elvisdt/PCB_INCLI_VA/docs/reference/ug230_superior.png

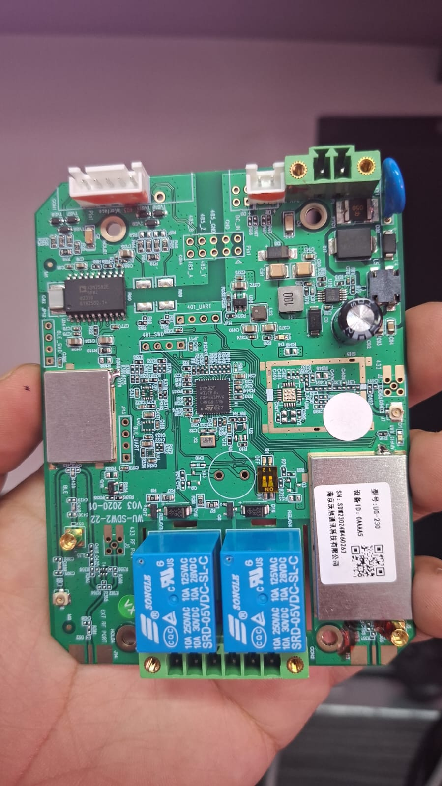
docs/reference/ug230_superior.png
