elvisdt/PCB_INCLI_VA/docs/reference/ug230_inferior.png

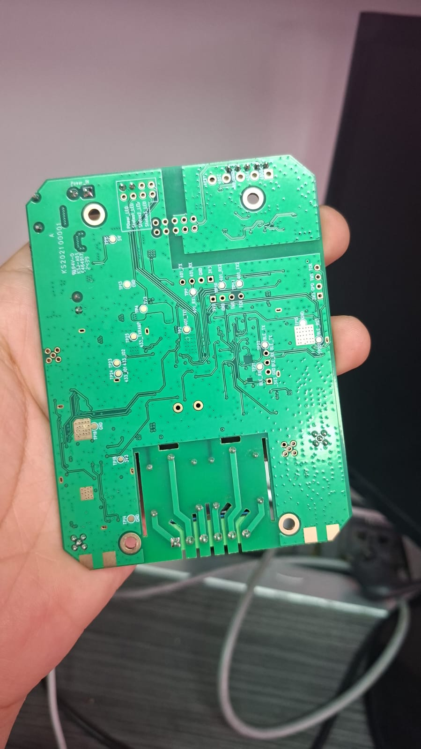
docs/reference/ug230_inferior.png
