elvisdt/PCB_INCLI_VA/docs/reference/logos/README.md

# Logos para serigrafía (B.Silkscreen)

| Archivo | Contenido | Estado |
|---|---|---|
| `volnyx_wordmark.png` | Wordmark "volnyx" en minúsculas con punto cuadrado, monocromo | Recreación para serigrafía según el logo elegido (oct 2026). Si existe el archivo original, reemplazarlo con el mismo nombre. |
| `volnyx_icon.png` | Ícono "vx" en recuadro redondeado, monocromo | Igual que arriba. Usar uno de los dos, no ambos, para no saturar. |
| `hunter.svg` / `hunter.png` | Logo de Hunter | **Pendiente:** el usuario debe dejar el archivo oficial (idealmente vectorial, pedido a marketing). |

Uso en KiCad: Image Converter (bitmap2component) → capa B.Silkscreen, 15–20 mm de ancho, trazo mínimo 0.15 mm, sin pisar TP, pads ni vías. Negro = serigrafía.
