elvisdt/PCB_INCLI_VA/docs/layout/correcciones-1ff3419-bottom.png

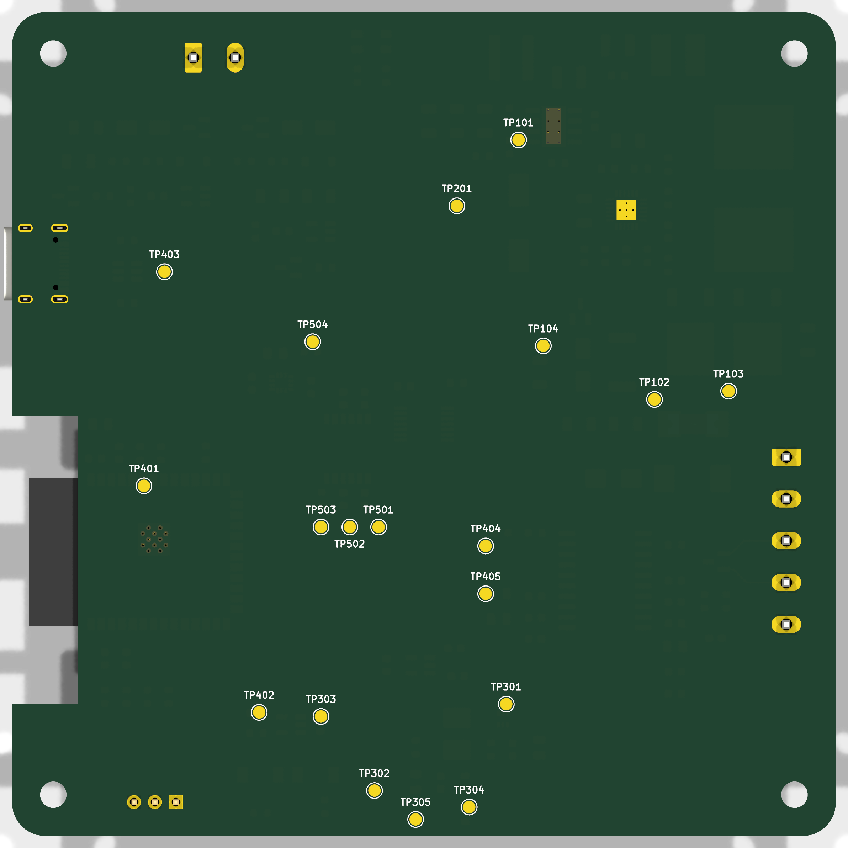
docs/layout/correcciones-1ff3419-bottom.png
