elvisdt/PCB_INCLI_VA/docs/layout/correcciones-1ff3419-top.png

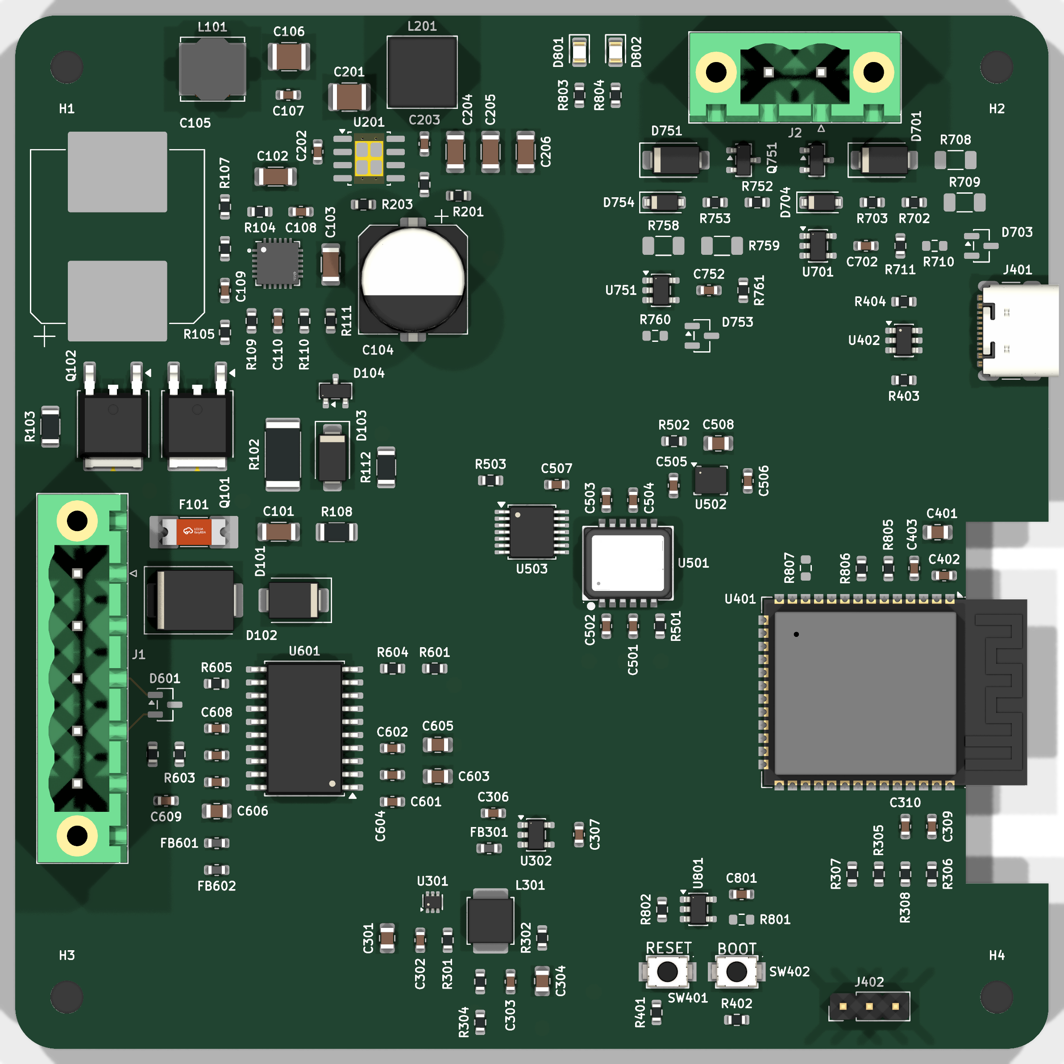
docs/layout/correcciones-1ff3419-top.png
