elvisdt/PCB_INCLI_VA/docs/layout/h5-serigrafia-bottom.png

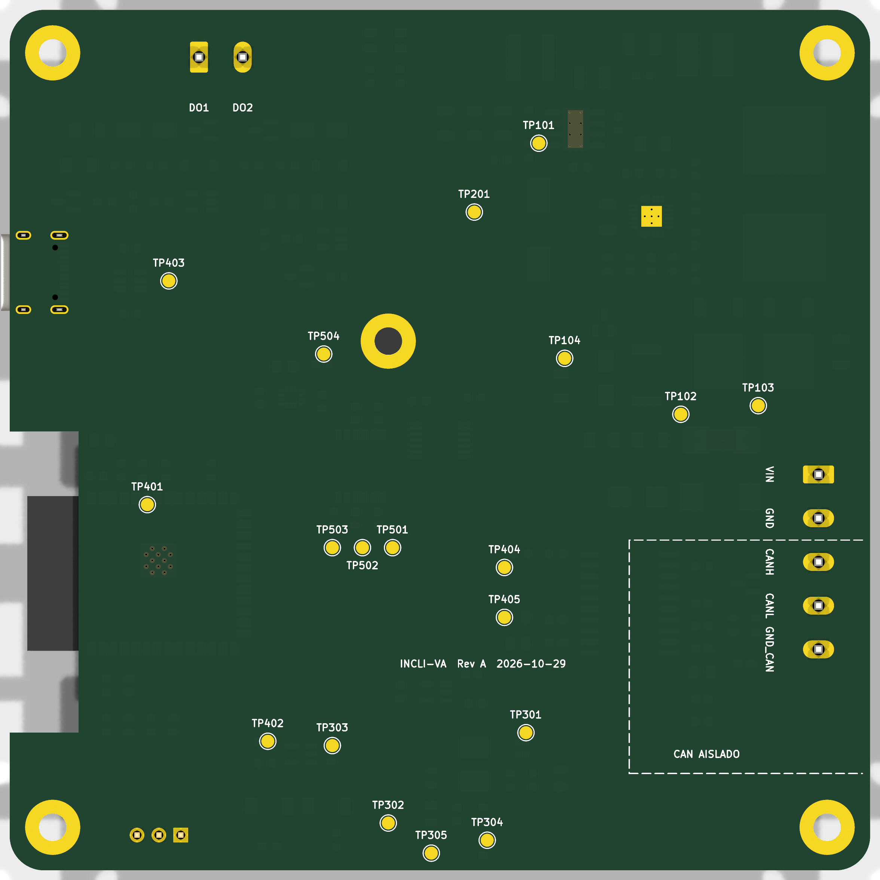
docs/layout/h5-serigrafia-bottom.png
