elvisdt/PCB_INCLI_VA/docs/layout/placement-v1-bottom.png

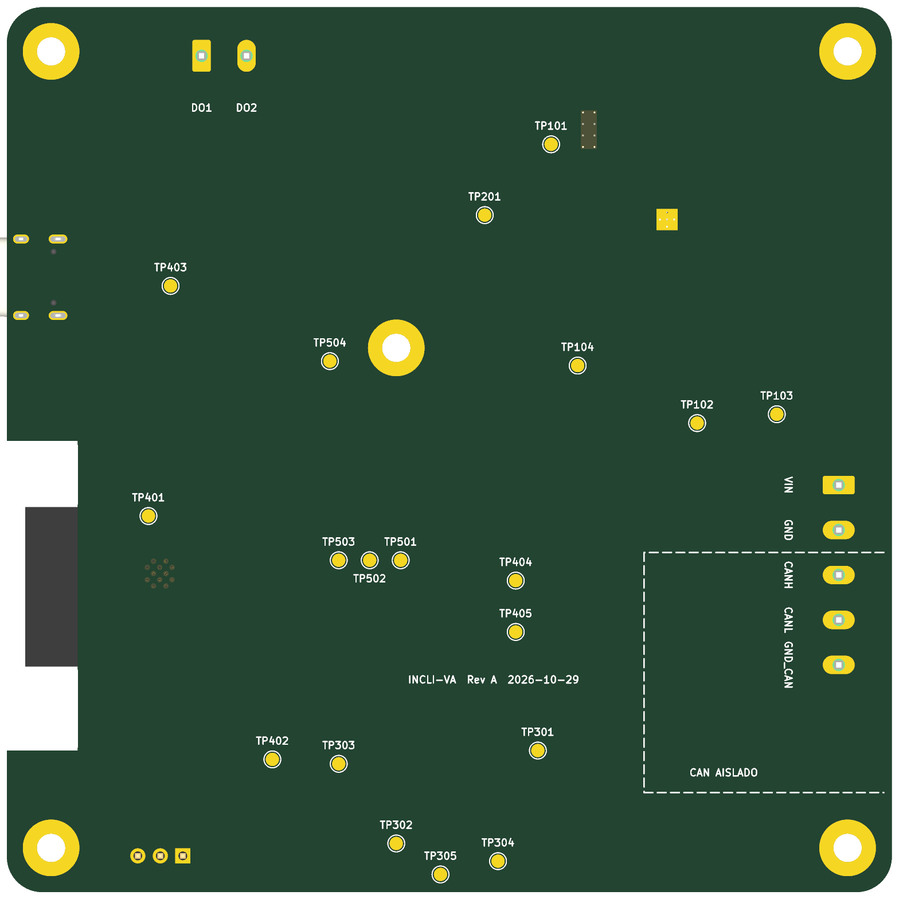
docs/layout/placement-v1-bottom.png
