elvisdt/PCB_INCLI_VA/docs/layout/placement-v1-top.png

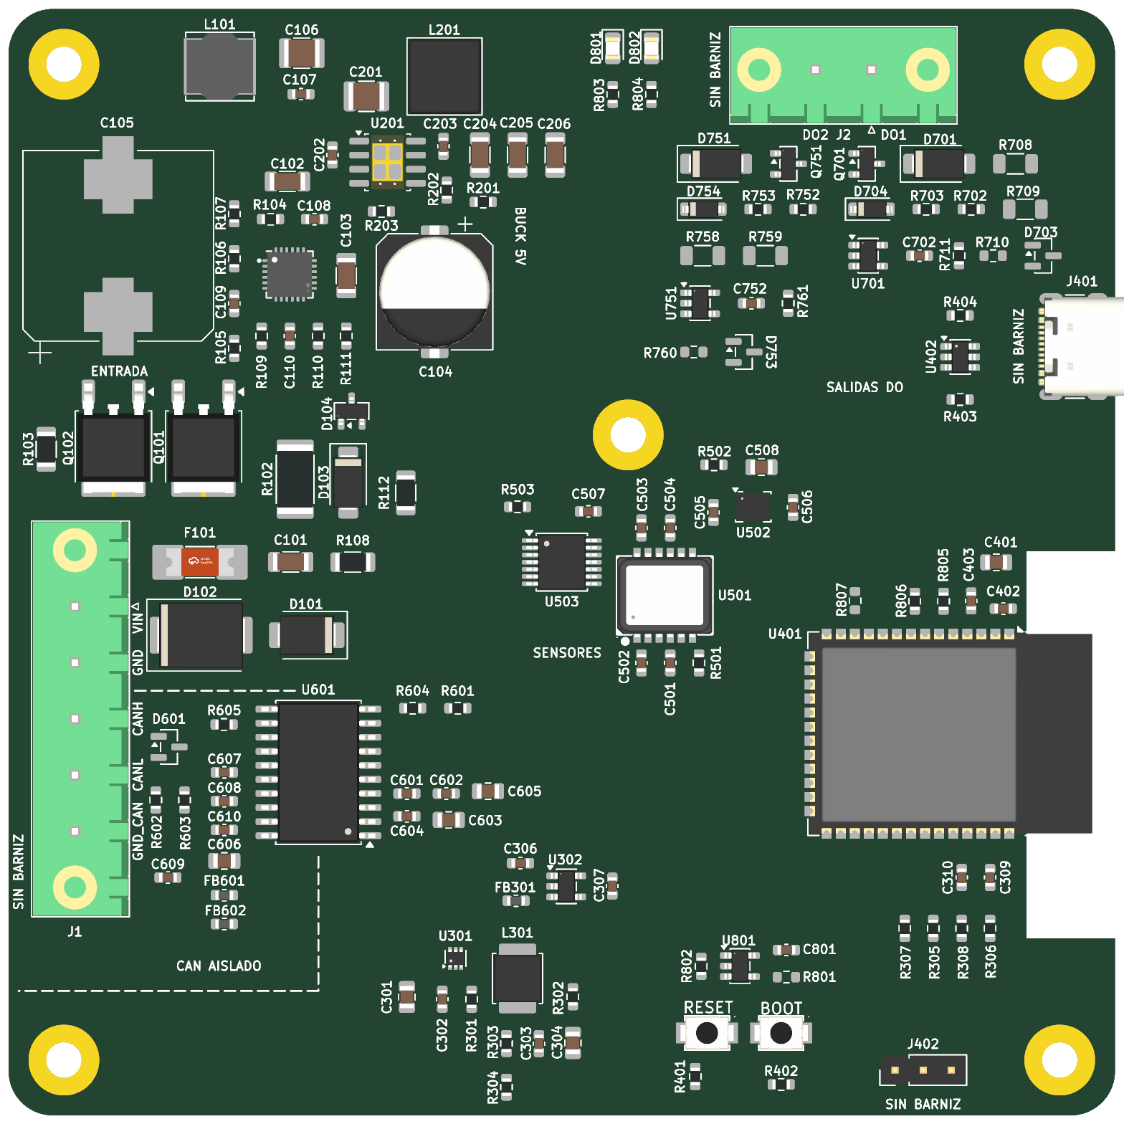
docs/layout/placement-v1-top.png
