elvisdt/PCB_INCLI_VA/docs/layout/rc6/bcu_entrada_rc5_rc6.png

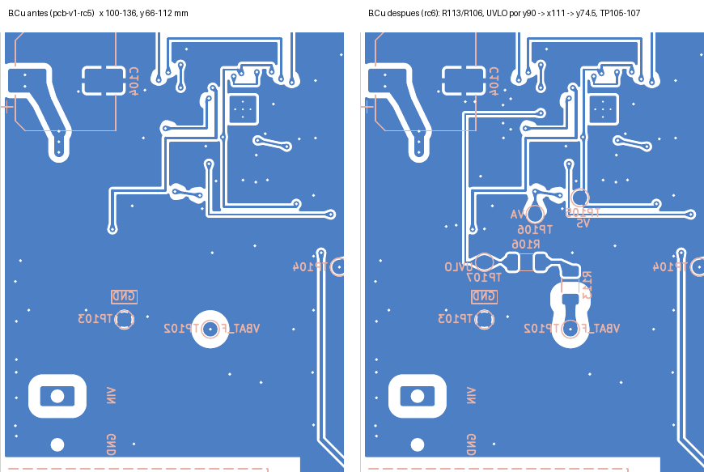
docs/layout/rc6/bcu_entrada_rc5_rc6.png
