elvisdt/PCB_INCLI_VA/docs/layout/rc7/jp601_cara_inferior.png

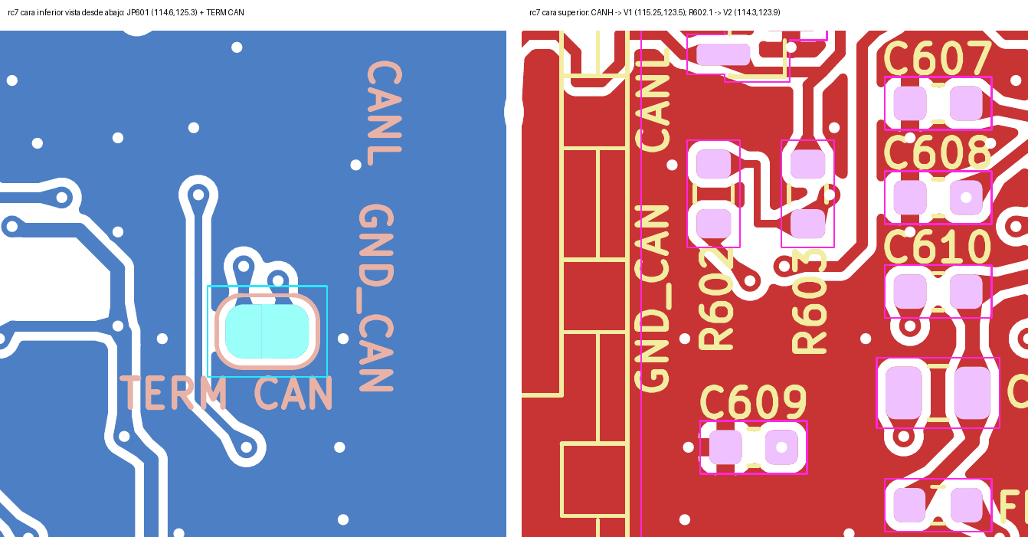
docs/layout/rc7/jp601_cara_inferior.png
