elvisdt/PCB_INCLI_VA/docs/layout/reacomodo-antes-despues.png

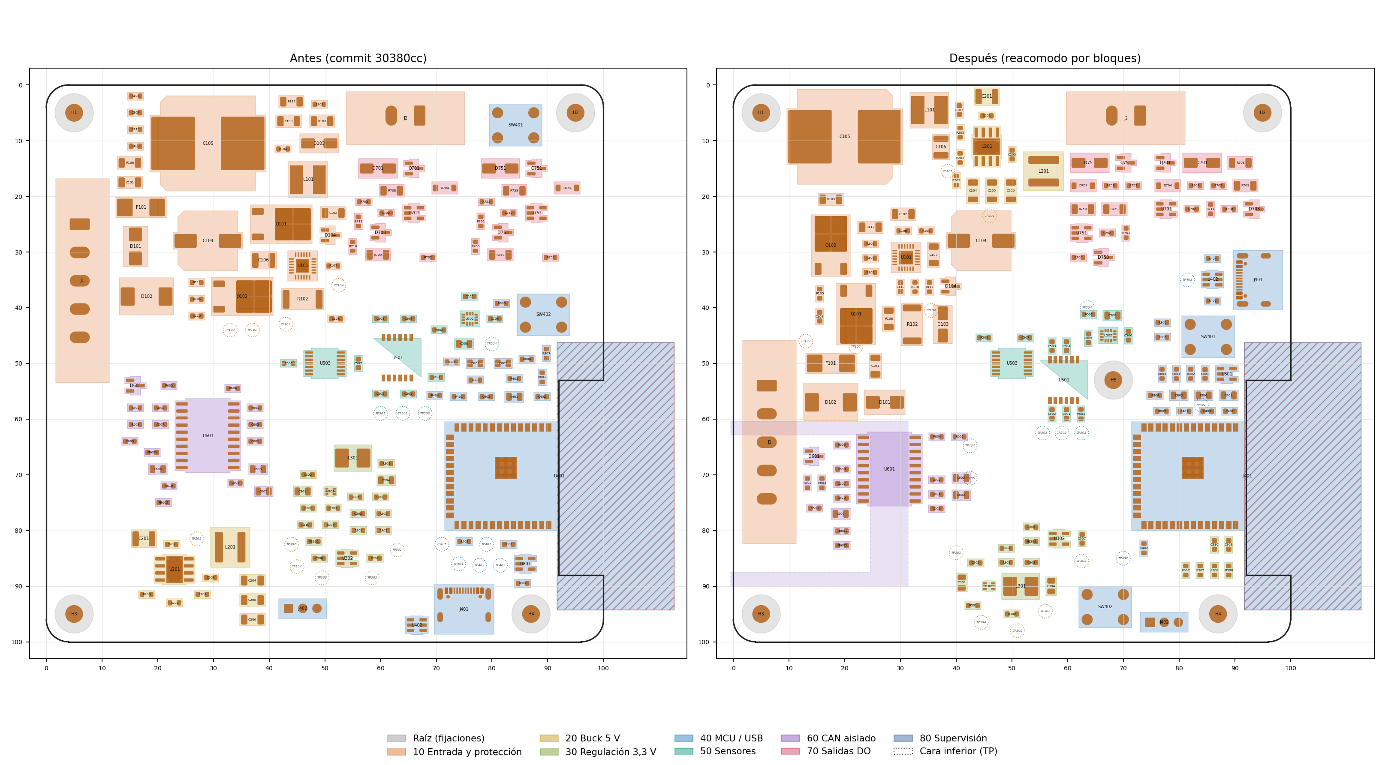
docs/layout/reacomodo-antes-despues.png
