elvisdt/PCB_INCLI_VA/docs/layout/ruteo/can-bcu-auditoria.png

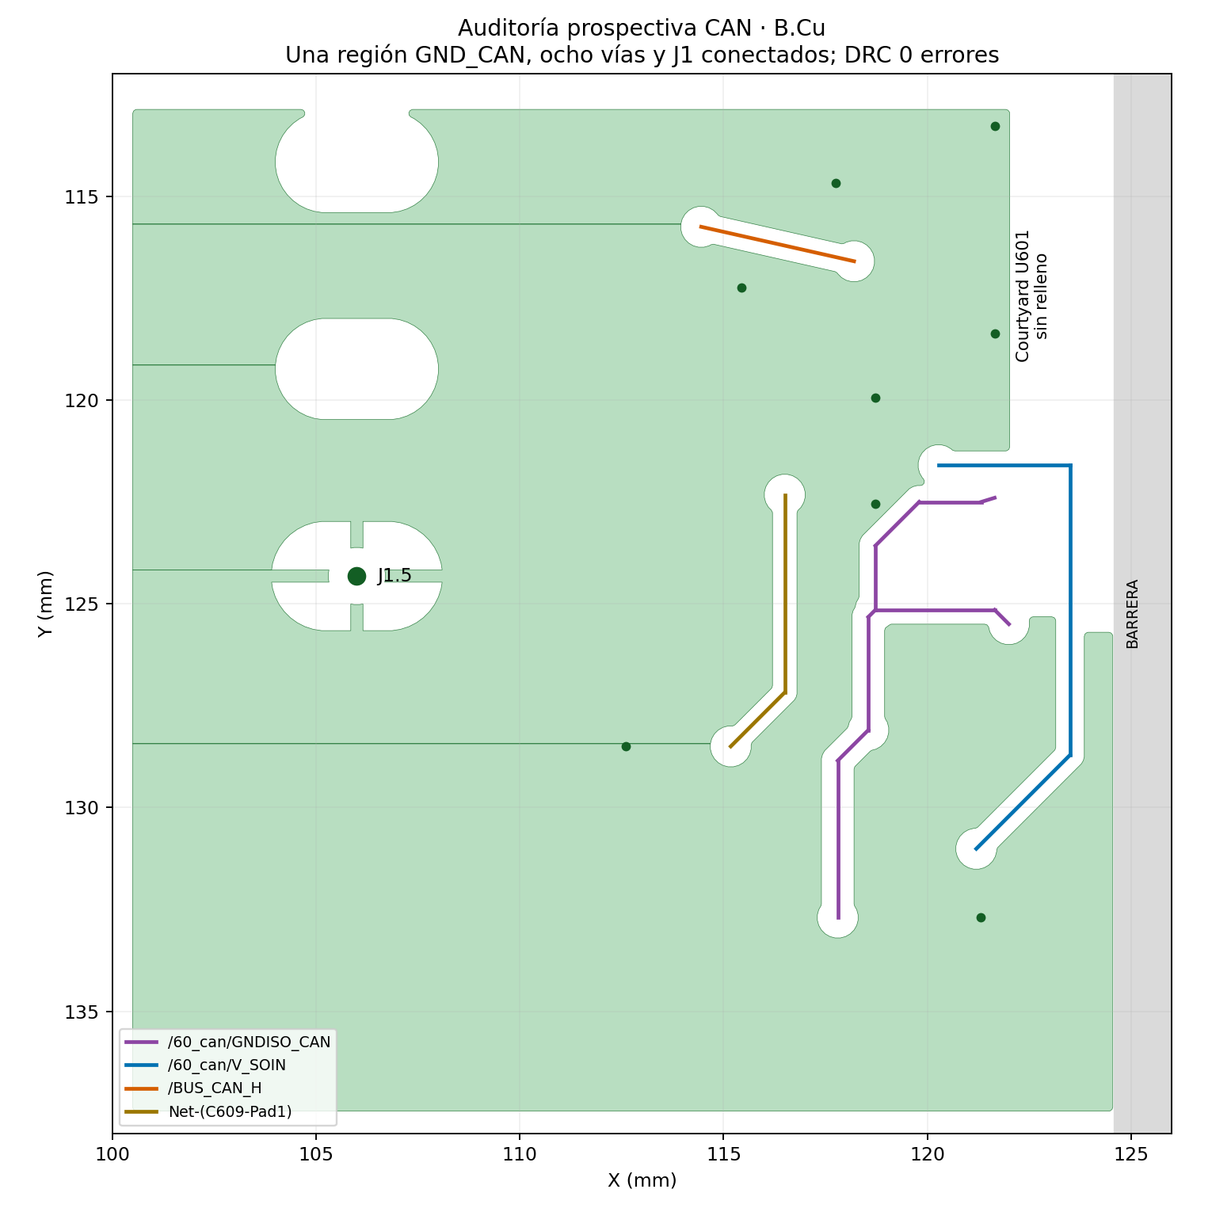
docs/layout/ruteo/can-bcu-auditoria.png
