elvisdt/PCB_INCLI_VA/docs/layout/ruteo/etapa3-hoja40.png

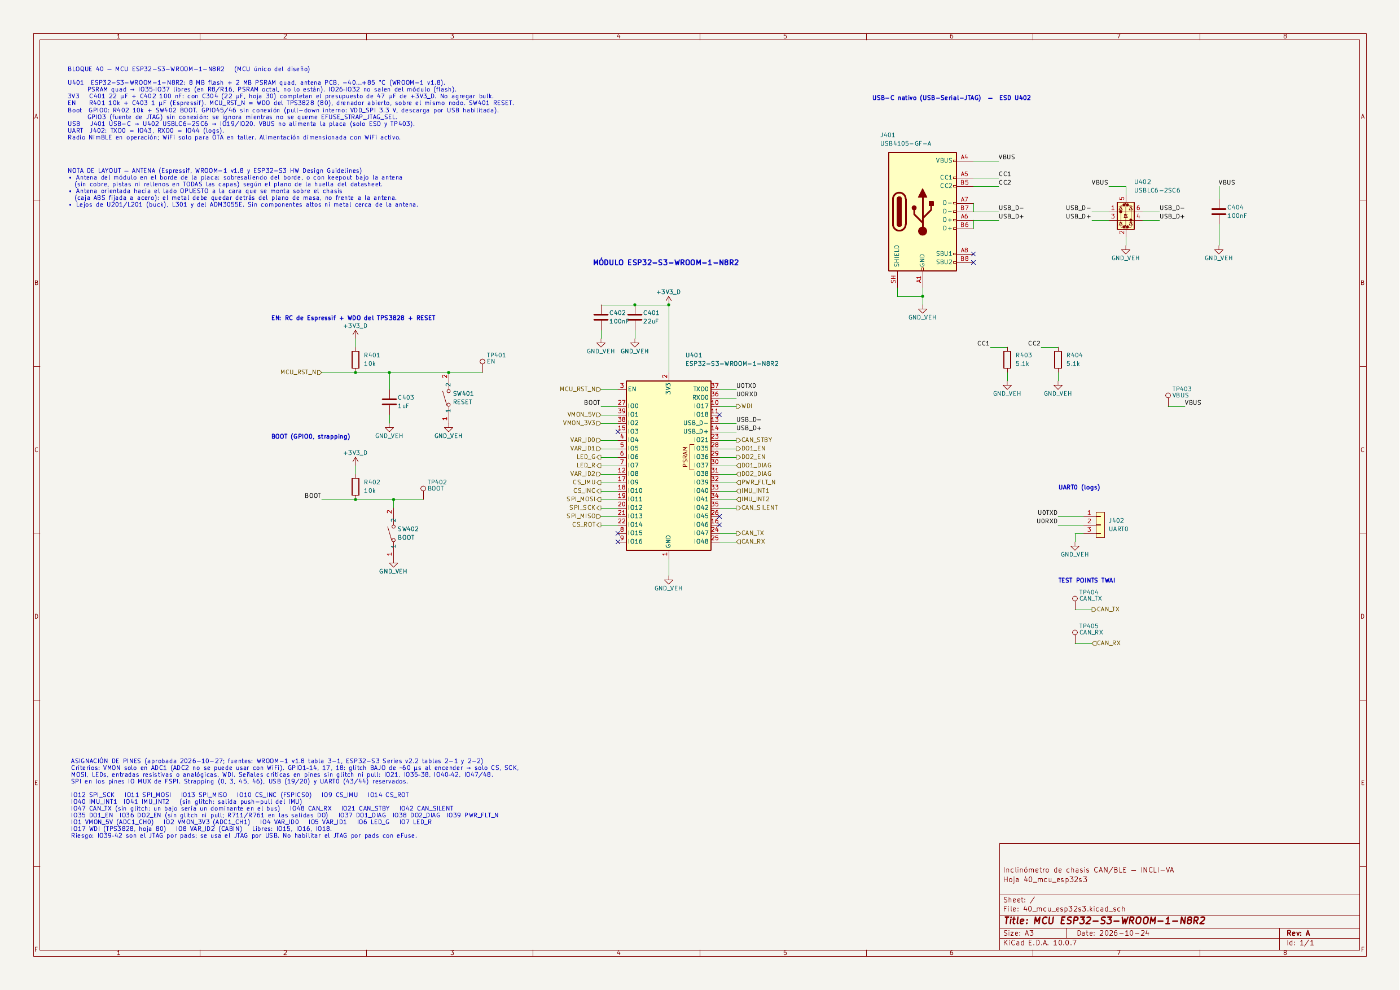
docs/layout/ruteo/etapa3-hoja40.png
