elvisdt/PCB_INCLI_VA/docs/layout/ruteo/etapa3-parcial-bottom.png

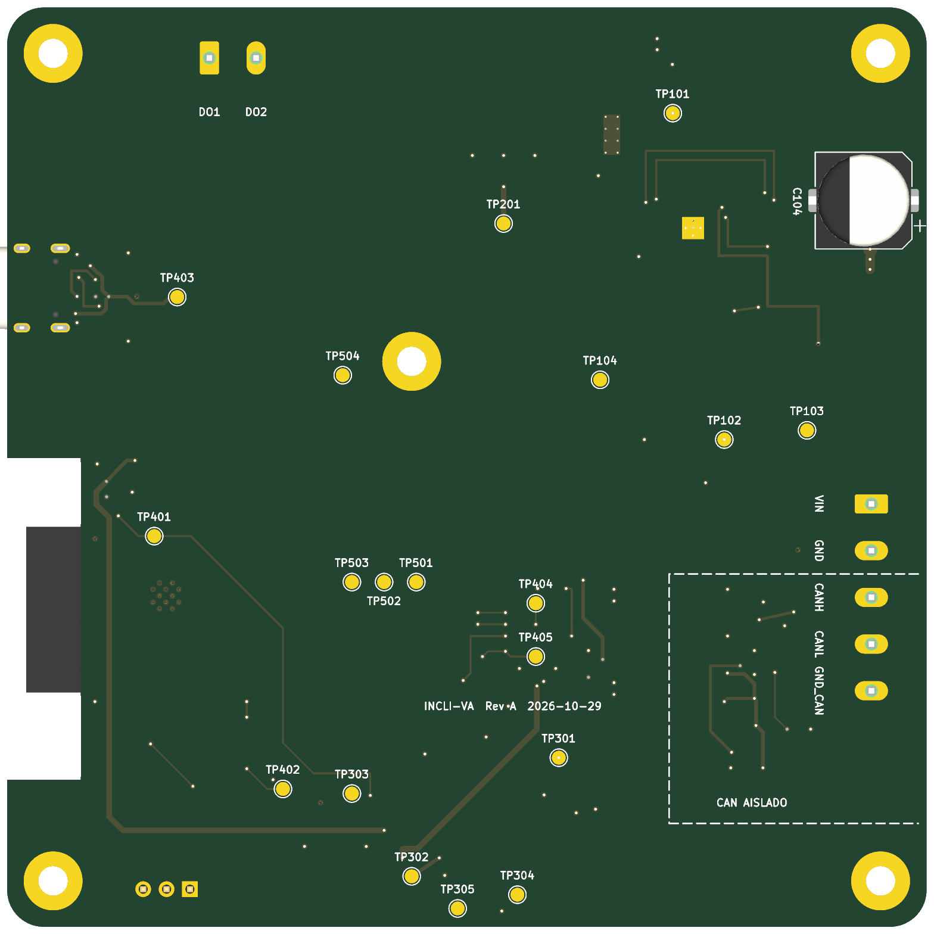
docs/layout/ruteo/etapa3-parcial-bottom.png
