elvisdt/PCB_INCLI_VA/docs/layout/ruteo/etapa3-propuesta-usb-escape.png

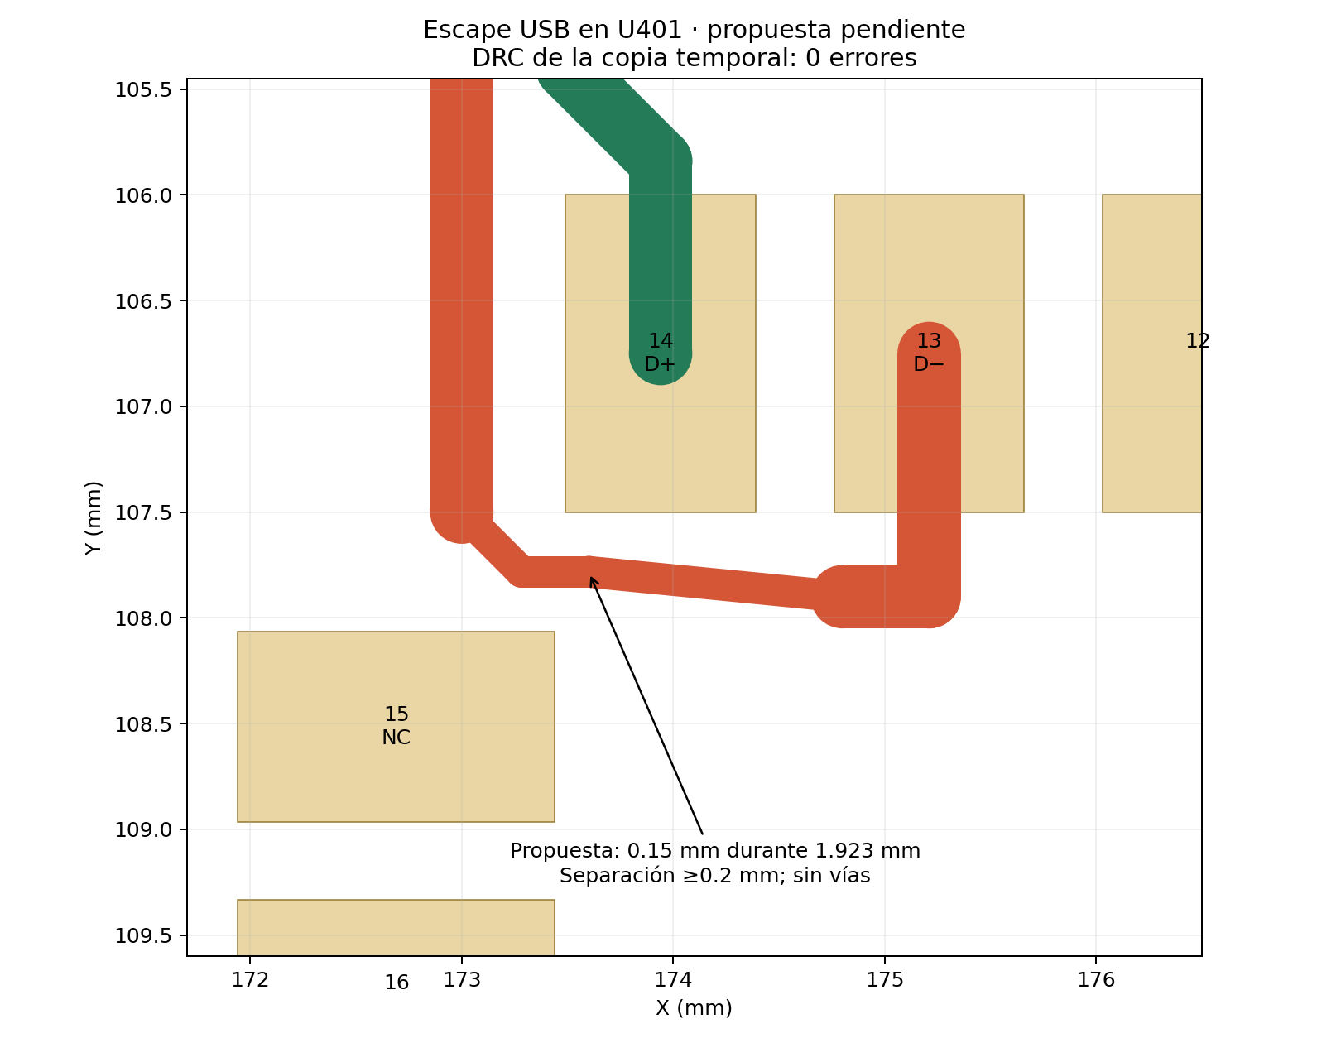
docs/layout/ruteo/etapa3-propuesta-usb-escape.png
