elvisdt/PCB_INCLI_VA/docs/layout/ruteo/etapa4-parcial-top.png

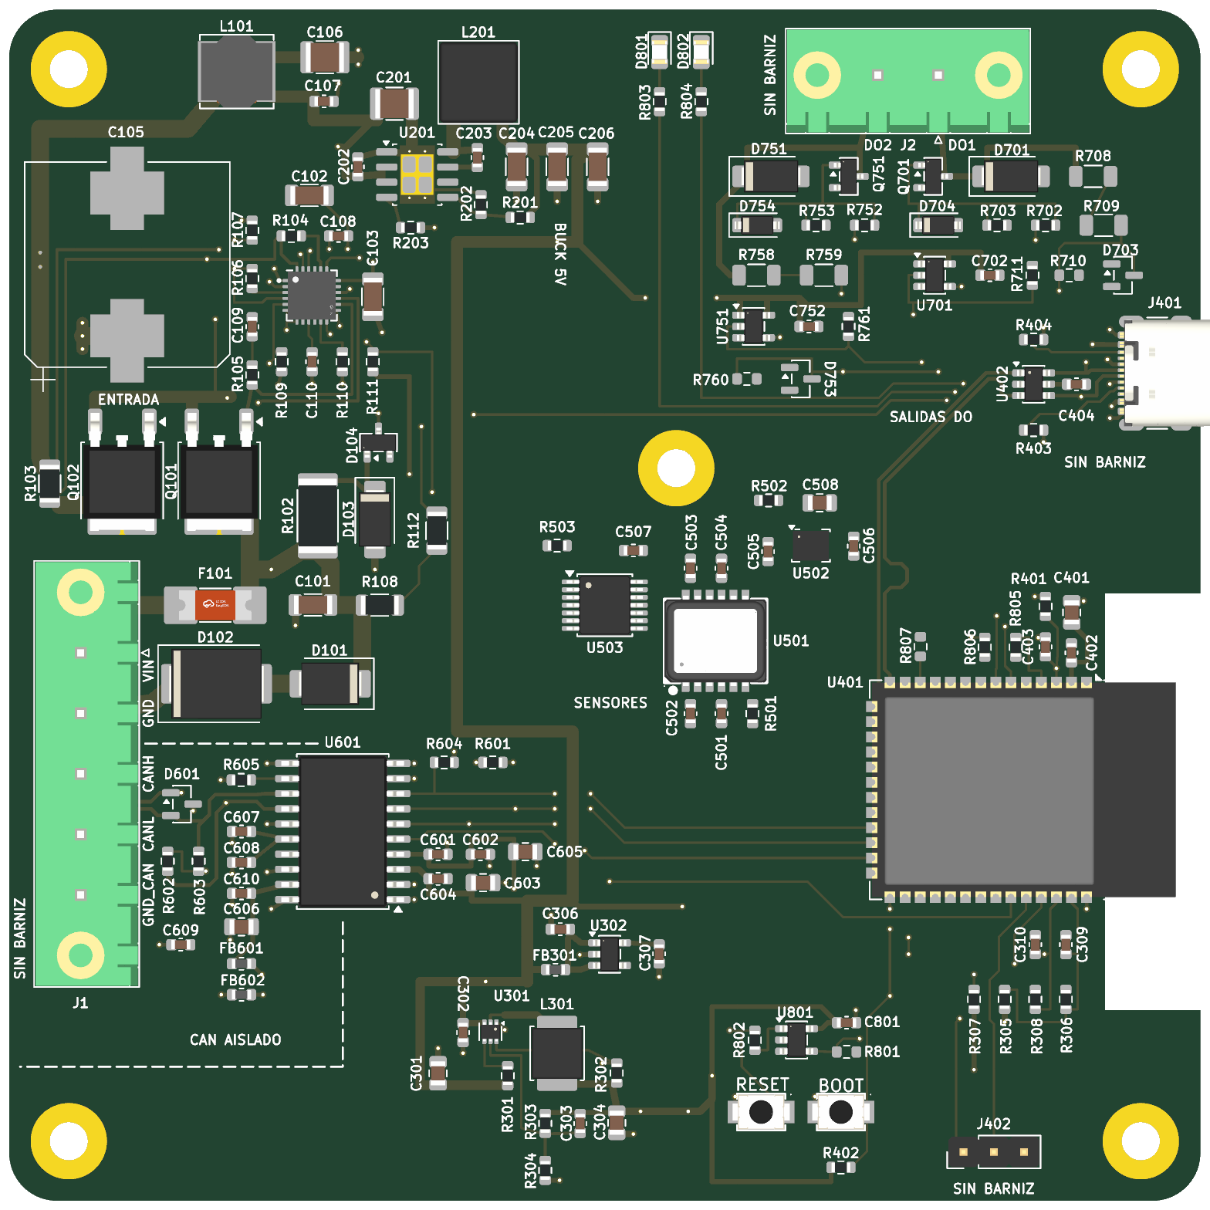
docs/layout/ruteo/etapa4-parcial-top.png
