elvisdt/PCB_INCLI_VA/docs/layout/ruteo/etapa4-sensores-cruces.png

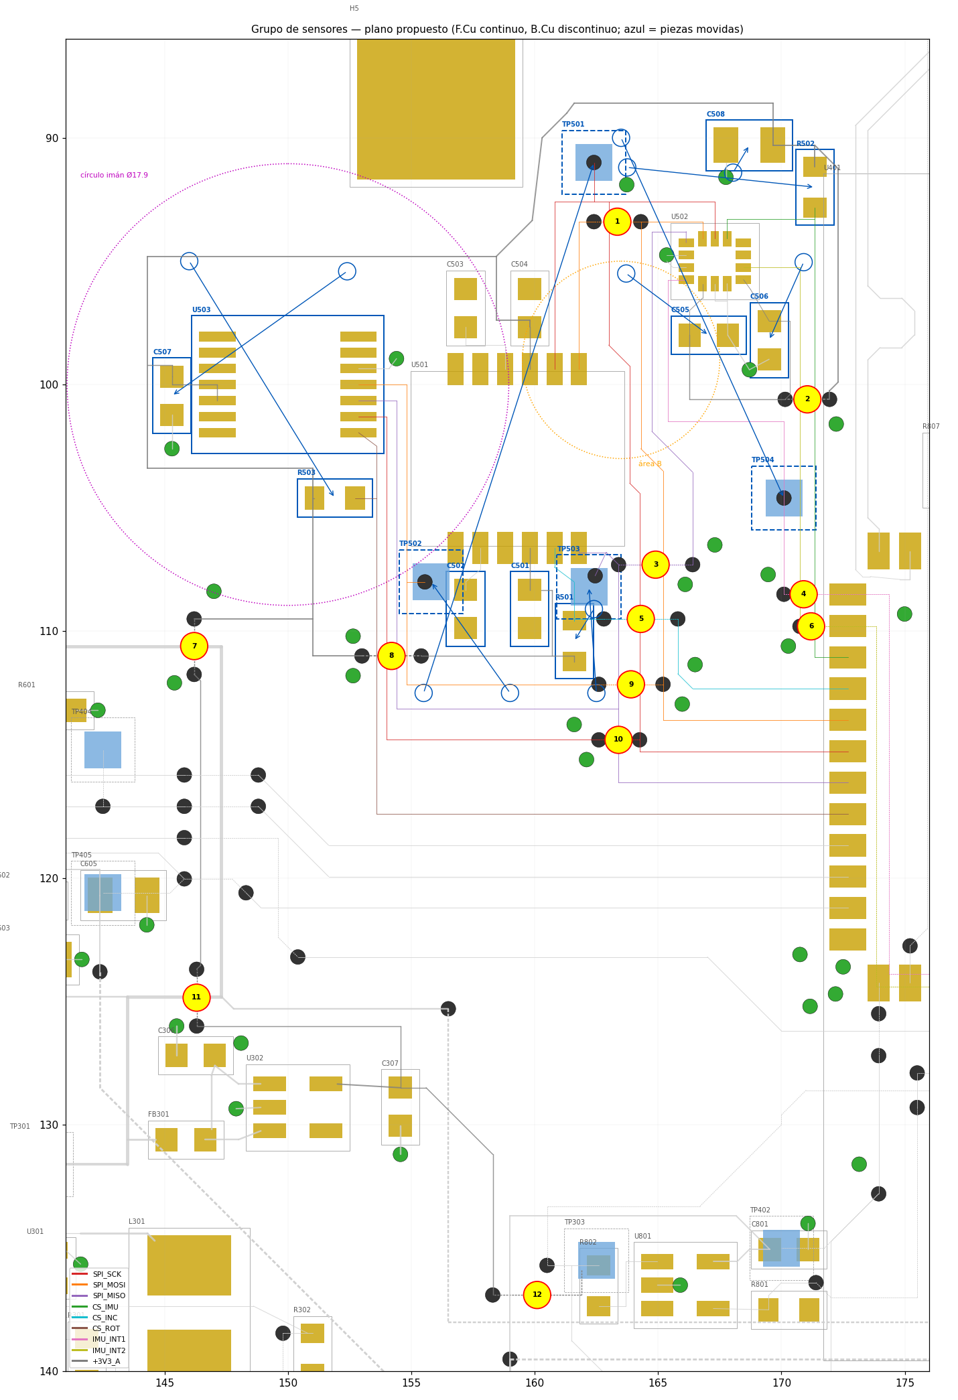
docs/layout/ruteo/etapa4-sensores-cruces.png
