elvisdt/PCB_INCLI_VA/docs/layout/ruteo/etapa5-bottom.png

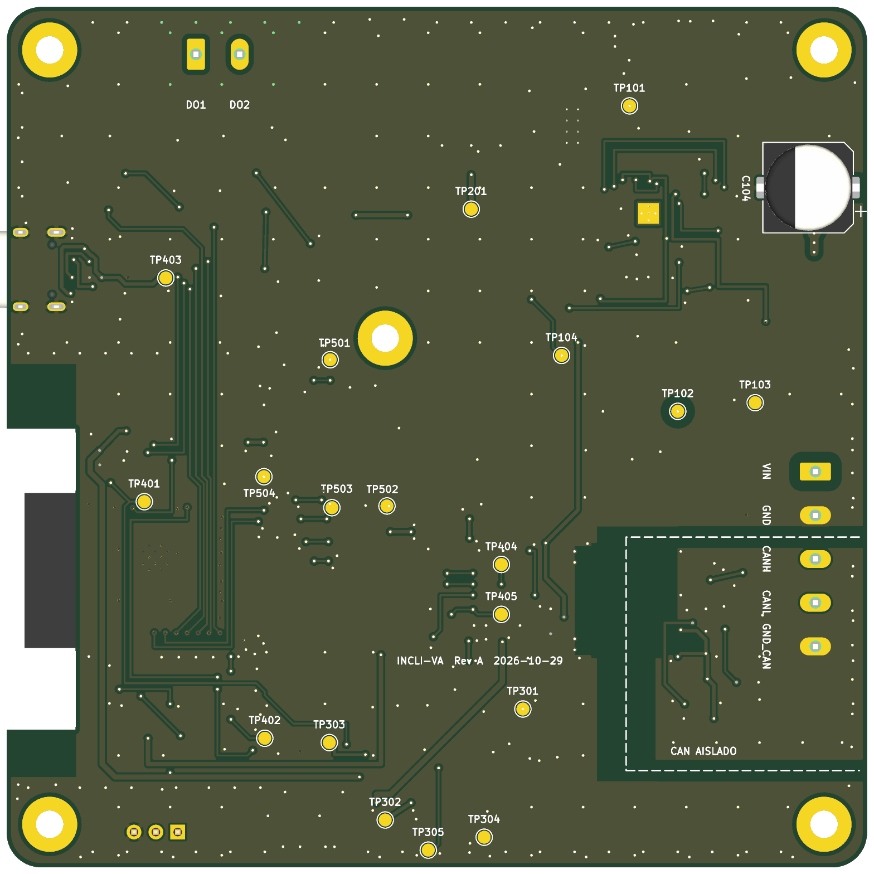
docs/layout/ruteo/etapa5-bottom.png
