elvisdt/PCB_INCLI_VA/docs/layout/ruteo/etapa5-capa-b_cu.png

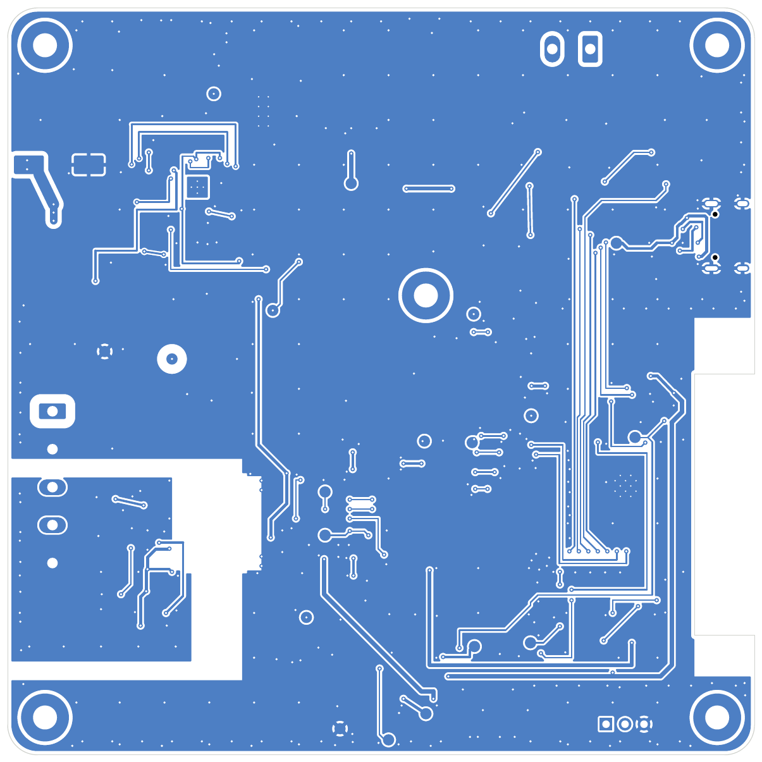
docs/layout/ruteo/etapa5-capa-b_cu.png
