elvisdt/PCB_INCLI_VA/docs/layout/ubicacion-100x100-bottom.png

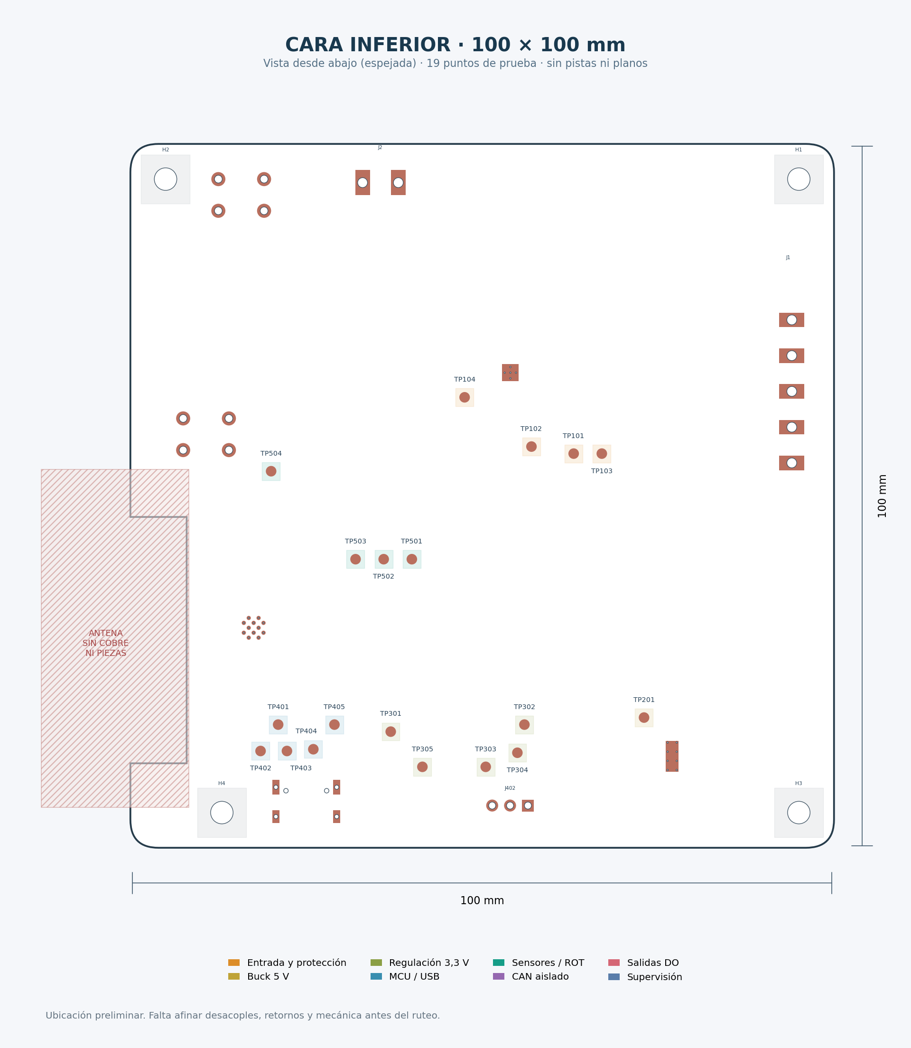
docs/layout/ubicacion-100x100-bottom.png
