elvisdt/PCB_INCLI_VA/docs/layout/ubicacion-120x80.png

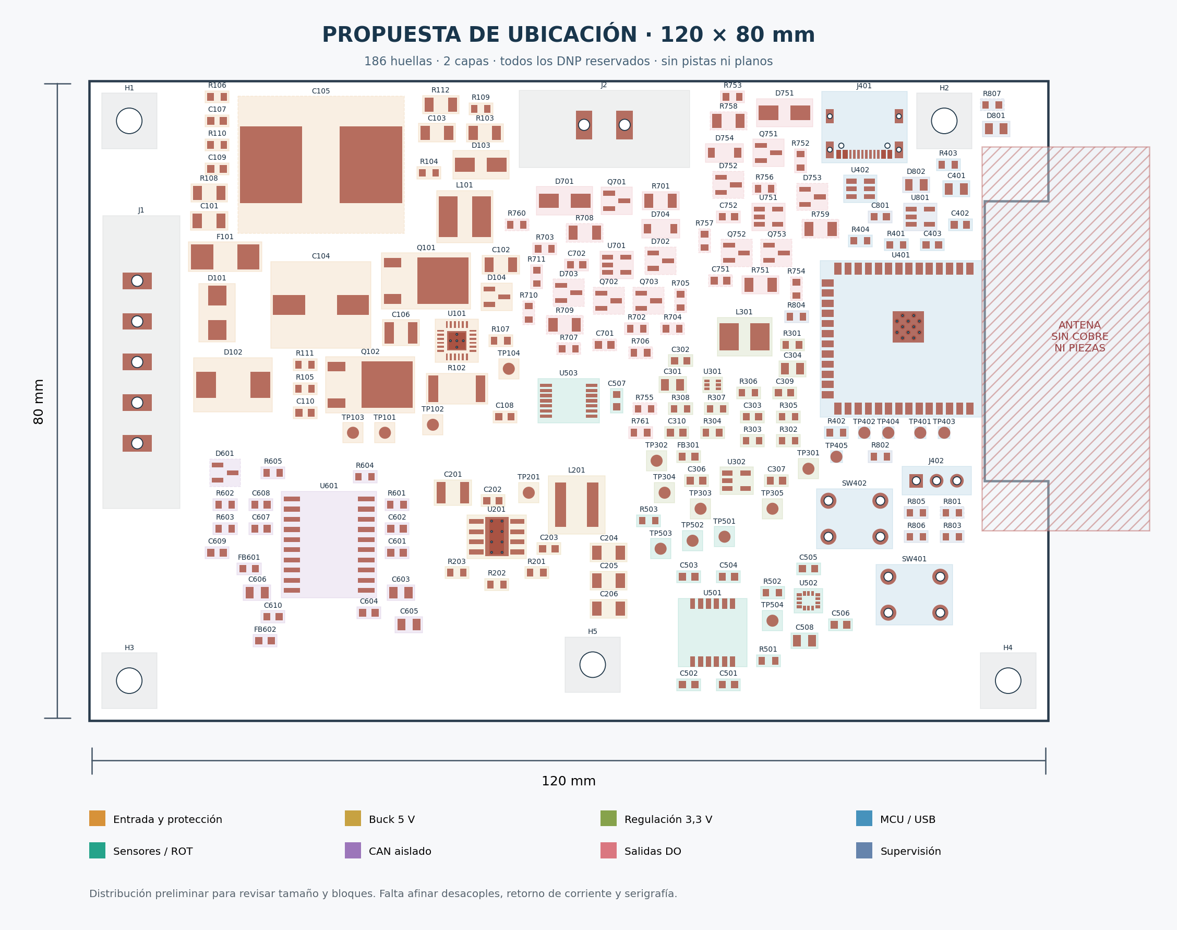
docs/layout/ubicacion-120x80.png
