elvisdt/PCB_INCLI_VA/docs/reference/inclimax_superior.png

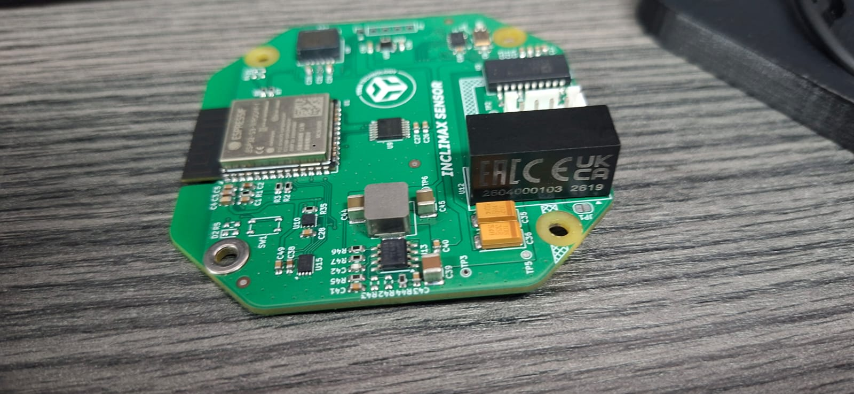
docs/reference/inclimax_superior.png
