elvisdt/PCB_INCLI_VA/bom/LCSC_BOM_COMPLETO_PROTO.csv

LCSC Part Number | Quantity | Manufacturer Part Number | Description | Designator
C106025 | 10 | C1206X104K451T | 100nF ±10% 450V Ceramic Capacitor X7R 1206 | C101
C13832 | 10 | CL31B105KCHNNNE | 1uF ±10% 100V Ceramic Capacitor X7R 1206 | C102,C103
C164068 | 5 | VZH470M2ATR-1010 | 47uF ±20% 100V Aluminum Electrolytic Capacitors 5000hrs@105℃ | C104
C138687 | 3 | CL32B106KBJNNNE | 10uF ±10% 50V Ceramic Capacitor X7R 1210 | C106
C88219 | 100 | 0603B104K101NT | 100nF ±10% 100V Ceramic Capacitor X7R 0603 | C107,C108,C109,C202,C203,C302,C309,C310,C402,C404,C501,C502,C503,C504,C505,C506,C507,C602,C604,C608,C702,C752,C801
C31658 | 50 | CL10B683KB8NNNC | 68nF ±10% 50V Ceramic Capacitor X7R 0603 | C110
C17288249 | 3 | CL32B475KCVZNWE | 4.7uF | C201
C126598 | 10 | GCM31CR71A226KE02L | 22uF ±10% 10V Ceramic Capacitor X7R 1206 | C204,C205,C206
C3039694 | 15 | CL21B106KAYQNNE | 10uF ±10% 25V Ceramic Capacitor X7R 0805 | C301,C508,C603,C605,C606
C106245 | 100 | CC0603JRNPO9BN100 | 10pF ±5% 50V Ceramic Capacitor NP0 0603 | C303
C907991 | 10 | GRM21BZ71A226ME15L | 22uF ±20% 10V Ceramic Capacitor X7R 0805 | C304,C401
C559769 | 20 | CC0603KRX7R9BB105 | 1uF ±10% 50V Ceramic Capacitor X7R 0603 | C306,C307,C403
C100042 | 100 | CC0603KRX7R9BB103 | 10nF ±10% 50V Ceramic Capacitor X7R 0603 | C601,C607
C426631 | 20 | GCM188R72A472KA37D | 4.7nF ±10% 100V Ceramic Capacitor X7R 0603 | C609
C21120 | 50 | CL10B224KA8NNNC | 220nF ±10% 25V Ceramic Capacitor X7R 0603 | C610
C2927419 | 5 | ES2G-E3/52T | Diode 400V 2A DO-214AA | D101
C438109 | 5 | SMCJ33A | 53.3VC Clamp 28.2A@10/1000us Ipp TVS DIODE SMC | D102
C366557 | 20 | SMAJ51A | 82.4VC Clamp 4.85A Ipp TVS DIODE SMA(DO-214AC) | D103
C150732 | 3 | BAV23C-7-F | Diode Array 1 Pair Common Cathode 200V 400mA Surface Mount SOT-23 | D104
C123816 | 20 | SMAJ58A | 93.6VC Clamp 4.3A@10/1000us Ipp TVS DIODE DO-214AC(SMA) | D701,D751
C500776 | 10 | MMSZ5242B-7-F | Zener Diode Independent 12V 370mW Surface Mount SOD-123 | D704,D754
C98224 | 20 | LTST-C171KGKT | Yellow Green 574nm LED Indication - Discrete 2V 0805 | D801
C284871 | 20 | LTST-C171KRKT | Red 639nm LED Indication - Discrete 2V 0805 | D802
C80165 | 50 | BLM18PG221SN1D | 220Ω@100MHz 1 Line Ferrite Bead 0603 1.4A 100mΩ | FB301
C113020 | 20 | BLM18BD182SN1D | 1.8kΩ@100MHz 1 Line Ferrite Bead 0603 150mA 1.5Ω | FB601,FB602
C7164734 | 3 | 1777109 | 5 Position 5.08mm Pitch Straight Pin | J1
C480552 | 3 | 1777073 | 2 Position Board Side/Socket - Closed 5.08mm Pitch Straight Pin | J2
C3020560 | 3 | USB4105-GF-A | USB Type C Receptacle for USB 2.0, SMT Type, PCB Top Mount | J401
C49257 | 20 | 2.54-1*3PPin | Pin Header 3 Position 2.54mm Pitch Single Row Through Hole -40℃~+105℃ | J402
C2046332 | 5 | SRN6045TA-100M | FIXED IND 10uH 3.2A 52mΩ SMD,6x6mm | L101
C4555951 | 3 | XAL4020-102MEC | FIXED IND 1000nH SMD,4x4mm | L301
C102615 | 10 | DMN10H220L-7 | N-Channel 100V 1.6A 1.3W Surface Mount SOT-23 | Q701,Q751
C469651 | 5 | AC2512FK-0710KL | RES 10kΩ ±1% 1W 2512 | R102
C2076185 | 5 | ERJ-8BWFR010V | RES 0.01Ω ±1% 1W 1206 | R103
C23185 | 100 | 0603WAF499JT5E | 49.9Ω ±1% 100mW 0603 Thick Film Resistor | R104
C22775 | 100 | 0603WAF1000T5E | 100Ω ±1% 100mW 0603 Thick Film Resistor | R105
C25803 | 100 | 0603WAF1003T5E | 100kΩ ±1% 100mW 0603 Thick Film Resistor | R201,R301,R302,R304,R305,R307,R308,R703,R711,R753,R761
C23127 | 100 | 0603WAF9531T5E | 9.53kΩ ±1% 100mW 0603 Thick Film Resistor | R107
C114947 | 50 | RC1206FR-0751KL | RES 51kΩ ±1% 250mW 1206 | R106,R108,R112,R113
C100797 | 100 | CR0603FA1621G | 1.62kΩ ±1% 100mW 0603 Thick Film Resistor | R109
C165742 | 100 | RC0603FR-0760K4L | RES 60.4kΩ ±1% 100mW 0603 | R110
C25804 | 100 | 0603WAF1002T5E | 10kΩ ±1% 100mW 0603 Thick Film Resistor | R111,R401,R402,R501,R502,R503,R601,R604
C227732 | 100 | AC0603FR-0724K9L | RES 24.9kΩ ±1% 100mW 0603 | R202
C228007 | 100 | AC0603FR-0764K9L | RES 64.9kΩ ±1% 100mW 0603 | R203
C101055 | 50 | CR0603FA4533G | 453kΩ ±1% 100mW 0603 Thick Film Resistor | R303
C23184 | 100 | 0603WAF4992T5E | 49.9kΩ ±1% 100mW 0603 Thick Film Resistor | R306
C23186 | 100 | 0603WAF5101T5E | 5.1kΩ ±1% 100mW 0603 Thick Film Resistor | R403,R404
C144645 | 100 | AC0603FR-0760R4L | RES 60.4Ω ±1% 100mW 0603 | R602,R603
C21189 | 100 | 0603WAF0000T5E | 0Ω ±1% 100mW 0603 Thick Film Resistor | R605,R802,R805,R806
C4190 | 100 | 0603WAF2201T5E | 2.2kΩ ±1% 100mW 0603 Thick Film Resistor | R702,R752,R803,R804
C720477 | 10 | TS-1088-AR02016 | Tactile Switch SPST 160gf 2mm SMD (SMT) Tab 4mm x 3mm Surface Mount | SW401,SW402
C22428070 | 3 | LM74930QRGERQ1 | Ideal Diode VQFN-24-EP(4x4) | U101
C5219310 | 3 | LMR38010SDDAR | Buck Switching Regulator IC Adjustable 1 Output 1A SOPowerPAD-8 | U201
C49259289 | 3 | TPS62A02QDRLRQ1 | TPS62A02QDRLRQ1 | U301
C130005 | 3 | LP5907QMFX-3.3Q1 | Linear Voltage Regulator IC Positive Fixed 1 Output 250mA SOT-23-5 | U302
C2913204 | 3 | ESP32-S3-WROOM-1-N8R2 | 2.4GHz Wi-Fi (802.11b/g/n) + Bluetooth 5 (LE) module | U401
C2687116 | 10 | USBLC6-2SC6 | 15VC Clamp ESD DIODE SOT-23-6 | U402
C3825395 | 3 | SCL3300-D01-10 | 3-axis inclinometer with angle output and digital SPI interface | U501
C459826 | 3 | ASM330LHHTR | Automotive 6-axis inertial module: 3D accelerometer and 3D gyroscope | U502
C658105 | 3 | ADM3055EBRIZ-RL | 5 kV rms/3 kV rms, Signal and Power Isolated, CAN Transceivers for CAN FD | U601
C163712 | 10 | SN74AHCT1G126DBVR | Single Bus Buffer Gate With 3-State Output | U701,U751
C20032 | 5 | TPS3828-33DBVR | Processor Supervisory Circuits | U801
