elvisdt/PCB_INCLI_VA/bom/BOM_PROD.csv

Comment | Designator | Footprint | Qty | MPN | Manufacturer | LCSC | JLC_Type | JLC_Stock | LCSC_Stock | Price_10_USD | Supplier | Assembly | Status | Orig_MPN | Orig_LCSC | Notes
100nF | C101 | C_1206_3216Metric | 1 | CGA5L4X7T2W104K160AA | TDK |  |  |  |  | 0.7901 (ref. LCSC) | DigiKey/Mouser | consigna JLC o mano | not at JLC, DigiKey/Mouser, checked 2026-10-30 |  | C3887150 | PROD mantiene el AEC-Q200 original (JLC/LCSC stock 1); el sustituto sin AEC-Q200 es solo para PROTO
1uF | C102,C103 | C_1206_3216Metric | 2 | CL31B105KCHNNNE | Samsung | C13832 | ext | 347728 | 261400 | 0.0650 | JLC | JLC | substitute CL31B105KCHNNNE for CGA5L2X7R2A105K160AA accepted 2026-10-30, JLC ext | CGA5L2X7R2A105K160AA | C2168321 | original stock 0; 1uF 100V X7R 1206, no AEC-Q200
47uF | C104 | CP_Elec_10x10 | 1 | EEE-HA2A470UP | Panasonic |  |  |  |  | 0.3957 (ref. LCSC) | DigiKey/Mouser | consigna JLC o mano | not at JLC, DigiKey/Mouser, checked 2026-10-30 |  | C344077 | PROD mantiene el AEC-Q200 original (JLC/LCSC stock 1); el sustituto sin AEC-Q200 es solo para PROTO
1000uF 50V | C105 | CP_Elec_Panasonic_J16_VibProof | 1 | EEE-FK1H102AV | Panasonic |  |  |  |  | 0.8694 (ref. LCSC) | DigiKey/Mouser | consigna JLC o mano | not at JLC, DigiKey/Mouser, checked 2026-10-30 |  | C2164039 | JLC/LCSC stock 0 (tambien Alt_MPN EEE-FK1H102AM)
10uF | C106 | C_1210_3225Metric | 1 | CL32B106KBJNNNE | Samsung | C138687 | ext | 101468 | 9473 | 0.2610 | JLC | JLC | substitute CL32B106KBJNNNE for GCM32ER71H106KA12L accepted 2026-10-30, JLC ext | GCM32ER71H106KA12L |  | original no listado en JLC; 10uF 50V X7R 1210. Alternativa automotriz: C126612 GCM32EC71H106KA03L (X7S)
100nF | C107,C108,C109,C202,C203,C302,C309,C310,C402,C404,C501,C502,C503,C504,C505,C506,C507,C602,C604,C608,C702,C752,C801 | C_0603_1608Metric | 23 | GCM188R72A104KA64D | Murata | C415406 | ext | 15215 | 10480 | 0.0637 | JLC | JLC | consolidado 2026-10-30: un solo MPN de 100 nF, 100 V X7R AEC-Q200 |  |  | 100nF 50V X7R 0603, no AEC-Q200
68nF | C110 | C_0603_1608Metric | 1 | CL10B683KB8NNNC | Samsung | C31658 | pref | 150525 | 115600 | 0.0190 (MOQ 50) | JLC | JLC | substitute CL10B683KB8NNNC for GCM188R71H683KA57D accepted 2026-10-30, JLC pref | GCM188R71H683KA57D | C380380 | original stock 0; 68nF 50V X7R 0603 (JLC pref)
4.7uF | C201 | C_1210_3225Metric | 1 | CGA6M3X7S2A475K200AB | TDK |  |  |  |  | 1.5766 (ref. LCSC) | DigiKey/Mouser | consigna JLC o mano | not at JLC, DigiKey/Mouser, checked 2026-10-30 |  | C2168848 | PROD mantiene el AEC-Q200 original (JLC/LCSC stock 0); el sustituto sin AEC-Q200 es solo para PROTO
22uF | C204,C205,C206 | C_1206_3216Metric | 3 | GCM31CR71A226KE02L | Murata | C126598 | ext | 13053 | 11240 | 0.3296 | JLC | JLC | JLC ext, verified 2026-10-30
10uF | C301,C508,C603,C605,C606 | C_0805_2012Metric | 5 | GCM21BR71A106KE22L | Murata | C126586 | ext | 9971 | 0 | 0.1029 | JLC | JLC | JLC ext, verified 2026-10-30
10pF | C303 | C_0603_1608Metric | 1 | CL10C100JB8NNNC | Samsung | C1634 | basic | 1212785 | 100 | 0.0061 (MOQ 100) | JLC | JLC | JLC basic (swap from GCM1885C1H100JA16D), verified 2026-10-30 | GCM1885C1H100JA16D | C126542 | original stock 0; 10pF 50V C0G 0603
22uF | C304,C401 | C_0805_2012Metric | 2 | GRM21BZ71A226ME15L | Murata | C907991 | ext | 166294 | 140195 | 0.3744 | JLC | JLC | JLC ext, verified 2026-10-30
1uF | C306,C307,C403 | C_0603_1608Metric | 3 | GCM188R71C105KA64D | Murata | C161212 | ext | 33722 | 18280 | 0.0383 (MOQ 20) | JLC | JLC | JLC ext, verified 2026-10-30
10nF | C601,C607 | C_0603_1608Metric | 2 | 0603B103K500NT | FH | C57112 | basic | 5628260 | 28450 | 0.0098 (MOQ 50) | JLC | JLC | JLC basic (swap from GCM188R71H103KA37D), verified 2026-10-30 | GCM188R71H103KA37D | C85863 | 10nF 50V X7R 0603, no AEC-Q200
4.7nF | C609 | C_0603_1608Metric | 1 | GCM188R72A472KA37D | Murata | C426631 | ext | 16111 | 16100 | 0.0288 (MOQ 20) | JLC | JLC | JLC ext, verified 2026-10-30
220nF | C610 | C_0603_1608Metric | 1 | CL10B224KA8NNNC | Samsung | C21120 | basic | 1011962 | 394350 | 0.0094 (MOQ 50) | JLC | JLC | JLC basic (swap from GCM188R71E224KA55D), verified 2026-10-30 | GCM188R71E224KA55D | C161217 | 220nF 25V X7R 0603, no AEC-Q200
ES2G | D101 | D_SMB | 1 | ES2G-E3/52T | Vishay | C2927419 | ext | 8924 | 8920 | 0.1781 | JLC | JLC | JLC ext, verified 2026-10-30
SMCJ33A | D102 | D_SMC | 1 | SMCJ33A | Littelfuse | C438109 | ext | 26629 | 26625 | 0.1049 | JLC | JLC | JLC ext, verified 2026-10-30
SMAJ51A | D103 | D_SMA | 1 | SMAJ51A | Littelfuse | C366557 | ext | 5525 | 5520 | 0.0314 (MOQ 20) | JLC | JLC | JLC ext, verified 2026-10-30
BAV23C | D104 | SOT-23 | 1 | BAV23C,215 | Nexperia | C282370 | ext | 0 | 0 | 0.1158 (ref. LCSC, MOQ 5) | DigiKey/Mouser | consigna JLC o mano | not at JLC/LCSC (stock 0), DigiKey/Mouser, checked 2026-10-30 |  |  | rc6 R-02 (D1 de TI fig. 8-1 dentro de D104); PROD automotriz: evaluar BAV23CQ
SMAJ58A | D701,D751 | D_SMA | 2 | SMAJ58A | Littelfuse | C123816 | ext | 15859 | 15840 | 0.0456 (MOQ 20) | JLC | JLC | JLC ext, verified 2026-10-30
BZX84-C3V3 | D703,D753 | SOT-23 | 2 | BZX84-C3V3,215 | Nexperia | C85087 | ext | 28154 | 28150 | 0.0180 (MOQ 50) | JLC | JLC | JLC ext, verified 2026-10-30
12V | D704,D754 | D_SOD-123 | 2 | MMSZ5242B-7-F | Diodes Incorporated | C500776 | ext | 97152 | 97150 | 0.0450 | JLC | JLC | JLC ext, verified 2026-10-30
2A 250VDC | F101 | Fuse_Bourns_SF-2410 | 1 | SF-2410FPA200W-2 | Bourns |  |  |  |  | 1.0524 (ref. LCSC) | DigiKey/Mouser | consigna JLC o mano | not at JLC, DigiKey/Mouser, checked 2026-10-30 |  | C3159902 | JLC/LCSC stock 0; sustituto AEM MF2410 rechazado (proteccion de entrada, el prototipo valida el diseno de produccion)
220R@100MHz | FB301 | L_0603_1608Metric | 1 | BLM18PG221SN1D | Murata | C80165 | ext | 243305 | 235750 | 0.0149 (MOQ 50) | JLC | JLC | JLC ext, verified 2026-10-30
1.8k@100MHz | FB601,FB602 | L_0603_1608Metric | 2 | BLM18BD182SN1D | Murata | C113020 | ext | 5170 | 5160 | 0.0362 (MOQ 20) | JLC | JLC | JLC ext, verified 2026-10-30
MSTBV 2,5/5-GF-5,08 | J1 | PhoenixContact_MSTBV_2,5_5-GF-5,08_1x05_P5.08mm_Vertical_ThreadedFlange | 1 | 1777109 | Phoenix Contact | C7164734 | ext | 327 | 317 | 0.9724 | LCSC | mano | JLC ext, verified 2026-10-30
MSTBV 2,5/2-GF-5,08 | J2 | PhoenixContact_MSTBV_2,5_2-GF-5,08_1x02_P5.08mm_Vertical_ThreadedFlange | 1 | 1777073 | Phoenix Contact | C480552 | ext | 837 | 835 | 1.1001 | LCSC | mano | JLC ext, verified 2026-10-30
USB4105-GF-A | J401 | USB_C_Receptacle_GCT_USB4105-xx-A_16P_TopMnt_Horizontal | 1 | USB4105-GF-A | GCT | C3020560 | ext | 3189 | 413 | 1.1001 | LCSC | mano | JLC ext, verified 2026-10-30
UART0 | J402 | PinHeader_1x03_P2.54mm_Vertical | 1 | 2.54-1*3PPin | BOOMELE | C49257 | ext | 151423 | 151440 | 0.0286 (MOQ 20) | LCSC | mano | substitute 2.54-1*3PPin for 61300311121 accepted 2026-10-30, JLC ext | 61300311121 | C2915006 | Wurth 61300311121 solo en JLC, no en lcsc.com; tira 1x3 2.54 mm generica
10uH | L101 | L_Bourns_SRN6045TA | 1 | SRN6045TA-100M | Bourns | C2046332 | ext | 6156 | 6045 | 0.2544 | JLC | JLC | JLC ext, verified 2026-10-30
33uH | L201 | L_Coilcraft_XAL6060-XXX | 1 | XAL6060-333MEC | Coilcraft |  |  |  |  | 2.8281 (ref. LCSC) | DigiKey/Mouser | consigna JLC o mano | not at JLC, DigiKey/Mouser, checked 2026-10-30 |  | C5119929 | JLC/LCSC stock 0; sin equivalente 33uH en la misma huella
1uH | L301 | L_Coilcraft_XAL4020_HandSolder | 1 | XAL4020-102MEC | Coilcraft | C4555951 | ext | 7626 | 7626 | 4.2523 | JLC | JLC | JLC ext, verified 2026-10-30
STD18NF25 | Q101 | TO-252-2 | 1 | STD18NF25 | STMicroelectronics |  |  |  |  | 5.3743 (ref. LCSC) | DigiKey/Mouser | consigna JLC o mano | not at JLC, DigiKey/Mouser, checked 2026-10-30 |  | C183634 | JLC/LCSC stock 0; sustituto AOD458 rechazado (proteccion de entrada)
IPD30N10S3L-34 | Q102 | TO-252-2 | 1 | IPD30N10S3L34ATMA1 | Infineon |  |  |  |  | 1.2069 (ref. LCSC) | DigiKey/Mouser | consigna JLC o mano | not at JLC, DigiKey/Mouser, checked 2026-10-30 |  | C148263 | JLC/LCSC stock 0; sustituto IRLR3110Z rechazado (proteccion de entrada)
DMN10H220LQ | Q701,Q751 | SOT-23 | 2 | DMN10H220LQ-7 | Diodes Incorporated | C5260572 | ext | 4738 | 4595 | 0.2997 | JLC | JLC | JLC ext, verified 2026-10-30
10k | R102 | R_2512_6332Metric | 1 | AC2512FK-0710KL | Yageo | C469651 | ext | 1508 | 1505 | 0.0933 | JLC | JLC | JLC ext, verified 2026-10-30
10m | R103 | R_1206_3216Metric | 1 | ERJ-8BWFR010V | Panasonic | C2076185 | ext | 5332 | 4125 | 0.1219 | JLC | JLC | JLC ext, verified 2026-10-30
49.9 | R104 | R_0603_1608Metric | 1 | 0603WAF499JT5E | UNI-ROYAL | C23185 | basic | 1388908 | 411400 | 0.0021 (MOQ 100) | JLC | JLC | JLC basic (swap from AC0603FR-0749R9L), verified 2026-10-30 | AC0603FR-0749R9L | C144653 | 1% 0603
100 | R105 | R_0603_1608Metric | 1 | 0603WAF1000T5E | UNI-ROYAL | C22775 | basic | 9522722 | 1107900 | 0.0024 (MOQ 100) | JLC | JLC | JLC basic (swap from AC0603FR-07100RL), verified 2026-10-30 | AC0603FR-07100RL | C125923 | 1% 0603
100k | R201,R301,R302,R304,R305,R307,R308,R703,R711,R753,R761 | R_0603_1608Metric | 11 | 0603WAF1003T5E | UNI-ROYAL | C25803 | basic | 17755977 | 8896900 | 0.0030 (MOQ 100) | JLC | JLC | JLC basic (swap from AC0603FR-07100KL), verified 2026-10-30 | AC0603FR-07100KL | C116674 | 1% 0603 thick film
9.53k | R107 | R_0603_1608Metric | 1 | AC0603FR-079K53L | Yageo | C228113 | ext | 3289 | 3200 | 0.0067 (MOQ 100) | JLC | JLC | JLC ext, verified 2026-10-30 (rc6) |  |  | rc6 R-01 (UVLO 6.44 V)
51k | R106,R108,R112,R113 | R_1206_3216Metric | 4 | RC1206FR-0751KL | Yageo | C114947 | ext | 140795 | 131250 | 0.0113 (MOQ 50) | JLC | JLC | substitute RC1206FR-0751KL for AC1206FR-0751KL accepted 2026-10-30, JLC ext | AC1206FR-0751KL | C144484 | original stock 1; 51k 1% 1206 200V 0.25W
1.62k | R109 | R_0603_1608Metric | 1 | CR0603FA1621G | LIZ | C100797 | ext | 1100 | 1100 | 0.0014 (MOQ 100) | JLC | JLC | substitute CR0603FA1621G for AC0603FR-071K62L accepted 2026-10-30, JLC ext | AC0603FR-071K62L | C227657 | original stock JLC 14 / LCSC 0; 1.62k 1% 0603 50V
60.4k | R110 | R_0603_1608Metric | 1 | RC0603FR-0760K4L | Yageo | C165742 | ext | 48563 | 48500 | 0.0062 (MOQ 100) | JLC | JLC | substitute RC0603FR-0760K4L for AC0603FR-0760K4L accepted 2026-10-30, JLC ext | AC0603FR-0760K4L | C227994 | original stock 19; 60.4k 1% 0603 (R_ILIM)
10k | R111,R401,R402,R501,R502,R503,R601,R604 | R_0603_1608Metric | 8 | 0603WAF1002T5E | UNI-ROYAL | C25804 | basic | 40290635 | 1435400 | 0.0022 (MOQ 100) | JLC | JLC | JLC basic (swap from AC0603FR-0710KL), verified 2026-10-30 | AC0603FR-0710KL | C116677 | 1% 0603
24.9k | R202 | R_0603_1608Metric | 1 | AC0603FR-0724K9L | Yageo | C227732 | ext | 3945 | 3900 | 0.0064 (MOQ 100) | JLC | JLC | JLC ext, verified 2026-10-30
64.9k | R203 | R_0603_1608Metric | 1 | AC0603FR-0764K9L | Yageo | C228007 | ext | 920 | 900 | 0.0042 (MOQ 100) | JLC | JLC | JLC ext, verified 2026-10-30
453k | R303 | R_0603_1608Metric | 1 | CR0603FA4533G | LIZ | C101055 | ext | 4984 | 4950 | 0.0093 (MOQ 50) | JLC | JLC | substitute CR0603FA4533G for AC0603FR-07453KL accepted 2026-10-30, JLC ext | AC0603FR-07453KL | C227908 | original stock 3; 453k 1% 0603 (FB de U301)
49.9k | R306 | R_0603_1608Metric | 1 | 0603WAF4992T5E | UNI-ROYAL | C23184 | basic | 1532153 | 1273400 | 0.0029 (MOQ 100) | JLC | JLC | JLC basic (swap from AC0603FR-0749K9L), verified 2026-10-30 | AC0603FR-0749K9L | C144654 | 1% 0603
5.1k | R403,R404 | R_0603_1608Metric | 2 | 0603WAF5101T5E | UNI-ROYAL | C23186 | basic | 21368680 | 16397700 | 0.0016 (MOQ 100) | JLC | JLC | JLC basic (swap from AC0603FR-075K1L), verified 2026-10-30 | AC0603FR-075K1L | C125891 | 1% 0603
60.4 | R602,R603 | R_0603_1608Metric | 2 | AC0603FR-0760R4L | Yageo | C144645 | ext | 14047 | 14000 | 0.0069 (MOQ 100) | JLC | JLC | JLC ext, verified 2026-10-30
0 | R605,R802,R805,R806 | R_0603_1608Metric | 4 | 0603WAF0000T5E | UNI-ROYAL | C21189 | basic | 20896231 | 11816300 | 0.0022 (MOQ 100) | JLC | JLC | JLC basic (swap from AC0603JR-070RL), verified 2026-10-30 | AC0603JR-070RL | C141796 | 0 ohm 0603; original sin stock en LCSC
2.2k | R702,R752 | R_0603_1608Metric | 2 | 0603WAF2201T5E | UNI-ROYAL | C4190 | basic | 5498979 | 2790900 | 0.0018 (MOQ 100) | JLC | JLC | JLC basic (swap from AC0603FR-072K2L), verified 2026-10-30; consolidado desde 4k7 | AC0603FR-072K2L | C125931 | 1% 0603
100k | R708,R709,R758,R759 | R_1206_3216Metric | 4 | 1206W4F1003T5E | UNI-ROYAL | C17900 | basic | 937779 | 315500 | 0.0097 (MOQ 50) | JLC | JLC | JLC basic (swap from AC1206FR-07100KL), verified 2026-10-30 | AC1206FR-07100KL | C144522 | 100k 1% 1206 200V
220k | R710,R760 | R_0603_1608Metric | 2 | 0603WAF2203T5E | UNI-ROYAL | C22961 | basic | 1137879 | 809400 | 0.0015 (MOQ 100) | JLC | JLC | JLC basic (swap from AC0603FR-07220KL), verified 2026-10-30 | AC0603FR-07220KL | C144681 | 1% 0603
RESET | SW401 | SW-SMD_L3.9-W3.0-P4.45 | 1 | TS-1088-AR02016 | XUNPU(讯普) | C720477 | basic | 605935 | 363750 | 0.0533 | JLC | JLC | JLC basic, verified 2026-10-30
BOOT | SW402 | SW-SMD_L3.9-W3.0-P4.45 | 1 | TS-1088-AR02016 | XUNPU(讯普) | C720477 | basic | 605935 | 363750 | 0.0533 | JLC | JLC | JLC basic, verified 2026-10-30
LM74930QRGERQ1 | U101 | TI_RGE0024T_VQFN-24-1EP_4x4mm_P0.5mm_EP2.1mm_HandSolder_IsolatedVias | 1 | LM74930QRGERQ1 | Texas Instruments | C22428070 | ext | 7308 | 7127 | 5.7664 | JLC | JLC | JLC ext, verified 2026-10-30
LMR38010SQDDARQ1 | U201 | SOIC-8-1EP_3.9x4.9mm_P1.27mm_EP2.95x4.9mm_Mask2.71x3.4mm_ThermalVias | 1 | LMR38010SQDDARQ1 | Texas Instruments |  |  |  |  | 2.7991 (ref. LCSC) | DigiKey/Mouser | consigna JLC o mano | not at JLC, DigiKey/Mouser, checked 2026-10-30 |  | C18198885 | JLC/LCSC stock 0
TPS62A02QDRLRQ1 | U301 | SOT-563 | 1 | TPS62A02QDRLRQ1 | Texas Instruments | C49259289 | ext | 190 | 190 | 0.5093 | JLC | JLC | JLC ext, verified 2026-10-30
LP5907QMFX-3.3Q1 | U302 | SOT-23-5 | 1 | LP5907QMFX-3.3Q1 | Texas Instruments | C130005 | ext | 3282 | 2994 | 0.7792 | JLC | JLC | JLC ext, verified 2026-10-30
ESP32-S3-WROOM-1-N8R2 | U401 | ESP32-S3-WROOM-1 | 1 | ESP32-S3-WROOM-1-N8R2 | Espressif Systems | C2913204 | ext | 18179 | 7131 | 4.0407 | LCSC | mano | JLC ext, verified 2026-10-30
USBLC6-2SC6 | U402 | SOT-23-6 | 1 | USBLC6-2SC6 | STMicroelectronics | C2687116 | ext | 119890 | 119900 | 0.0482 | JLC | JLC | JLC ext, verified 2026-10-30
SCL3300-D01 | U501 | DFL-12_L8.6-W7.0-P1.00-LS7.6-BL | 1 | SCL3300-D01-10 | Murata | C3825395 | ext | 721 | 721 | 27.9106 | JLC | JLC | substitute SCL3300-D01-10 for SCL3300-D01 accepted 2026-10-30, JLC ext | SCL3300-D01 | C22416657 | SCL3300-D01 stock 0; -10 = mismo sensor en carrete de 1000 u (Murata Doc. 4921 Rev. 2, sec. 9 Order Information)
ASM330LHHTR | U502 | LGA-14_3x2.5mm_P0.5mm_LayoutBorder3x4y | 1 | ASM330LHHTR | STMicroelectronics | C459826 | ext | 7766 | 7527 | 4.6845 | JLC | JLC | JLC ext, verified 2026-10-30
AS5147U-HTSM | U503 | TSSOP-14_4.4x5mm_P0.65mm | 1 | AS5147U-HTSM | ams OSRAM |  |  |  |  | 10.8657 (ref. LCSC) | DigiKey/Mouser | consigna JLC o mano | not at JLC, DigiKey/Mouser, checked 2026-10-30 |  | C2153628 | JLC/LCSC stock 0
ADM3055E | U601 | SOIC-20W_7.5x12.8mm_P1.27mm | 1 | ADM3055EBRIZ | Analog Devices |  |  |  |  | 15.3791 (ref. LCSC) | DigiKey/Mouser | consigna JLC o mano | not at JLC, DigiKey/Mouser, checked 2026-10-30 |  | C658104 | JLC/LCSC: ADM3055EBRIZ 0 u y -RL 55 u: no alcanza para 100 placas
74AHCT1G126 | U701,U751 | SOT-23-5 | 2 | SN74AHCT1G126QDBVRQ1 | Texas Instruments |  |  |  |  |  | DigiKey/Mouser | consigna JLC o mano | not at JLC, DigiKey/Mouser, checked 2026-10-30 |  |  | no listado en JLC/LCSC
TPS3828-33Q1 | U801 | SOT-23-5 | 1 | TPS3828-33QDBVRQ1 | Texas Instruments |  |  |  |  | 1.4158 (ref. LCSC) | DigiKey/Mouser | consigna JLC o mano | not at JLC, DigiKey/Mouser, checked 2026-10-30 |  | C2872895 | LCSC/JLC solo 15 u (C2872895): alcanza para 5 placas, no para 100
