elvisdt/PCB_INCLI_VA/bom/LCSC_CART_PROTO.csv

LCSC Part Number | Quantity | Manufacture Part Number | Manufacturer | Designator | Unit Price USD | Ext Price USD | LCSC Stock | Note
C7164734 | 6 | 1777109 | Phoenix Contact | J1 | 1.1738 | 7.04 | 317 | 5 placas + 1 repuesto
C480552 | 6 | 1777073 | Phoenix Contact | J2 | 1.3019 | 7.81 | 835 | 5 placas + 1 repuesto
C3020560 | 6 | USB4105-GF-A | GCT | J401 | 1.3201 | 7.92 | 413 | 5 placas + 1 repuesto
C49257 | 20 | 2.54-1*3PPin | BOOMELE | J402 | 0.0286 | 0.57 | 151440 | 5 placas + 1 repuesto, MOQ 20
C2913204 | 6 | ESP32-S3-WROOM-1-N8R2 | Espressif Systems | U401 | 4.6392 | 27.84 | 7131 | 5 placas + 1 repuesto
