elvisdt/PCB_INCLI_VA/INCLI-VA.kicad_pcb

## KiCad design INCLI-VA.kicad_pcb (2026-10-31)

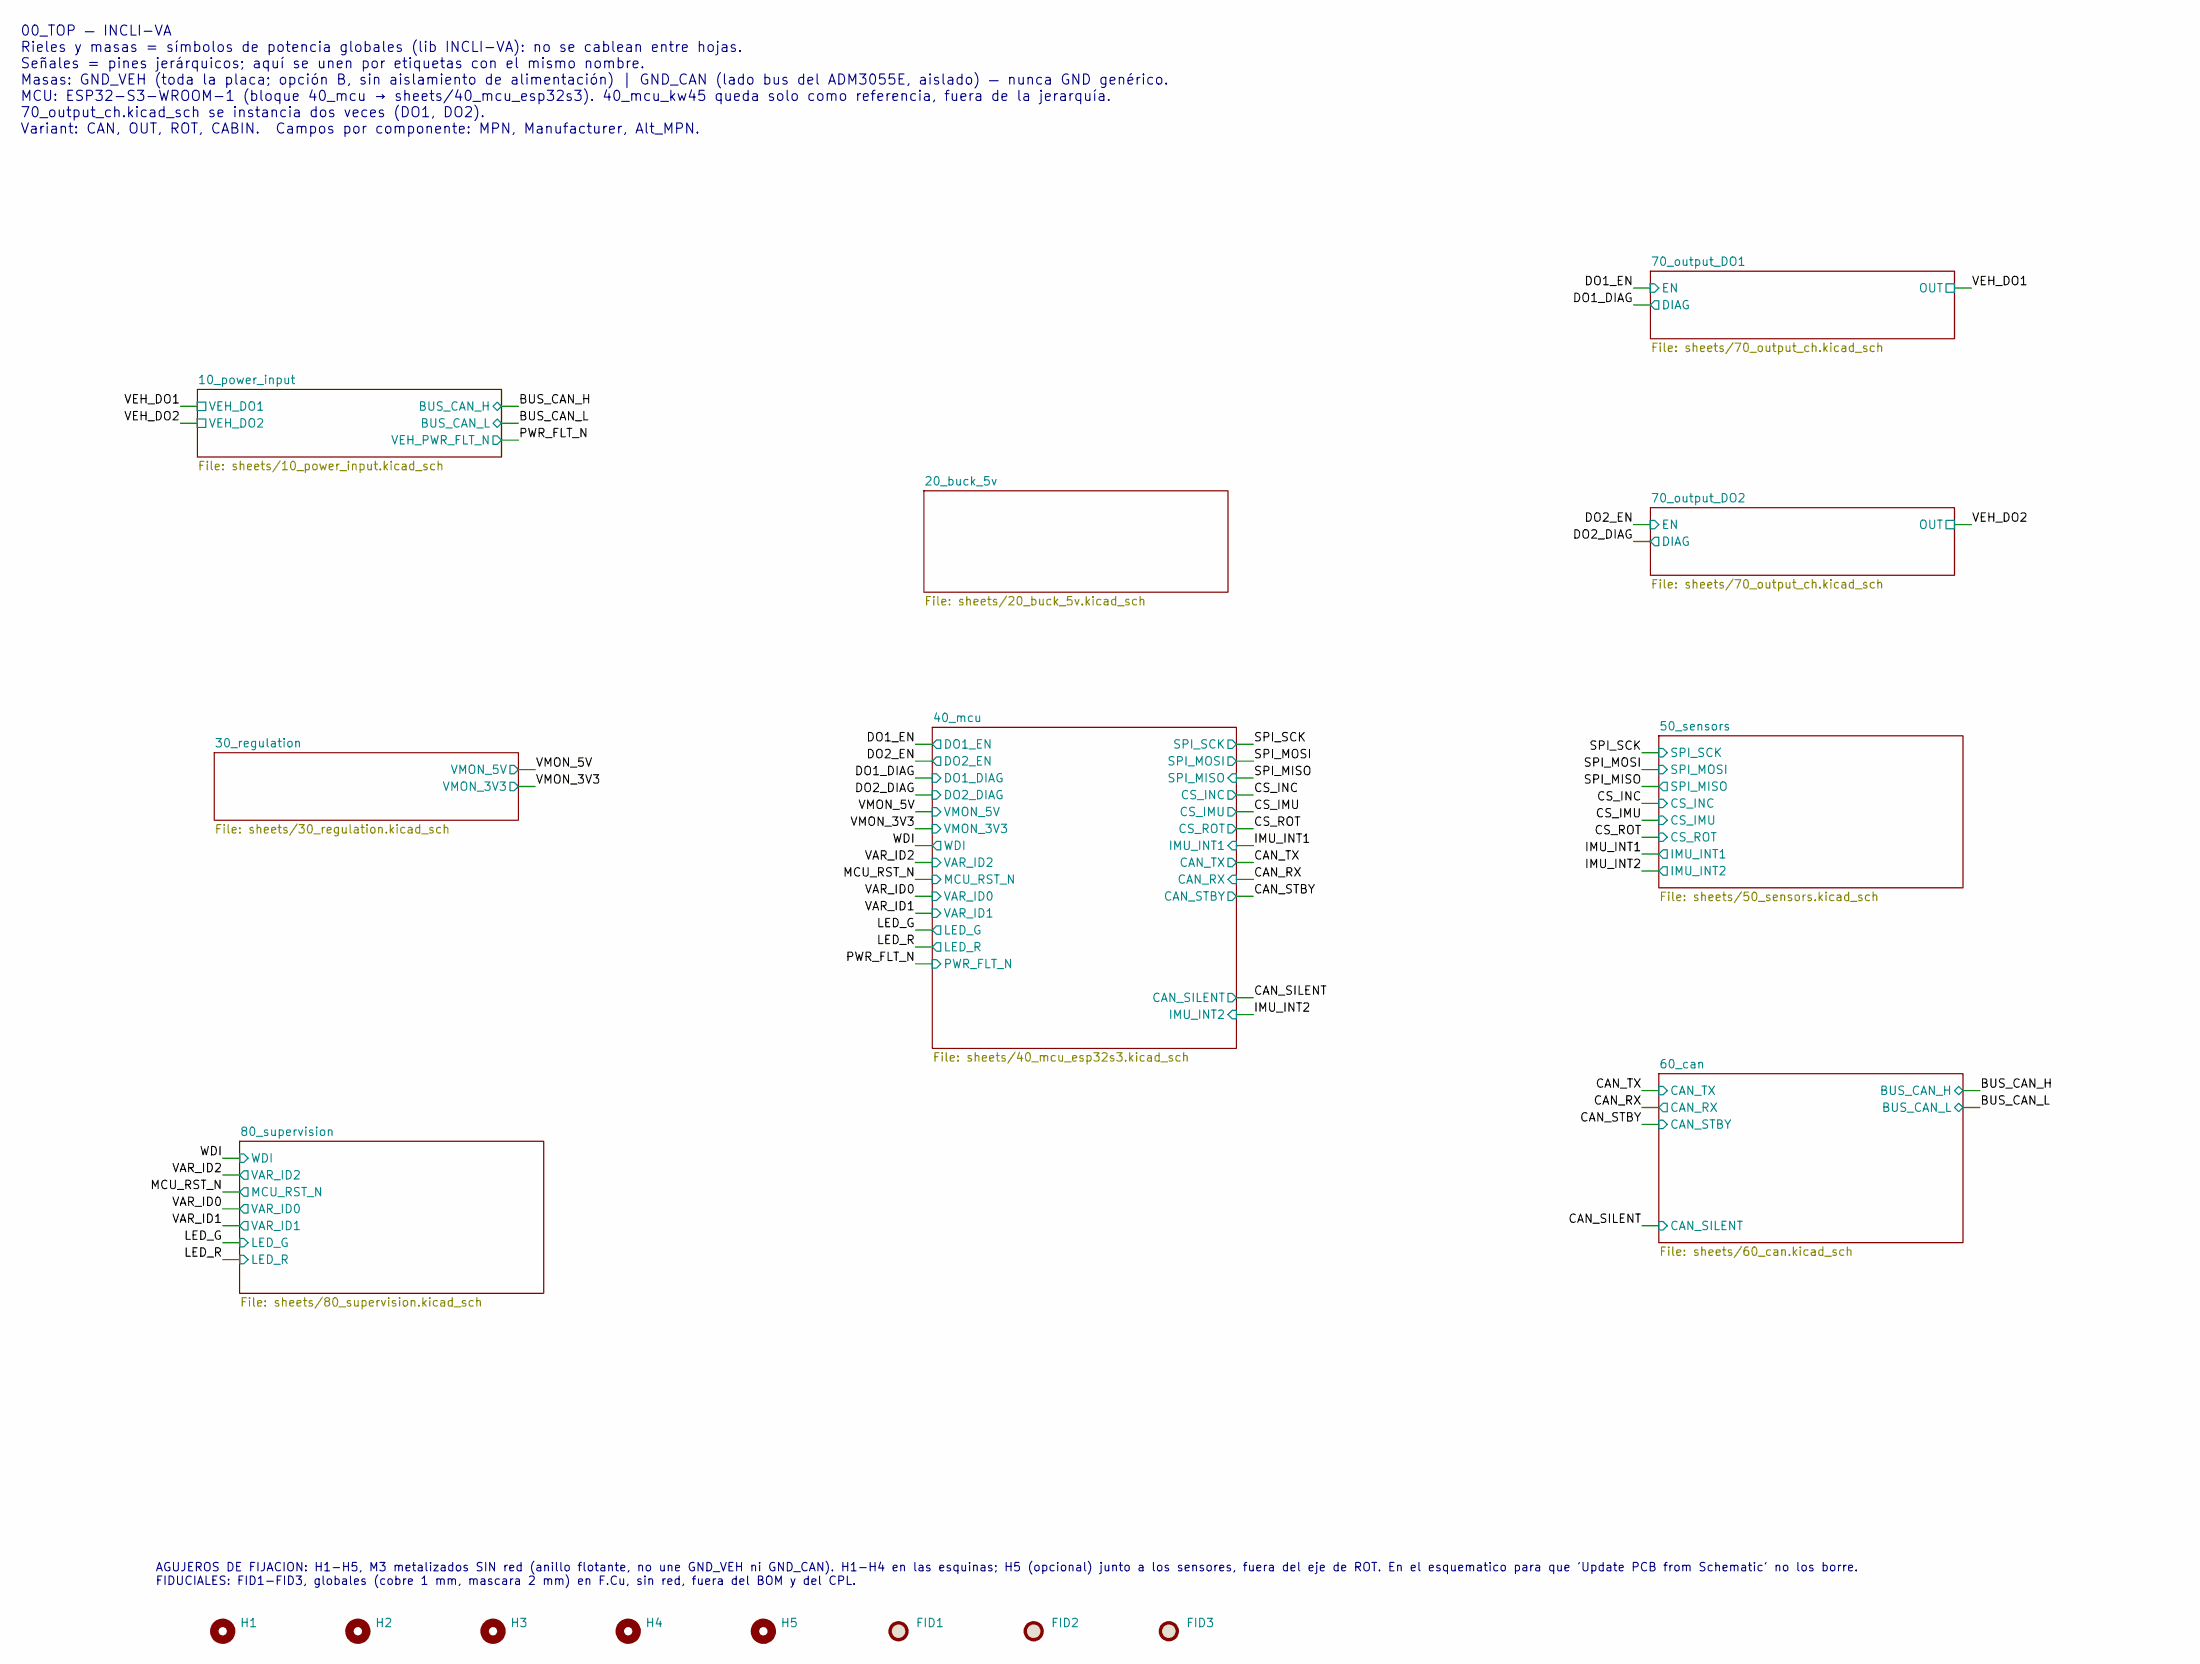
[picture p35: schematic INCLI-VA.kicad_sch, Inclinómetro CAN/BLE — Top]

Parts:
FID1, FID2, FID3: Fiducial; Fiducial_1mm_Mask2mm; MPN N/A (fiducial de cobre, sin componente)
H1, H2, H3, H4, H5: MountingHole_M3; MountingHole_3.2mm_M3_Pad; MPN N/A (agujero PTH sin red)

Notes on the sheet:
AGUJEROS DE FIJACION: H1-H5, M3 metalizados SIN red (anillo flotante, no une GND_VEH ni GND_CAN). H1-H4 en las esquinas; H5 (opcional) junto a los sensores, fuera del eje de ROT. En el esquematico para que 'Update PCB from Schematic' no los borre. FIDUCIALES: FID1-FID3, globales (cobre 1 mm, mascar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
00_TOP — INCLI-VA Rieles y masas = símbolos de potencia globales (lib INCLI-VA): no se cablean entre hojas. Señales = pines jerárquicos; aquí se unen por etiquetas con el mismo nombre. Masas: GND_VEH (toda la placa; opción B, sin aislamiento de alimentación) | GND_CAN (lado bus del ADM3055E, aislad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

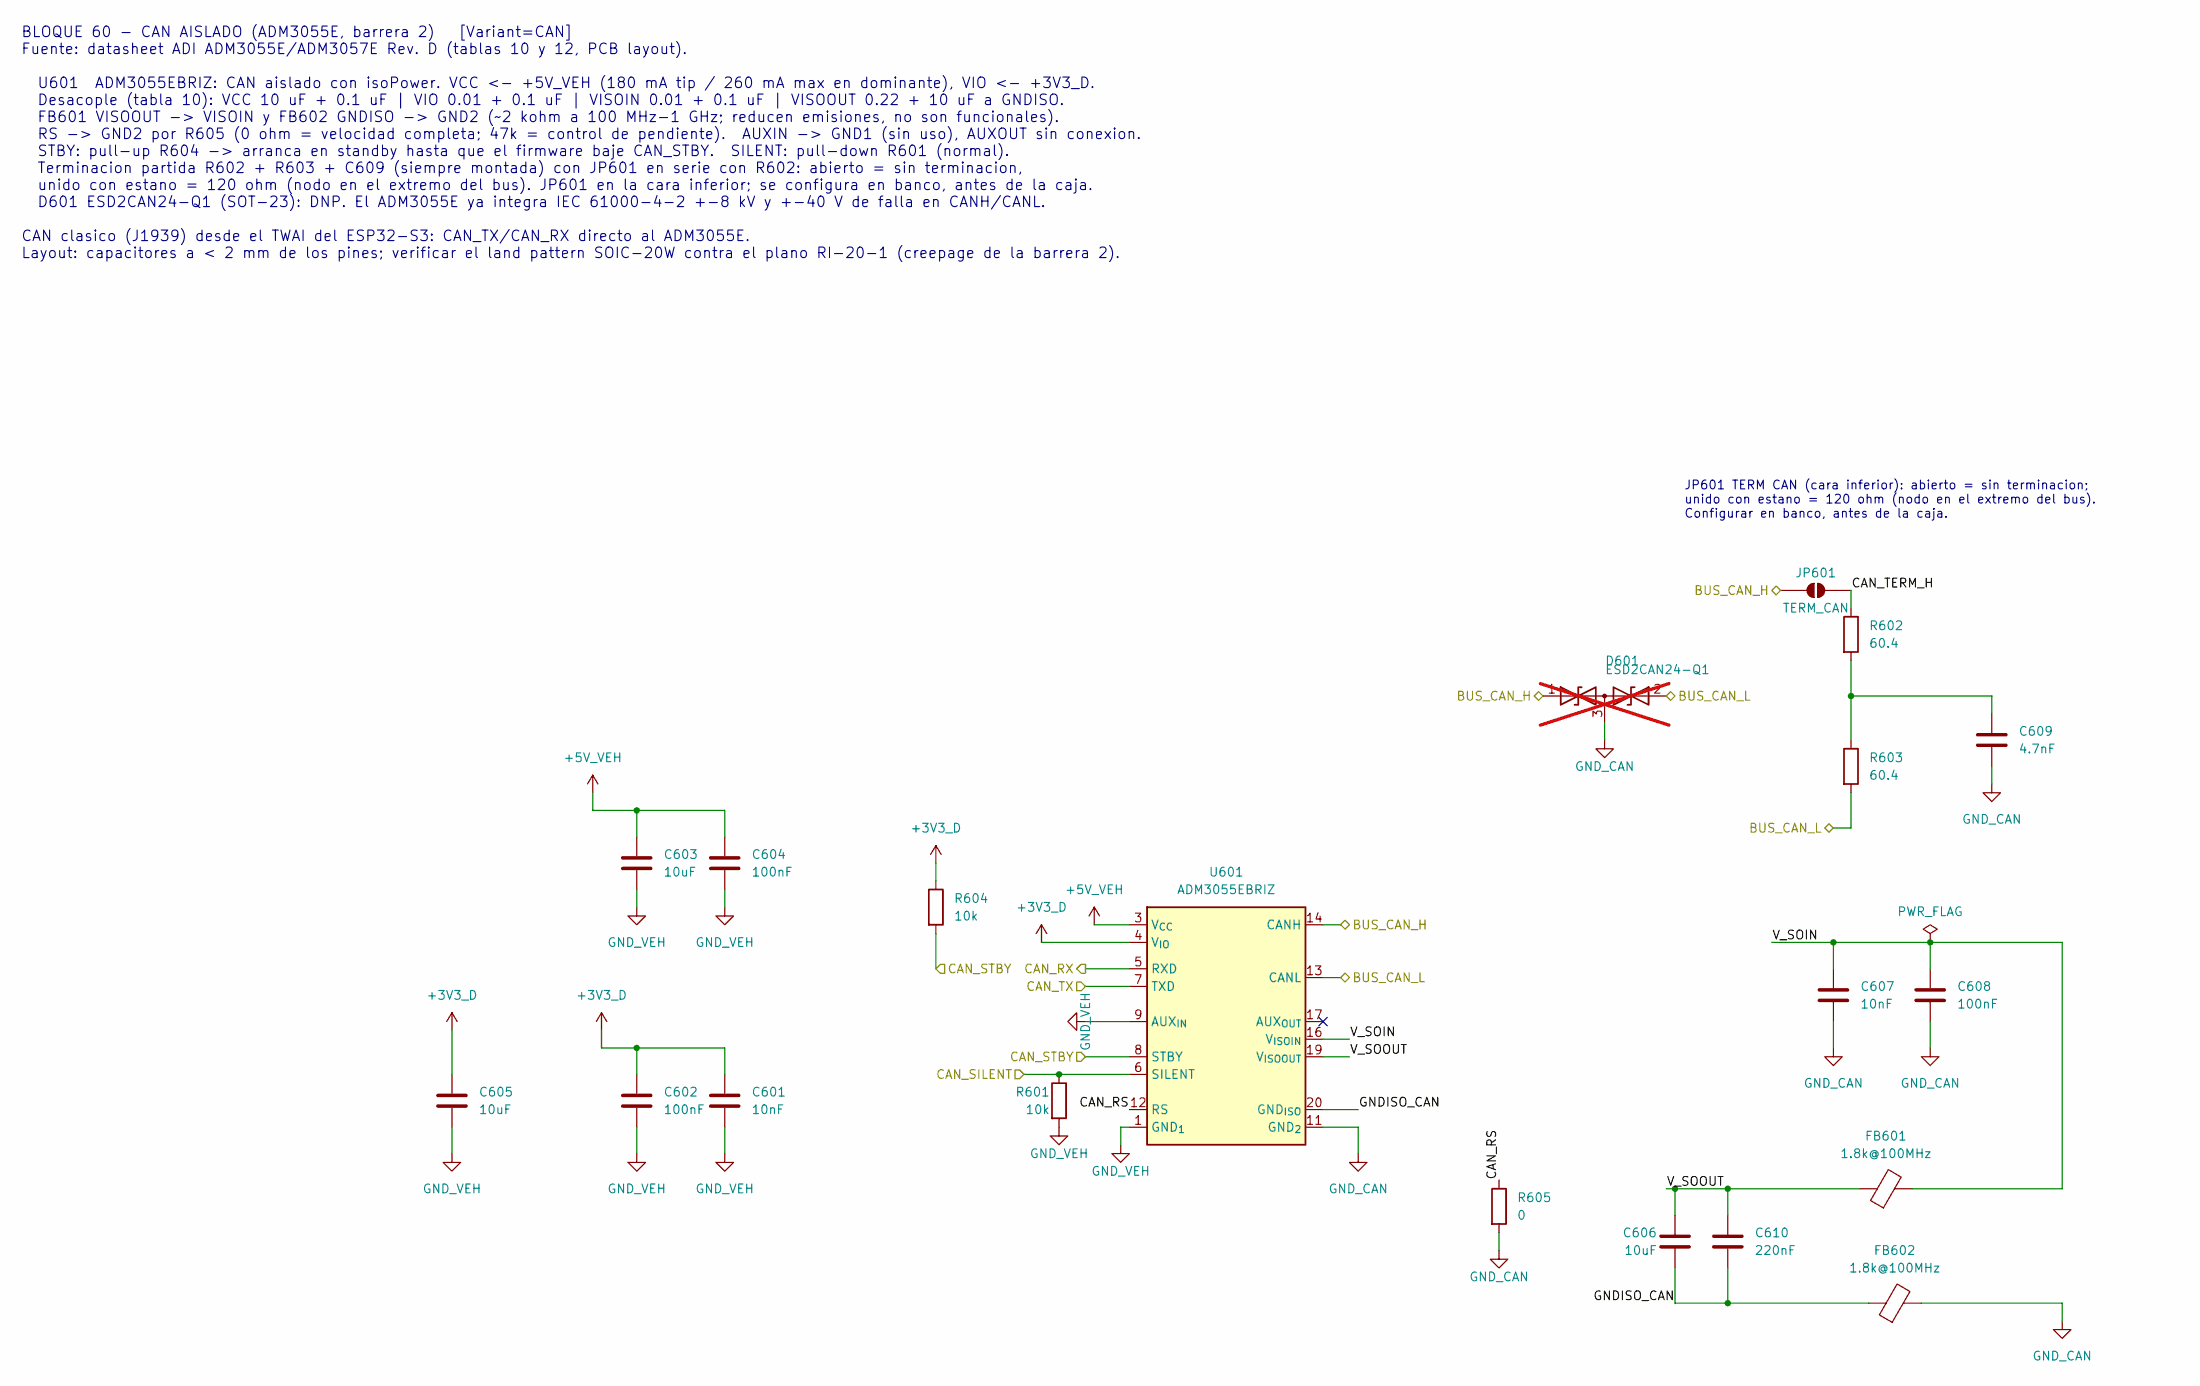
[picture p36: schematic 60_can.kicad_sch, CAN aislado (barrera 2)]

Parts:
C601, C607: 10nF; C_0603_1608Metric; MPN GCM188R71H103KA37D; LCSC C85863
C602, C604, C608: 100nF; C_0603_1608Metric; MPN GCM188R72A104KA64D; LCSC C415406
C603, C605, C606: 10uF; C_0805_2012Metric; MPN GCM21BR71A106KE22L; LCSC C126586
C609: 4.7nF; C_0603_1608Metric; MPN GCM188R72A472KA37D; LCSC C426631
C610: 220nF; C_0603_1608Metric; MPN GCM188R71E224KA55D; LCSC C161217
D601: ESD2CAN24-Q1; SOT-23; MPN ESD2CAN24DBZRQ1; LCSC C5736151; not fitted
FB601, FB602: 1.8k@100MHz; L_0603_1608Metric; MPN BLM18BD182SN1D; LCSC C113020
JP601: TERM_CAN; SolderJumper-2_P1.3mm_Open_RoundedPad1.0x1.5mm; MPN N/A (puente de soldadura en el PCB)
R601, R604: 10k; R_0603_1608Metric; MPN AC0603FR-0710KL; LCSC C116677
R602, R603: 60.4; R_0603_1608Metric; MPN AC0603FR-0760R4L; LCSC C144645
R605: 0; R_0603_1608Metric; MPN AC0603JR-070RL; LCSC C141796
U601: ADM3055E; SOIC-20W_7.5x12.8mm_P1.27mm; MPN ADM3055EBRIZ; LCSC C658104

Connections:
+3V3_D: C601.1, C602.1, C605.1, R604.1, U601.4 (V_{IO}); also elsewhere on the board
+5V_VEH: C603.1, C604.1, U601.3 (V_{CC}); also elsewhere on the board
/60_can/CAN_RS: R605.1, U601.12 (RS)
/60_can/CAN_TERM_H: JP601.2 (B), R602.1
/60_can/GNDISO_CAN: C606.2, C610.2, FB602.1, U601.18 (GND_{ISO}), U601.20 (GND_{ISO})
/60_can/V_SOIN: C607.1, C608.1, FB601.2, U601.16 (V_{ISOIN})
/60_can/V_SOOUT: C606.1, C610.1, FB601.1, U601.19 (V_{ISOOUT})
/BUS_CAN_H: D601.1 (A1), JP601.1 (A), U601.14 (CANH); also elsewhere on the board
/BUS_CAN_L: D601.2 (A2), R603.2, U601.13 (CANL); also elsewhere on the board
/CAN_RX: U601.5 (RXD); also elsewhere on the board
/CAN_SILENT: R601.1, U601.6 (SILENT); also elsewhere on the board
/CAN_STBY: R604.2, U601.8 (STBY); also elsewhere on the board
/CAN_TX: U601.7 (TXD); also elsewhere on the board
GND_CAN: C607.2, C608.2, C609.2, D601.3 (common), FB602.2, R605.2, U601.11 (GND_{2}), U601.15 (GND_{2}); also elsewhere on the board
GND_VEH: C601.2, C602.2, C603.2, C604.2, C605.2, R601.2, U601.1 (GND_{1}), U601.2 (GND_{1}), U601.9 (AUX_{IN}), U601.10 (GND_{1}); also elsewhere on the board
unnamed: C609.1, R602.2, R603.1

Notes on the sheet:
BLOQUE 60 - CAN AISLADO (ADM3055E, barrera 2) [Variant=CAN] Fuente: datasheet ADI ADM3055E/ADM3057E Rev. D (tablas 10 y 12, PCB layout). U601 ADM3055EBRIZ: CAN aislado con isoPower. VCC <- +5V_VEH (180 mA tip / 260 mA max en dominante), VIO <- +3V3_D. Desacople (tabla 10): VCC 10 uF + 0.1 uF | VIO 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
JP601 TERM CAN (cara inferior): abierto = sin terminacion; unido con estano = 120 ohm (nodo en el extremo del bus). Configurar en banco, antes de la caja.

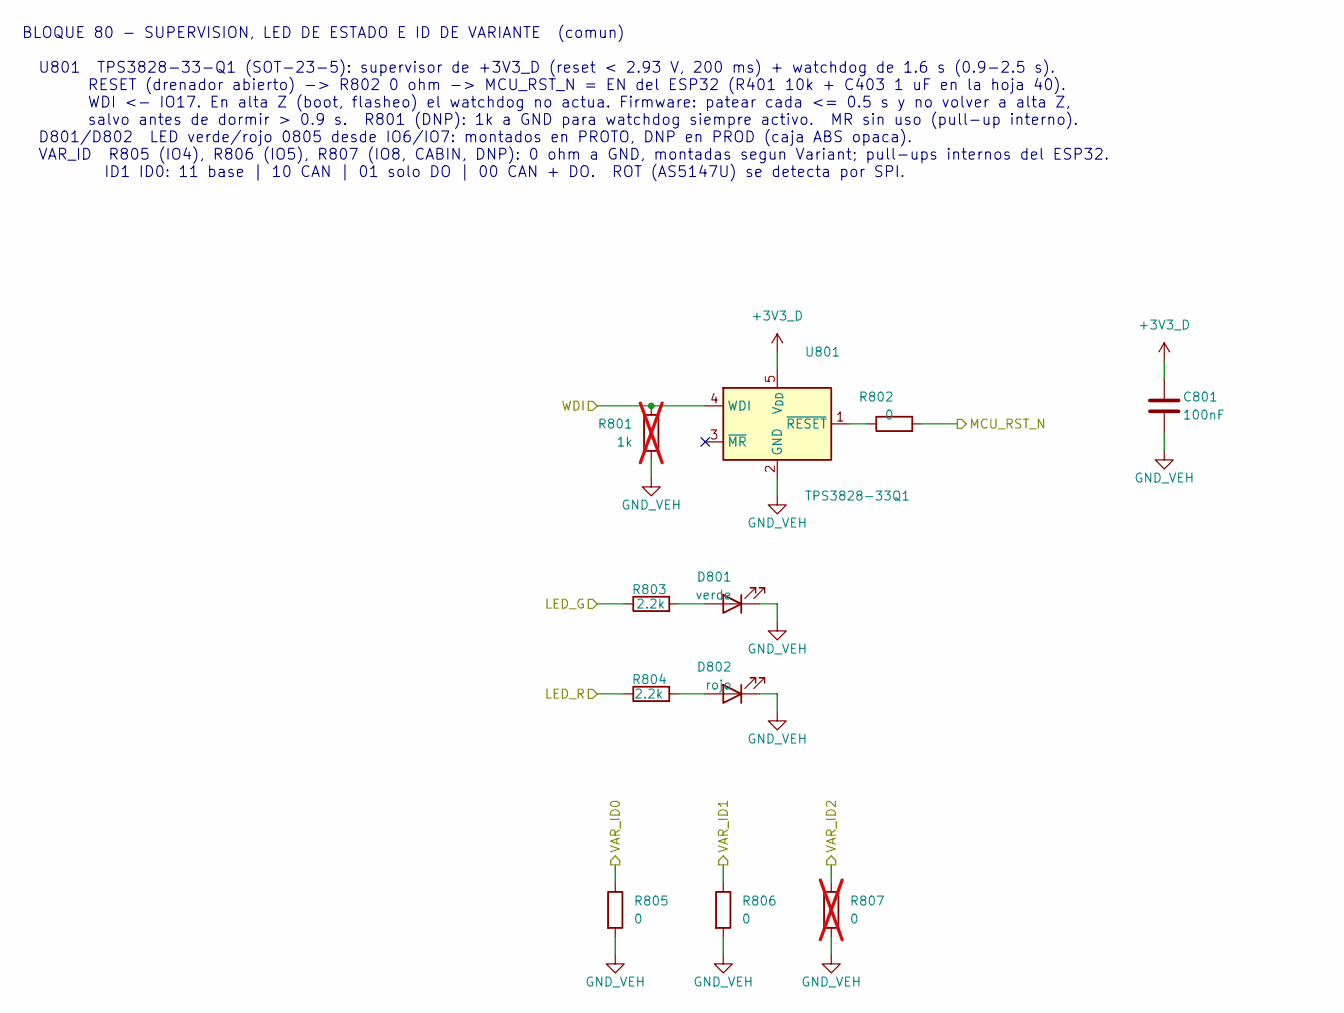
[picture p37: schematic 80_supervision.kicad_sch, Supervisión, ID de variante y LED]

Parts:
C801: 100nF; C_0603_1608Metric; MPN GCM188R72A104KA64D; LCSC C415406
D801: verde; LED_0805_2012Metric; MPN LTST-C171KGKT; LCSC C98224
D802: rojo; LED_0805_2012Metric; MPN LTST-C171KRKT; LCSC C284871
R801: 1k; R_0603_1608Metric; MPN AC0603FR-071KL; LCSC C116692; not fitted
R802, R805, R806: 0; R_0603_1608Metric; MPN AC0603JR-070RL; LCSC C141796
R803, R804: 2.2k; R_0603_1608Metric; MPN AC0603FR-072K2L; LCSC C125931
R807: 0; R_0603_1608Metric; MPN AC0603JR-070RL; LCSC C141796; not fitted
U801: TPS3828-33Q1; SOT-23-5; MPN TPS3828-33QDBVRQ1; LCSC C2872895

Connections:
+3V3_D: C801.1, U801.5 (V_{DD}); also elsewhere on the board
/LED_G: R803.1; also elsewhere on the board
/LED_R: R804.1; also elsewhere on the board
/MCU_RST_N: R802.2; also elsewhere on the board
/VAR_ID0: R805.1; also elsewhere on the board
/VAR_ID1: R806.1; also elsewhere on the board
/VAR_ID2: R807.1; also elsewhere on the board
/WDI: R801.1, U801.4 (WDI); also elsewhere on the board
GND_VEH: C801.2, D801.1 (K), D802.1 (K), R801.2, R805.2, R806.2, R807.2, U801.2 (GND); also elsewhere on the board
unnamed: D801.2 (A), R803.2
unnamed: D802.2 (A), R804.2
unnamed: R802.1, U801.1 (~RESET)

Notes on the sheet:
BLOQUE 80 - SUPERVISION, LED DE ESTADO E ID DE VARIANTE (comun) U801 TPS3828-33-Q1 (SOT-23-5): supervisor de +3V3_D (reset < 2.93 V, 200 ms) + watchdog de 1.6 s (0.9-2.5 s). RESET (drenador abierto) -> R802 0 ohm -> MCU_RST_N = EN del ESP32 (R401 10k + C403 1 uF en la hoja 40). WDI <- IO17. En alta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

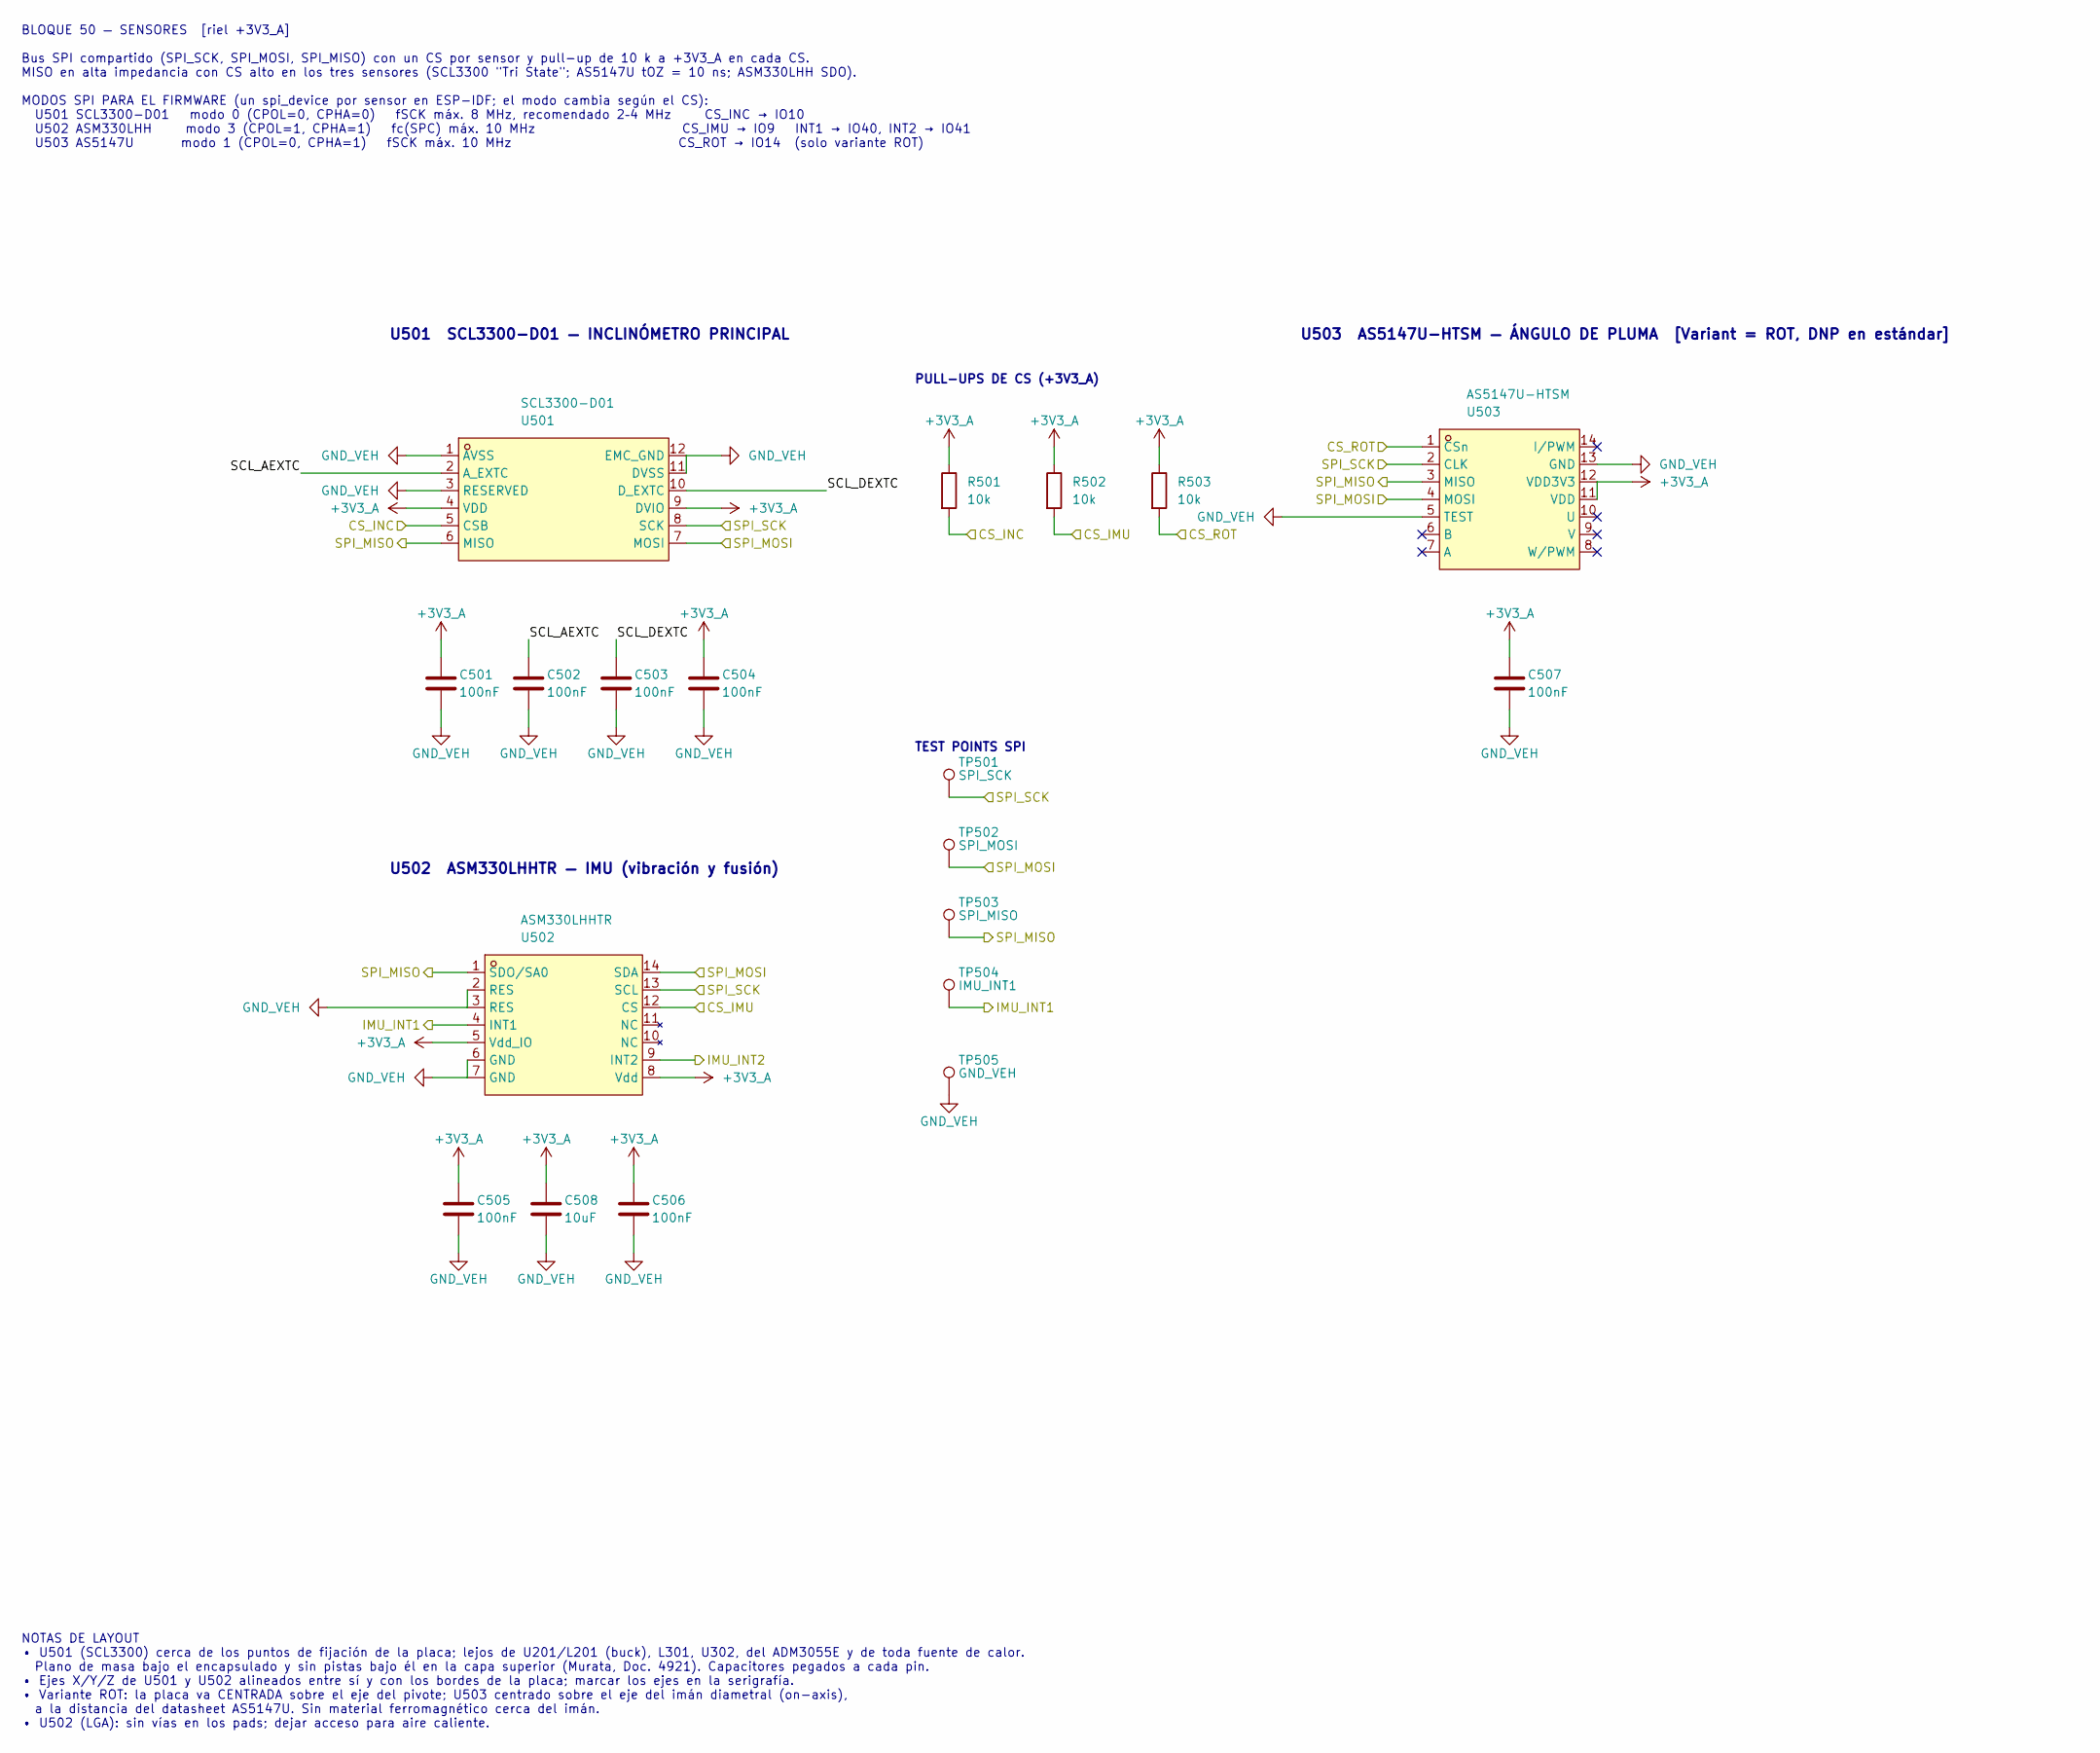
[picture p38: schematic 50_sensors.kicad_sch, Sensores]

Parts:
C501, C502, C503, C504, C505, C506, C507: 100nF; C_0603_1608Metric; MPN GCM188R72A104KA64D; LCSC C415406
C508: 10uF; C_0805_2012Metric; MPN GCM21BR71A106KE22L; LCSC C126586
R501, R502, R503: 10k; R_0603_1608Metric; MPN AC0603FR-0710KL; LCSC C116677
TP501: SPI_SCK; TestPoint_Pad_D1.5mm
TP502: SPI_MOSI; TestPoint_Pad_D1.5mm
TP503: SPI_MISO; TestPoint_Pad_D1.5mm
TP504: IMU_INT1; TestPoint_Pad_D1.5mm
TP505: GND_VEH; TestPoint_THTPad_D2.5mm_Drill1.2mm
U501: SCL3300-D01; DFL-12_L8.6-W7.0-P1.00-LS7.6-BL; MPN SCL3300-D01; LCSC C22416657
U502: ASM330LHHTR; LGA-14_3x2.5mm_P0.5mm_LayoutBorder3x4y; MPN ASM330LHHTR; LCSC C459826
U503: AS5147U-HTSM; TSSOP-14_4.4x5mm_P0.65mm; MPN AS5147U-HTSM; LCSC C38675951

Connections:
+3V3_A: C501.1, C504.1, C505.1, C506.1, C507.1, C508.1, R501.1, R502.1, R503.1, U501.4 (VDD), U501.9 (DVIO), U502.5 (Vdd_IO), U502.8 (Vdd), U503.11 (VDD), U503.12 (VDD3V3); also elsewhere on the board
/50_sensors/SCL_AEXTC: C502.1, U501.2 (A_EXTC)
/50_sensors/SCL_DEXTC: C503.1, U501.10 (D_EXTC)
/CS_IMU: R502.2, U502.12 (CS); also elsewhere on the board
/CS_INC: R501.2, U501.5 (CSB); also elsewhere on the board
/CS_ROT: R503.2, U503.1 (CSn); also elsewhere on the board
/IMU_INT1: TP504.1 (1_1), U502.4 (INT1); also elsewhere on the board
/IMU_INT2: U502.9 (INT2); also elsewhere on the board
/SPI_MISO: TP503.1 (1_1), U501.6 (MISO), U502.1 (SDO/SA0), U503.3 (MISO); also elsewhere on the board
/SPI_MOSI: TP502.1 (1_1), U501.7 (MOSI), U502.14 (SDA), U503.4 (MOSI); also elsewhere on the board
/SPI_SCK: TP501.1 (1_1), U501.8 (SCK), U502.13 (SCL), U503.2 (CLK); also elsewhere on the board
GND_VEH: C501.2, C502.2, C503.2, C504.2, C505.2, C506.2, C507.2, C508.2, TP505.1, U501.1 (AVSS), U501.3 (RESERVED), U501.11 (DVSS), U501.12 (EMC_GND), U502.2 (RES), U502.3 (RES), U502.6 (GND), U502.7 (GND), U503.5 (TEST), U503.13 (GND); also elsewhere on the board

Notes on the sheet:
NOTAS DE LAYOUT • U501 (SCL3300) cerca de los puntos de fijación de la placa; lejos de U201/L201 (buck), L301, U302, del ADM3055E y de toda fuente de calor. Plano de masa bajo el encapsulado y sin pistas bajo él en la capa superior (Murata, Doc. 4921). Capacitores pegados a cada pin. • Ejes X/Y/Z d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
TEST POINTS SPI
U502 ASM330LHHTR — IMU (vibración y fusión)
U501 SCL3300-D01 — INCLINÓMETRO PRINCIPAL
U503 AS5147U-HTSM — ÁNGULO DE PLUMA [Variant = ROT, DNP en estándar]
BLOQUE 50 — SENSORES [riel +3V3_A] Bus SPI compartido (SPI_SCK, SPI_MOSI, SPI_MISO) con un CS por sensor y pull-up de 10 k a +3V3_A en cada CS. MISO en alta impedancia con CS alto en los tres sensores (SCL3300 "Tri State"; AS5147U tOZ = 10 ns; ASM330LHH SDO). MODOS SPI PARA EL FIRMWARE (un spi_devi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
PULL-UPS DE CS (+3V3_A)

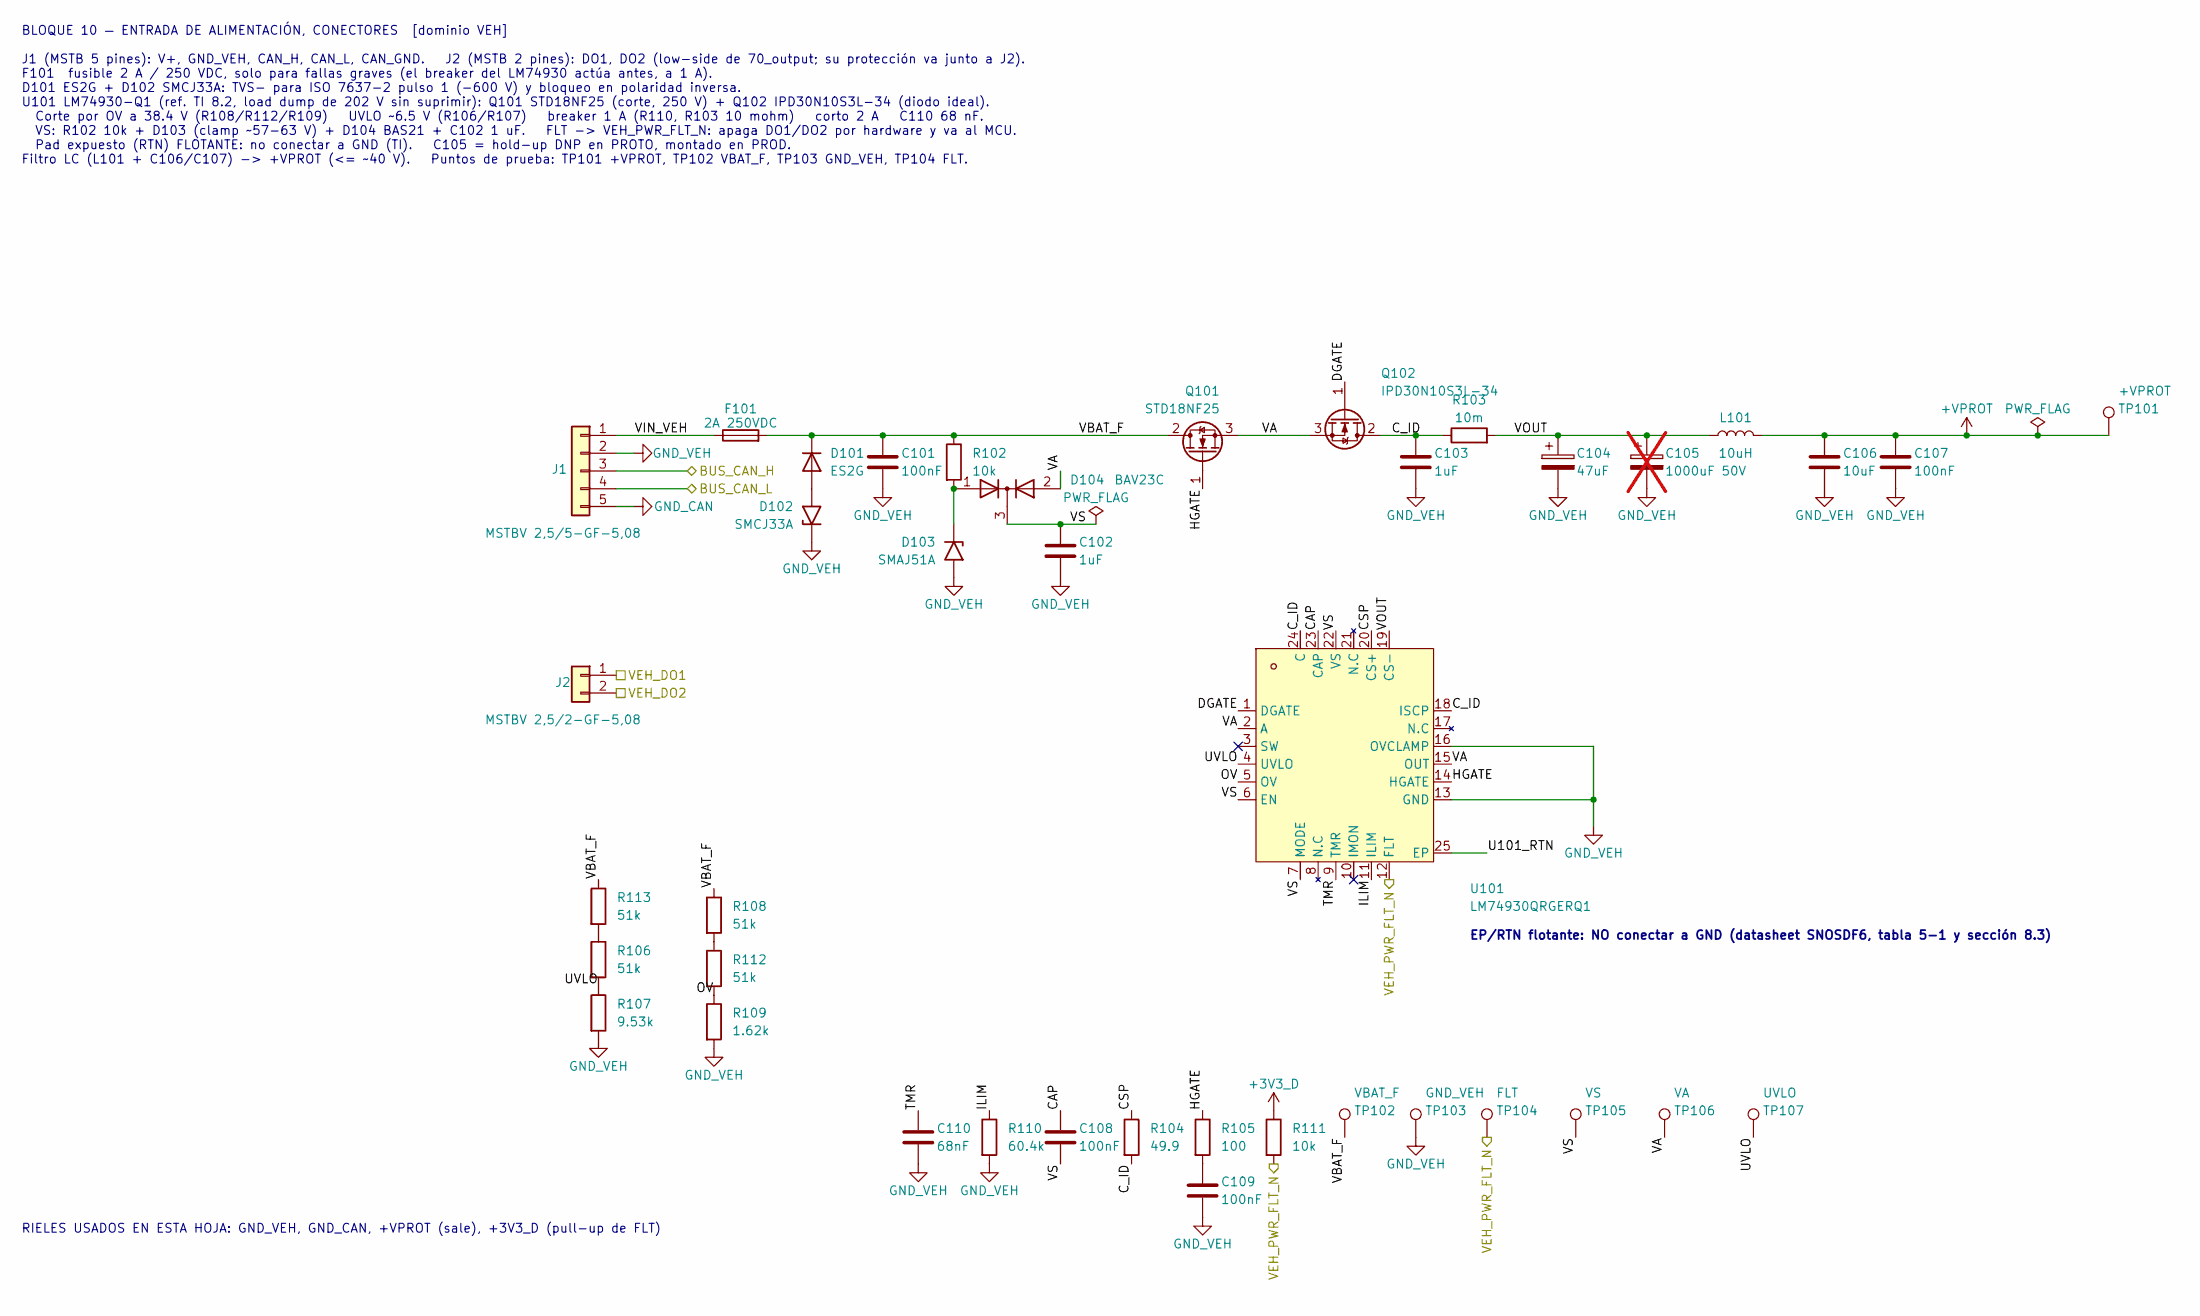
[picture p39: schematic 10_power_input.kicad_sch, Entrada de alimentación y conector M12]

Parts:
C101: 100nF; C_1206_3216Metric; MPN CGA5L4X7T2W104K160AA; LCSC C3887150
C102, C103: 1uF; C_1206_3216Metric; MPN CGA5L2X7R2A105K160AA; LCSC C2168321
C104: 47uF; CP_Elec_10x10; MPN EEE-HA2A470UP; LCSC C344077
C105: 1000uF 50V; CP_Elec_Panasonic_J16_VibProof; MPN EEE-FK1H102AV; LCSC C2164039; not fitted
C106: 10uF; C_1210_3225Metric; MPN GCM32ER71H106KA12L; LCSC_PROTO C138687
C107, C108, C109: 100nF; C_0603_1608Metric; MPN GCM188R72A104KA64D; LCSC C415406
C110: 68nF; C_0603_1608Metric; MPN GCM188R71H683KA57D; LCSC C380380
D101: ES2G; D_SMB; MPN ES2G-E3/52T; LCSC C2927419
D102: SMCJ33A; D_SMC; MPN SMCJ33A; LCSC C438109
D103: SMAJ51A; D_SMA; MPN SMAJ51A; LCSC C366557
D104: BAV23C; SOT-23; MPN BAV23C,215; LCSC C282370
F101: 2A 250VDC; Fuse_Bourns_SF-2410; MPN SF-2410FPA200W-2; LCSC C3159902
J1: MSTBV 2,5/5-GF-5,08; PhoenixContact_MSTBV_2,5_5-GF-5,08_1x05_P5.08mm_Vertical_Th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; MPN 1777109; LCSC C7164734
J2: MSTBV 2,5/2-GF-5,08; PhoenixContact_MSTBV_2,5_2-GF-5,08_1x02_P5.08mm_Vertical_Th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; MPN 1777073; LCSC C480552
L101: 10uH; L_Bourns_SRN6045TA; MPN SRN6045TA-100M; LCSC C2046332
Q101: STD18NF25; TO-252-2; MPN STD18NF25; LCSC C183634
Q102: IPD30N10S3L-34; TO-252-2; MPN IPD30N10S3L34ATMA1; LCSC C148263
R102: 10k; R_2512_6332Metric; MPN AC2512FK-0710KL; LCSC C469651
R103: 10m; R_1206_3216Metric; MPN ERJ-8BWFR010V; LCSC C2076185
R104: 49.9; R_0603_1608Metric; MPN AC0603FR-0749R9L; LCSC C144653
R105: 100; R_0603_1608Metric; MPN AC0603FR-07100RL; LCSC C125923
R106, R108, R112, R113: 51k; R_1206_3216Metric; MPN AC1206FR-0751KL; LCSC C144484
R107: 9.53k; R_0603_1608Metric; MPN AC0603FR-079K53L; LCSC C228113
R109: 1.62k; R_0603_1608Metric; MPN AC0603FR-071K62L; LCSC C227657
R110: 60.4k; R_0603_1608Metric; MPN AC0603FR-0760K4L; LCSC C227994
R111: 10k; R_0603_1608Metric; MPN AC0603FR-0710KL; LCSC C116677
TP101: +VPROT; TestPoint_Pad_D1.5mm
TP102: VBAT_F; TestPoint_Pad_D1.5mm
TP103: GND_VEH; TestPoint_Pad_D1.5mm
TP104: FLT; TestPoint_Pad_D1.5mm
TP105: VS; TestPoint_Pad_D1.5mm
TP106: VA; TestPoint_Pad_D1.5mm
TP107: UVLO; TestPoint_Pad_D1.5mm
U101: LM74930QRGERQ1; TI_RGE0024T_VQFN-24-1EP_4x4mm_P0.5mm_EP2.1mm_HandSolder_Iso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; MPN LM74930QRGERQ1; LCSC C22428070

Connections:
+3V3_D: R111.1; also elsewhere on the board
+VPROT: C106.1, C107.1, L101.2, TP101.1 (1_1); also elsewhere on the board
/10_power_input/CAP: C108.1, U101.23 (CAP)
/10_power_input/CSP: R104.1, U101.20 (CS+)
/10_power_input/C_ID: C103.1, Q102.2 (D), R103.1, R104.2, U101.18 (ISCP), U101.24 (C)
/10_power_input/DGATE: Q102.1 (G), U101.1 (DGATE)
/10_power_input/HGATE: Q101.1 (G), R105.1, U101.14 (HGATE)
/10_power_input/ILIM: R110.1, U101.11 (ILIM)
/10_power_input/OV: R109.1, R112.2, U101.5 (OV)
/10_power_input/TMR: C110.1, U101.9 (TMR)
/10_power_input/U101_RTN: U101.25 (EP)
/10_power_input/UVLO: R106.2, R107.1, TP107.1, U101.4 (UVLO)
/10_power_input/VA: D104.2 (NC), Q101.3 (S), Q102.3 (S), TP106.1, U101.2 (A), U101.15 (OUT)
/10_power_input/VBAT_F: C101.1, D101.1 (K), F101.2, Q101.2 (D), R102.1, R108.1, R113.1, TP102.1 (1_1)
/10_power_input/VIN_VEH: F101.1, J1.1
/10_power_input/VOUT: C104.1, C105.1, L101.1, R103.2, U101.19 (CS-)
/10_power_input/VS: C102.1, C108.2, D104.3 (K), TP105.1, U101.6 (EN), U101.7 (MODE), U101.22 (VS)
/BUS_CAN_H: J1.3; also elsewhere on the board
/BUS_CAN_L: J1.4; also elsewhere on the board
/PWR_FLT_N: R111.2, TP104.1 (1_1), U101.12 (FLT); also elsewhere on the board
/VEH_DO1: J2.1; also elsewhere on the board
/VEH_DO2: J2.2; also elsewhere on the board
GND_CAN: J1.5; also elsewhere on the board
GND_VEH: C101.2, C102.2, C103.2, C104.2, C105.2, C106.2, C107.2, C109.2, C110.2, D102.1 (A1), D103.2 (A2), J1.2, R107.2, R109.2, R110.2, TP103.1 (1_1), U101.13 (GND), U101.16 (OVCLAMP); also elsewhere on the board
unnamed: C109.1, R105.2
unnamed: D101.2 (A), D102.2 (A2)
unnamed: D103.1 (A1), D104.1 (A), R102.2
unnamed: R106.1, R113.2
unnamed: R108.2, R112.1

Notes on the sheet:
BLOQUE 10 — ENTRADA DE ALIMENTACIÓN, CONECTORES [dominio VEH] J1 (MSTB 5 pines): V+, GND_VEH, CAN_H, CAN_L, CAN_GND. J2 (MSTB 2 pines): DO1, DO2 (low-side de 70_output; su protección va junto a J2). F101 fusible 2 A / 250 VDC, solo para fallas graves (el breaker del LM74930 actúa antes, a 1 A). D10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
EP/RTN flotante: NO conectar a GND (datasheet SNOSDF6, tabla 5-1 y sección 8.3)
RIELES USADOS EN ESTA HOJA: GND_VEH, GND_CAN, +VPROT (sale), +3V3_D (pull-up de FLT)
