elvisdt/PCB_INCLI_VA/INCLI-VA.kicad_pcb

## KiCad design INCLI-VA.kicad_pcb (continued)

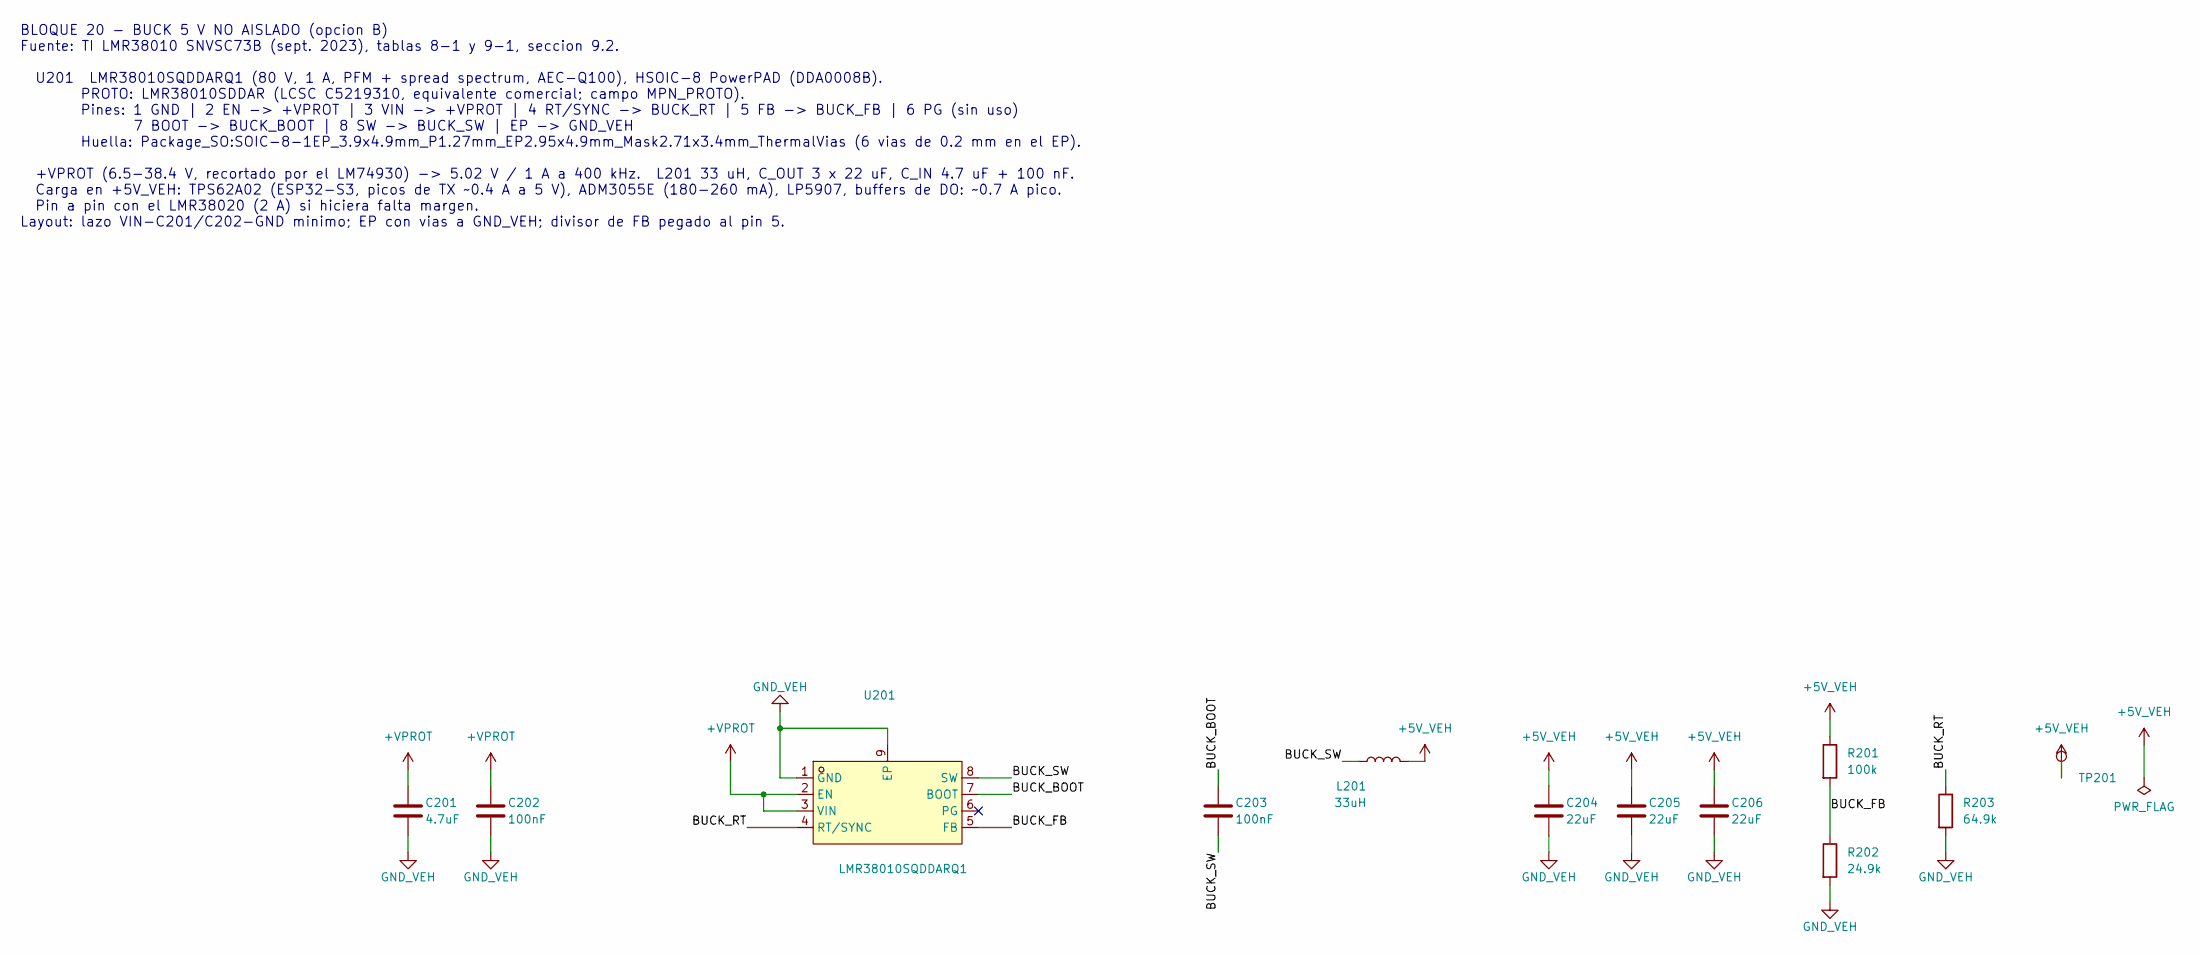
[picture p40: schematic 20_buck_5v.kicad_sch, Buck 5 V no aislado (LMR38010-Q1)]

Parts:
C201: 4.7uF; C_1210_3225Metric; MPN CGA6M3X7S2A475K200AB; LCSC C2168848
C202, C203: 100nF; C_0603_1608Metric; MPN GCM188R72A104KA64D; LCSC C415406
C204, C205, C206: 22uF; C_1206_3216Metric; MPN GCM31CR71A226KE02L; LCSC C126598
L201: 33uH; L_Coilcraft_XAL6060-XXX; MPN XAL6060-333MEC; LCSC C5119929
R201: 100k; R_0603_1608Metric; MPN AC0603FR-07100KL; LCSC C116674
R202: 24.9k; R_0603_1608Metric; MPN AC0603FR-0724K9L; LCSC C227732
R203: 64.9k; R_0603_1608Metric; MPN AC0603FR-0764K9L; LCSC C228007
TP201: +5V_VEH; TestPoint_Pad_D1.5mm
U201: LMR38010SQDDARQ1; SOIC-8-1EP_3.9x4.9mm_P1.27mm_EP2.95x4.9mm_Mask2.71x3.4mm_Th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; MPN LMR38010SQDDARQ1; LCSC_PROTO C5219310

Connections:
+5V_VEH: C204.1, C205.1, C206.1, L201.2, R201.1, TP201.1 (1_1); also elsewhere on the board
+VPROT: C201.1, C202.1, U201.2 (EN), U201.3 (VIN); also elsewhere on the board
/20_buck_5v/BUCK_BOOT: C203.1, U201.7 (BOOT)
/20_buck_5v/BUCK_FB: R201.2, R202.1, U201.5 (FB)
/20_buck_5v/BUCK_RT: R203.1, U201.4 (RT/SYNC)
/20_buck_5v/BUCK_SW: C203.2, L201.1, U201.8 (SW)
GND_VEH: C201.2, C202.2, C204.2, C205.2, C206.2, R202.2, R203.2, U201.1 (GND), U201.9 (EP); also elsewhere on the board

Notes on the sheet:
BLOQUE 20 - BUCK 5 V NO AISLADO (opcion B) Fuente: TI LMR38010 SNVSC73B (sept. 2023), tablas 8-1 y 9-1, seccion 9.2. U201 LMR38010SQDDARQ1 (80 V, 1 A, PFM + spread spectrum, AEC-Q100), HSOIC-8 PowerPAD (DDA0008B). PROTO: LMR38010SDDAR (LCSC C5219310, equivalente comercial; campo MPN_PROTO). Pines: 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

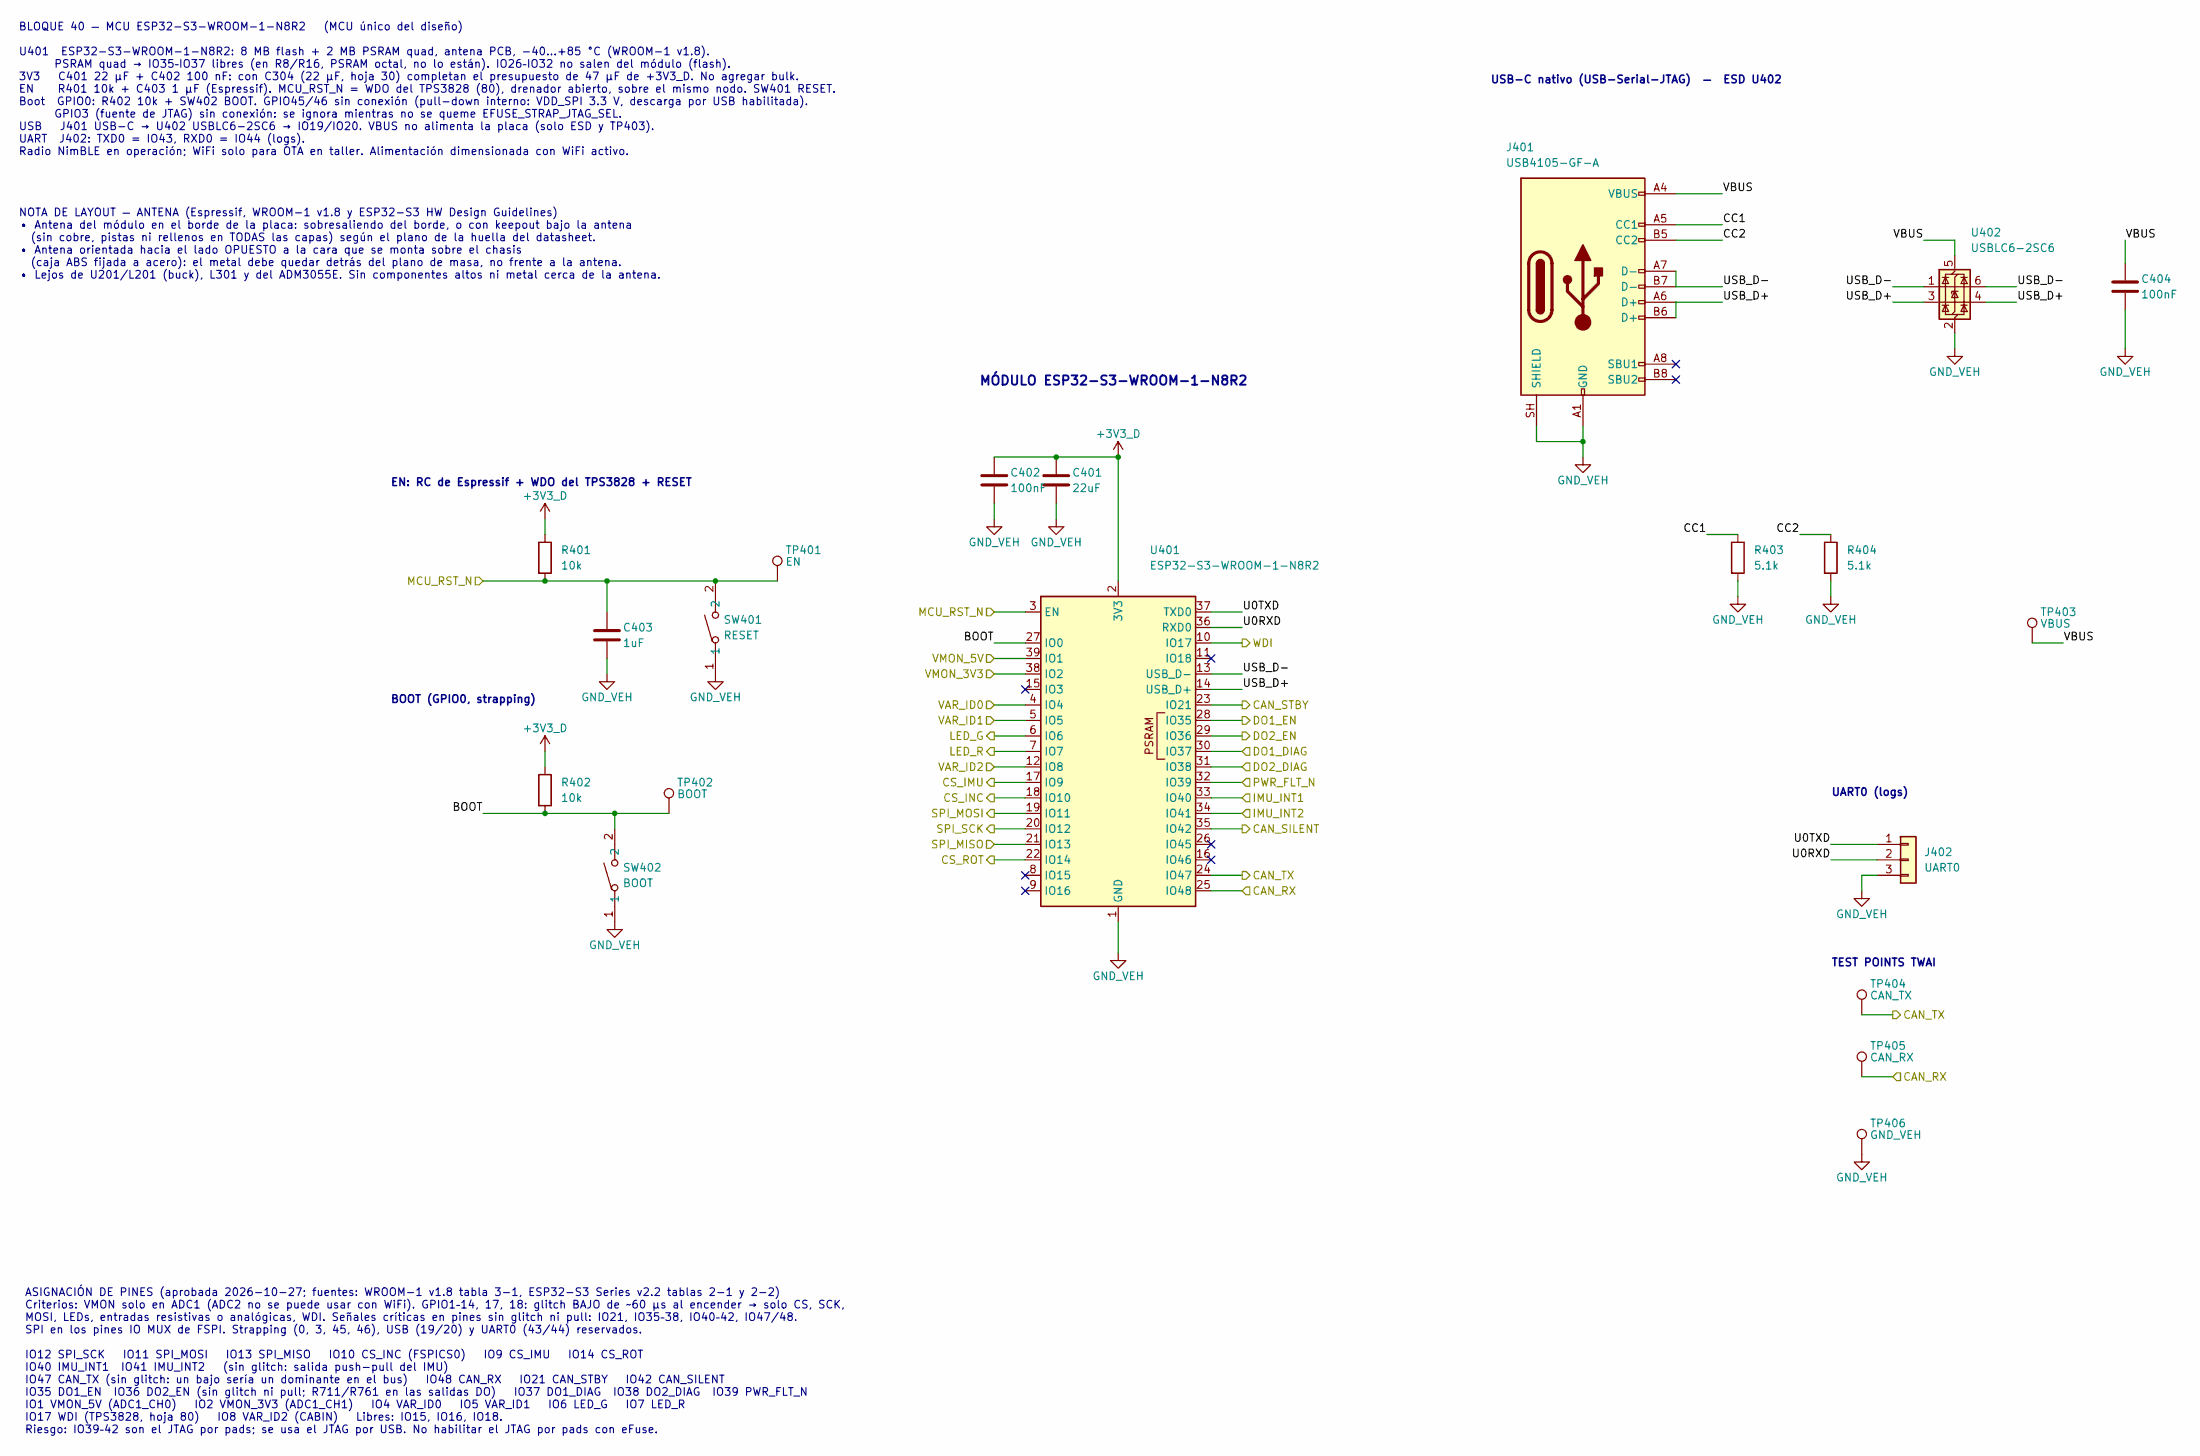
[picture p41: schematic 40_mcu_esp32s3.kicad_sch, MCU ESP32-S3-WROOM-1-N8R2]

Parts:
C401: 22uF; C_0805_2012Metric; MPN GRM21BZ71A226ME15L; LCSC C907991
C402, C404: 100nF; C_0603_1608Metric; MPN GCM188R72A104KA64D; LCSC C415406
C403: 1uF; C_0603_1608Metric; MPN GCM188R71C105KA64D; LCSC C161212
J401: USB4105-GF-A; USB_C_Receptacle_GCT_USB4105-xx-A_16P_TopMnt_Horizontal; MPN USB4105-GF-A; LCSC C3020560
J402: UART0; PinHeader_1x03_P2.54mm_Vertical; MPN 61300311121; LCSC C2915006
R401, R402: 10k; R_0603_1608Metric; MPN AC0603FR-0710KL; LCSC C116677
R403, R404: 5.1k; R_0603_1608Metric; MPN AC0603FR-075K1L; LCSC C125891
SW401: RESET; SW-SMD_L3.9-W3.0-P4.45; MPN TS-1088-AR02016; LCSC C720477
SW402: BOOT; SW-SMD_L3.9-W3.0-P4.45; MPN TS-1088-AR02016; LCSC C720477
TP401: EN; TestPoint_Pad_D1.5mm
TP402: BOOT; TestPoint_Pad_D1.5mm
TP403: VBUS; TestPoint_Pad_D1.5mm
TP404: CAN_TX; TestPoint_Pad_D1.5mm
TP405: CAN_RX; TestPoint_Pad_D1.5mm
TP406: GND_VEH; TestPoint_THTPad_D2.5mm_Drill1.2mm
U401: ESP32-S3-WROOM-1-N8R2; ESP32-S3-WROOM-1; MPN ESP32-S3-WROOM-1-N8R2; LCSC C2913204
U402: USBLC6-2SC6; SOT-23-6; MPN USBLC6-2SC6; LCSC C2687116

Connections:
+3V3_D: C401.1, C402.1, R401.1, R402.1, U401.2 (3V3); also elsewhere on the board
/40_mcu/BOOT: R402.2, SW402.2, TP402.1 (1_1), U401.27 (IO0)
/40_mcu/CC1: J401.A5 (CC1), R403.1
/40_mcu/CC2: J401.B5 (CC2), R404.1
/40_mcu/U0RXD: J402.2, U401.36 (RXD0)
/40_mcu/U0TXD: J402.1, U401.37 (TXD0)
/40_mcu/USB_D+: J401.A6 (D+), J401.B6 (D+), U401.14 (USB_D+), U402.3 (I/O2), U402.4 (I/O2)
/40_mcu/USB_D-: J401.A7 (D-), J401.B7 (D-), U401.13 (USB_D-), U402.1 (I/O1), U402.6 (I/O1)
/40_mcu/VBUS: C404.1, J401.A4 (VBUS), J401.A9 (VBUS), J401.B4 (VBUS), J401.B9 (VBUS), TP403.1 (1_1), U402.5 (VBUS)
/CAN_RX: TP405.1 (1_1), U401.25 (IO48); also elsewhere on the board
/CAN_SILENT: U401.35 (IO42); also elsewhere on the board
/CAN_STBY: U401.23 (IO21); also elsewhere on the board
/CAN_TX: TP404.1 (1_1), U401.24 (IO47); also elsewhere on the board
/CS_IMU: U401.17 (IO9); also elsewhere on the board
/CS_INC: U401.18 (IO10); also elsewhere on the board
/CS_ROT: U401.22 (IO14); also elsewhere on the board
/DO1_DIAG: U401.30 (IO37); also elsewhere on the board
/DO1_EN: U401.28 (IO35); also elsewhere on the board
/DO2_DIAG: U401.31 (IO38); also elsewhere on the board
/DO2_EN: U401.29 (IO36); also elsewhere on the board
/IMU_INT1: U401.33 (IO40); also elsewhere on the board
/IMU_INT2: U401.34 (IO41); also elsewhere on the board
/LED_G: U401.6 (IO6); also elsewhere on the board
/LED_R: U401.7 (IO7); also elsewhere on the board
/MCU_RST_N: C403.1, R401.2, SW401.2, TP401.1 (1_1), U401.3 (EN); also elsewhere on the board
/PWR_FLT_N: U401.32 (IO39); also elsewhere on the board
/SPI_MISO: U401.21 (IO13); also elsewhere on the board
/SPI_MOSI: U401.19 (IO11); also elsewhere on the board
/SPI_SCK: U401.20 (IO12); also elsewhere on the board
/VAR_ID0: U401.4 (IO4); also elsewhere on the board
/VAR_ID1: U401.5 (IO5); also elsewhere on the board
/VAR_ID2: U401.12 (IO8); also elsewhere on the board
/VMON_3V3: U401.38 (IO2); also elsewhere on the board
/VMON_5V: U401.39 (IO1); also elsewhere on the board
/WDI: U401.10 (IO17); also elsewhere on the board
GND_VEH: C401.2, C402.2, C403.2, C404.2, J401.A1 (GND), J401.A12 (GND), J401.B1 (GND), J401.B12 (GND), J401.SH (SHIELD), J402.3, R403.2, R404.2, SW401.1, SW402.1, TP406.1, U401.1 (GND), U401.40 (GND), U401.41 (GND), U402.2 (GND); also elsewhere on the board

Notes on the sheet:
UART0 (logs)
USB-C nativo (USB-Serial-JTAG) — ESD U402
ASIGNACIÓN DE PINES (aprobada 2026-10-27; fuentes: WROOM-1 v1.8 tabla 3-1, ESP32-S3 Series v2.2 tablas 2-1 y 2-2) Criterios: VMON solo en ADC1 (ADC2 no se puede usar con WiFi). GPIO1–14, 17, 18: glitch BAJO de ~60 µs al encender → solo CS, SCK, MOSI, LEDs, entradas resistivas o analógicas, WDI. Señ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
TEST POINTS TWAI
NOTA DE LAYOUT — ANTENA (Espressif, WROOM-1 v1.8 y ESP32-S3 HW Design Guidelines) • Antena del módulo en el borde de la placa: sobresaliendo del borde, o con keepout bajo la antena (sin cobre, pistas ni rellenos en TODAS las capas) según el plano de la huella del datasheet. • Antena orientada hacia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
EN: RC de Espressif + WDO del TPS3828 + RESET
BLOQUE 40 — MCU ESP32-S3-WROOM-1-N8R2 (MCU único del diseño) U401 ESP32-S3-WROOM-1-N8R2: 8 MB flash + 2 MB PSRAM quad, antena PCB, −40…+85 °C (WROOM-1 v1.8). PSRAM quad → IO35–IO37 libres (en R8/R16, PSRAM octal, no lo están). IO26–IO32 no salen del módulo (flash). 3V3 C401 22 µF + C402 100 nF: con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
BOOT (GPIO0, strapping)
MÓDULO ESP32-S3-WROOM-1-N8R2

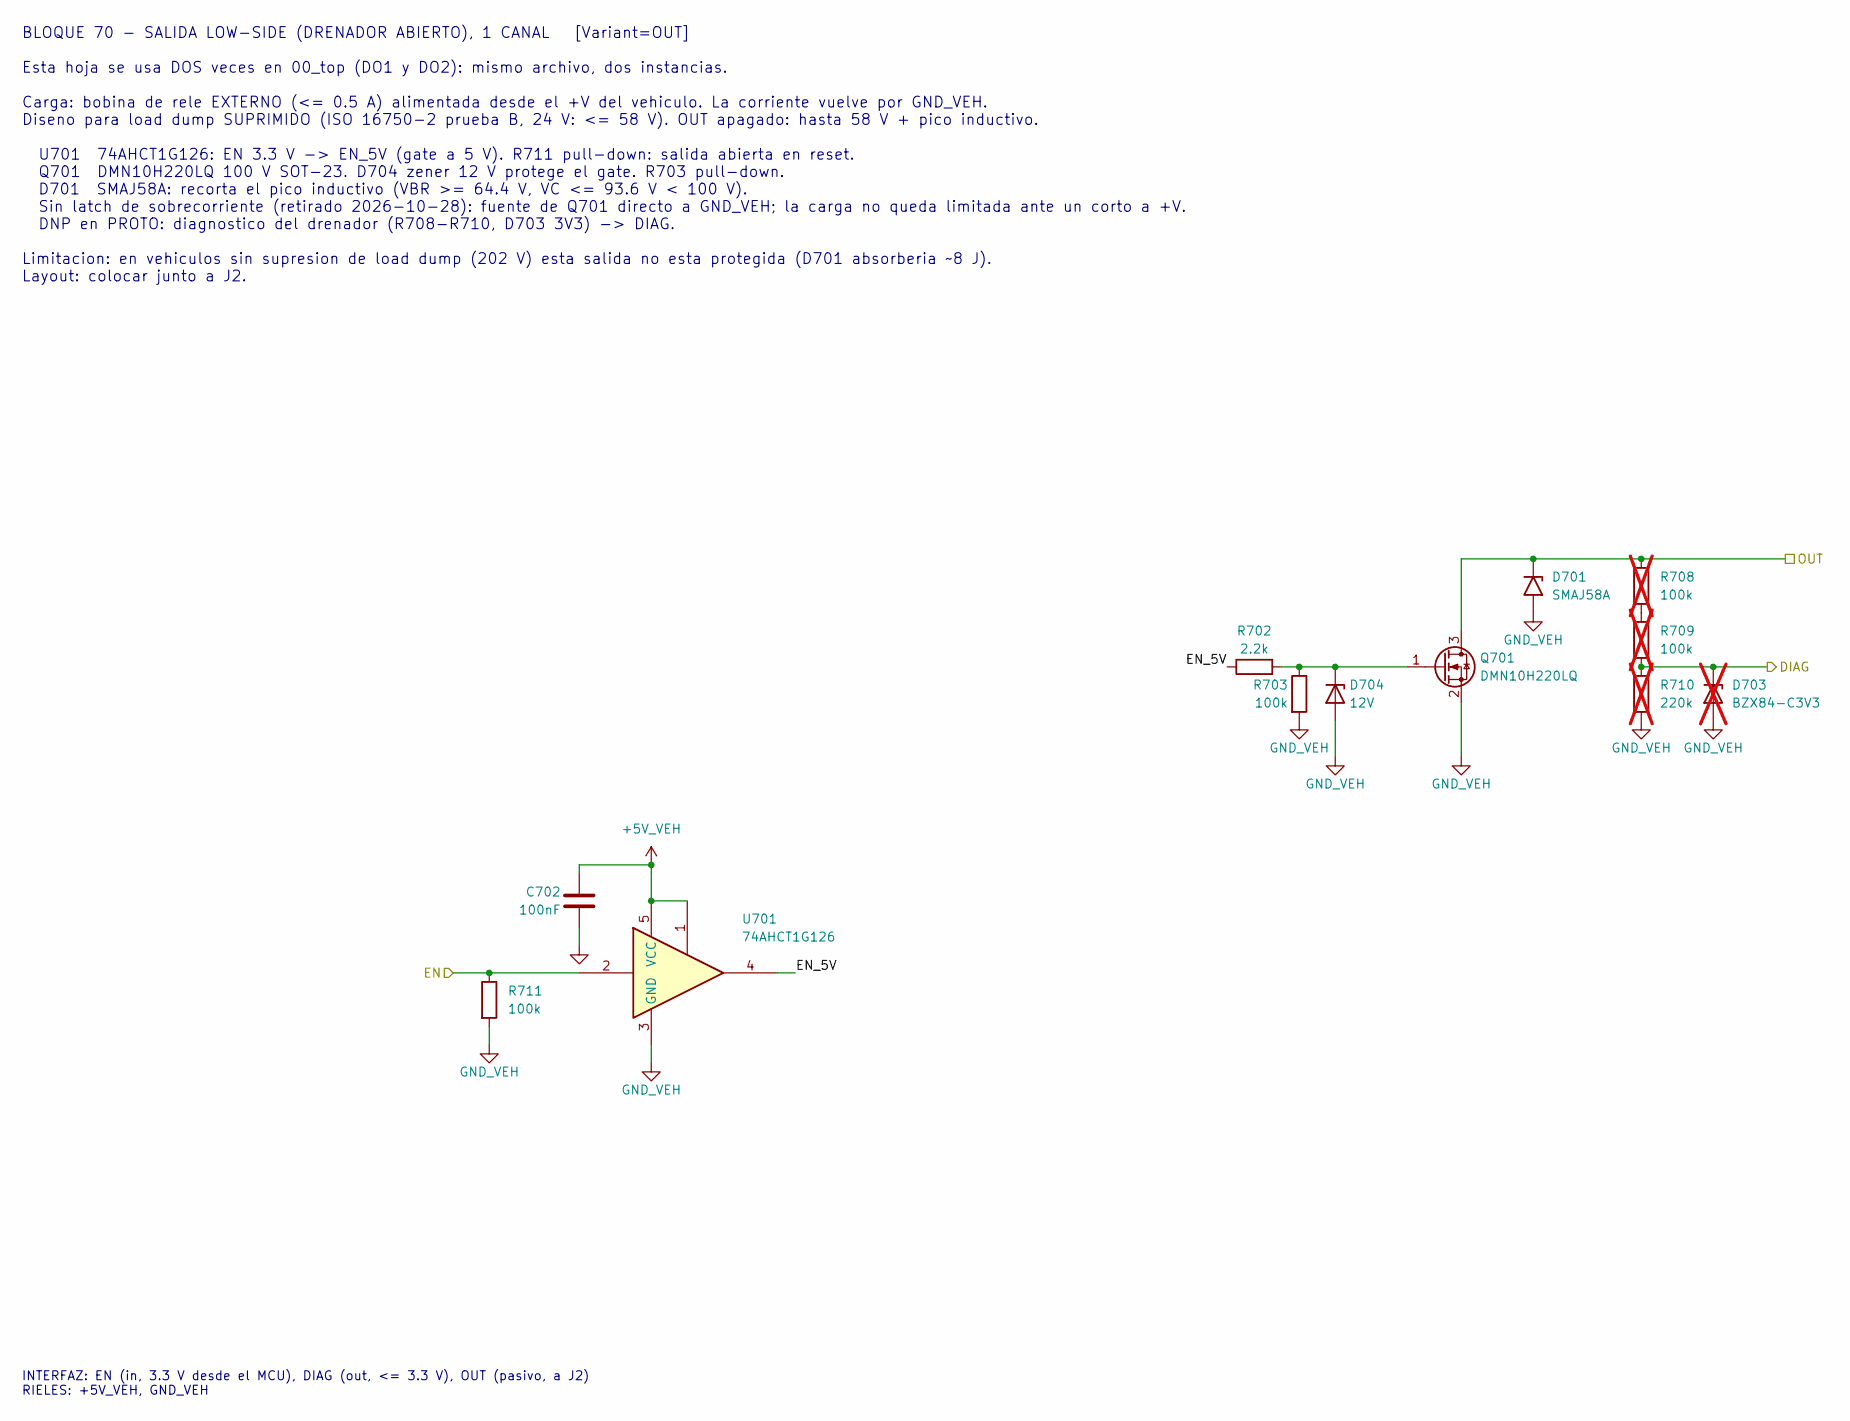
[picture p42: schematic 70_output_ch.kicad_sch, Salida low-side drenador abierto (x2)]

Parts:
C702: 100nF; C_0603_1608Metric; MPN GCM188R72A104KA64D; LCSC C415406
D701: SMAJ58A; D_SMA; MPN SMAJ58A; LCSC C123816
D703: BZX84-C3V3; SOT-23; MPN BZX84-C3V3,215; LCSC C85087; not fitted
D704: 12V; D_SOD-123; MPN MMSZ5242B-7-F; LCSC C500776
Q701: DMN10H220LQ; SOT-23; MPN DMN10H220LQ-7; LCSC C5260572
R702: 2.2k; R_0603_1608Metric; MPN AC0603FR-072K2L; LCSC C125931
R703, R711: 100k; R_0603_1608Metric; MPN AC0603FR-07100KL; LCSC C116674
R708, R709: 100k; R_1206_3216Metric; MPN AC1206FR-07100KL; LCSC C144522; not fitted
R710: 220k; R_0603_1608Metric; MPN AC0603FR-07220KL; LCSC C144681; not fitted
U701: 74AHCT1G126; SOT-23-5; MPN SN74AHCT1G126QDBVRQ1; LCSC_PROTO C163712

Connections:
+5V_VEH: C702.1, U701.1, U701.5 (VCC); also elsewhere on the board
/70_output_DO1/EN_5V: R702.1, U701.4
/DO1_DIAG: D703.3 (K), R709.2, R710.1; also elsewhere on the board
/DO1_EN: R711.1, U701.2; also elsewhere on the board
/VEH_DO1: D701.1 (A1), Q701.3 (D), R708.1; also elsewhere on the board
GND_VEH: C702.2, D701.2 (A2), D703.1 (A), D704.2 (A), Q701.2 (S), R703.2, R710.2, R711.2, U701.3 (GND); also elsewhere on the board
unnamed: D704.1 (K), Q701.1 (G), R702.2, R703.1
unnamed: R708.2, R709.1

Parts of its further copies:
C752: 100nF; C_0603_1608Metric; MPN GCM188R72A104KA64D; LCSC C415406
D751: SMAJ58A; D_SMA; MPN SMAJ58A; LCSC C123816
D753: BZX84-C3V3; SOT-23; MPN BZX84-C3V3,215; LCSC C85087; not fitted
D754: 12V; D_SOD-123; MPN MMSZ5242B-7-F; LCSC C500776
Q751: DMN10H220LQ; SOT-23; MPN DMN10H220LQ-7; LCSC C5260572
R752: 2.2k; R_0603_1608Metric; MPN AC0603FR-072K2L; LCSC C125931
R753, R761: 100k; R_0603_1608Metric; MPN AC0603FR-07100KL; LCSC C116674
R758, R759: 100k; R_1206_3216Metric; MPN AC1206FR-07100KL; LCSC C144522; not fitted
R760: 220k; R_0603_1608Metric; MPN AC0603FR-07220KL; LCSC C144681; not fitted
U751: 74AHCT1G126; SOT-23-5; MPN SN74AHCT1G126QDBVRQ1; LCSC_PROTO C163712

Connections of its further copies:
+5V_VEH: C752.1, U751.1, U751.5 (VCC); also elsewhere on the board
/70_output_DO2/EN_5V: R752.1, U751.4
/DO2_DIAG: D753.3 (K), R759.2, R760.1; also elsewhere on the board
/DO2_EN: R761.1, U751.2; also elsewhere on the board
/VEH_DO2: D751.1 (A1), Q751.3 (D), R758.1; also elsewhere on the board
GND_VEH: C752.2, D751.2 (A2), D753.1 (A), D754.2 (A), Q751.2 (S), R753.2, R760.2, R761.2, U751.3 (GND); also elsewhere on the board
unnamed: D754.1 (K), Q751.1 (G), R752.2, R753.1
unnamed: R758.2, R759.1

Notes on the sheet:
INTERFAZ: EN (in, 3.3 V desde el MCU), DIAG (out, <= 3.3 V), OUT (pasivo, a J2) RIELES: +5V_VEH, GND_VEH
BLOQUE 70 - SALIDA LOW-SIDE (DRENADOR ABIERTO), 1 CANAL [Variant=OUT] Esta hoja se usa DOS veces en 00_top (DO1 y DO2): mismo archivo, dos instancias. Carga: bobina de rele EXTERNO (<= 0.5 A) alimentada desde el +V del vehiculo. La corriente vuelve por GND_VEH. Diseno para load dump SUPRIMIDO (ISO 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

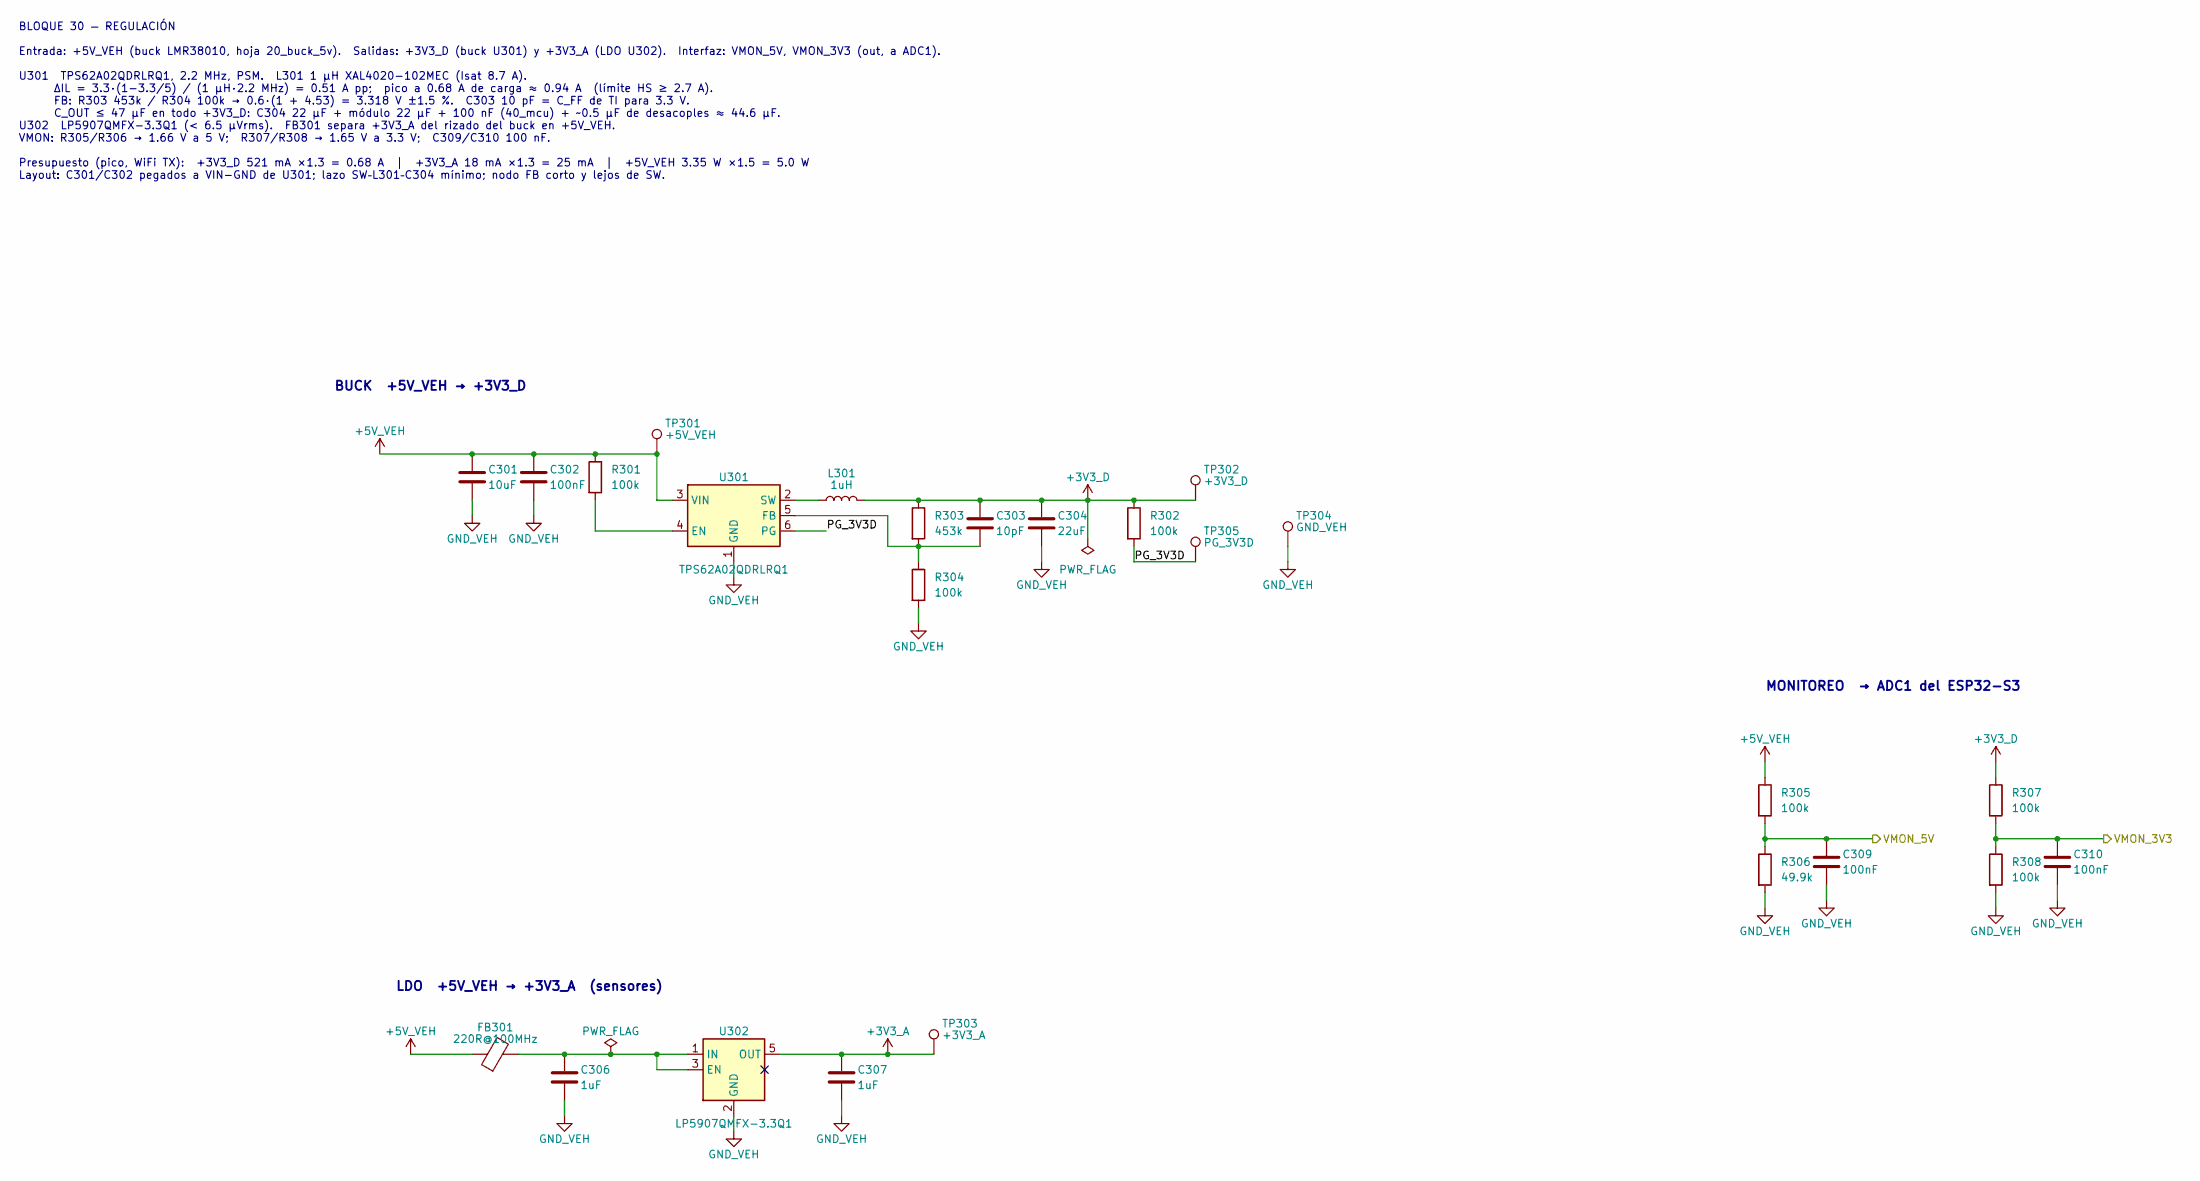
[picture p43: schematic 30_regulation.kicad_sch, Regulación lógica]

Parts:
C301: 10uF; C_0805_2012Metric; MPN GCM21BR71A106KE22L; LCSC C126586
C302, C309, C310: 100nF; C_0603_1608Metric; MPN GCM188R72A104KA64D; LCSC C415406
C303: 10pF; C_0603_1608Metric; MPN GCM1885C1H100JA16D; LCSC C126542
C304: 22uF; C_0805_2012Metric; MPN GRM21BZ71A226ME15L; LCSC C907991
C306, C307: 1uF; C_0603_1608Metric; MPN GCM188R71C105KA64D; LCSC C161212
FB301: 220R@100MHz; L_0603_1608Metric; MPN BLM18PG221SN1D; LCSC C80165
L301: 1uH; L_Coilcraft_XAL4020_HandSolder; MPN XAL4020-102MEC; LCSC C4555951
R301, R302, R304, R305, R307, R308: 100k; R_0603_1608Metric; MPN AC0603FR-07100KL; LCSC C116674
R303: 453k; R_0603_1608Metric; MPN AC0603FR-07453KL; LCSC C227908
R306: 49.9k; R_0603_1608Metric; MPN AC0603FR-0749K9L; LCSC C144654
TP301: +5V_VEH; TestPoint_Pad_D1.5mm
TP302: +3V3_D; TestPoint_Pad_D1.5mm
TP303: +3V3_A; TestPoint_Pad_D1.5mm
TP304: GND_VEH; TestPoint_Pad_D1.5mm
TP305: PG_3V3D; TestPoint_Pad_D1.5mm
U301: TPS62A02QDRLRQ1; SOT-563; MPN TPS62A02QDRLRQ1; LCSC C49259289
U302: LP5907QMFX-3.3Q1; SOT-23-5; MPN LP5907QMFX-3.3Q1; LCSC C130005

Connections:
+3V3_A: C307.1, TP303.1 (1_1), U302.5 (OUT); also elsewhere on the board
+3V3_D: C303.1, C304.1, L301.2, R302.1, R303.1, R307.1, TP302.1 (1_1); also elsewhere on the board
+5V_VEH: C301.1, C302.1, FB301.1, R301.1, R305.1, TP301.1 (1_1), U301.3 (VIN); also elsewhere on the board
/30_regulation/PG_3V3D: R302.2, TP305.1 (1_1), U301.6 (PG)
/VMON_3V3: C310.1, R307.2, R308.1; also elsewhere on the board
/VMON_5V: C309.1, R305.2, R306.1; also elsewhere on the board
GND_VEH: C301.2, C302.2, C304.2, C306.2, C307.2, C309.2, C310.2, R304.2, R306.2, R308.2, TP304.1 (1_1), U301.1 (GND), U302.2 (GND); also elsewhere on the board
unnamed: R301.2, U301.4 (EN)
unnamed: C303.2, R303.2, R304.1, U301.5 (FB)
unnamed: L301.1, U301.2 (SW)
unnamed: C306.1, FB301.2, U302.1 (IN), U302.3 (EN)

Notes on the sheet:
MONITOREO → ADC1 del ESP32-S3
LDO +5V_VEH → +3V3_A (sensores)
BUCK +5V_VEH → +3V3_D
BLOQUE 30 — REGULACIÓN Entrada: +5V_VEH (buck LMR38010, hoja 20_buck_5v). Salidas: +3V3_D (buck U301) y +3V3_A (LDO U302). Interfaz: VMON_5V, VMON_3V3 (out, a ADC1). U301 TPS62A02QDRLRQ1, 2.2 MHz, PSM. L301 1 µH XAL4020-102MEC (Isat 8.7 A). ΔIL = 3.3·(1−3.3/5) / (1 µH·2.2 MHz) = 0.51 A pp; pico a 0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

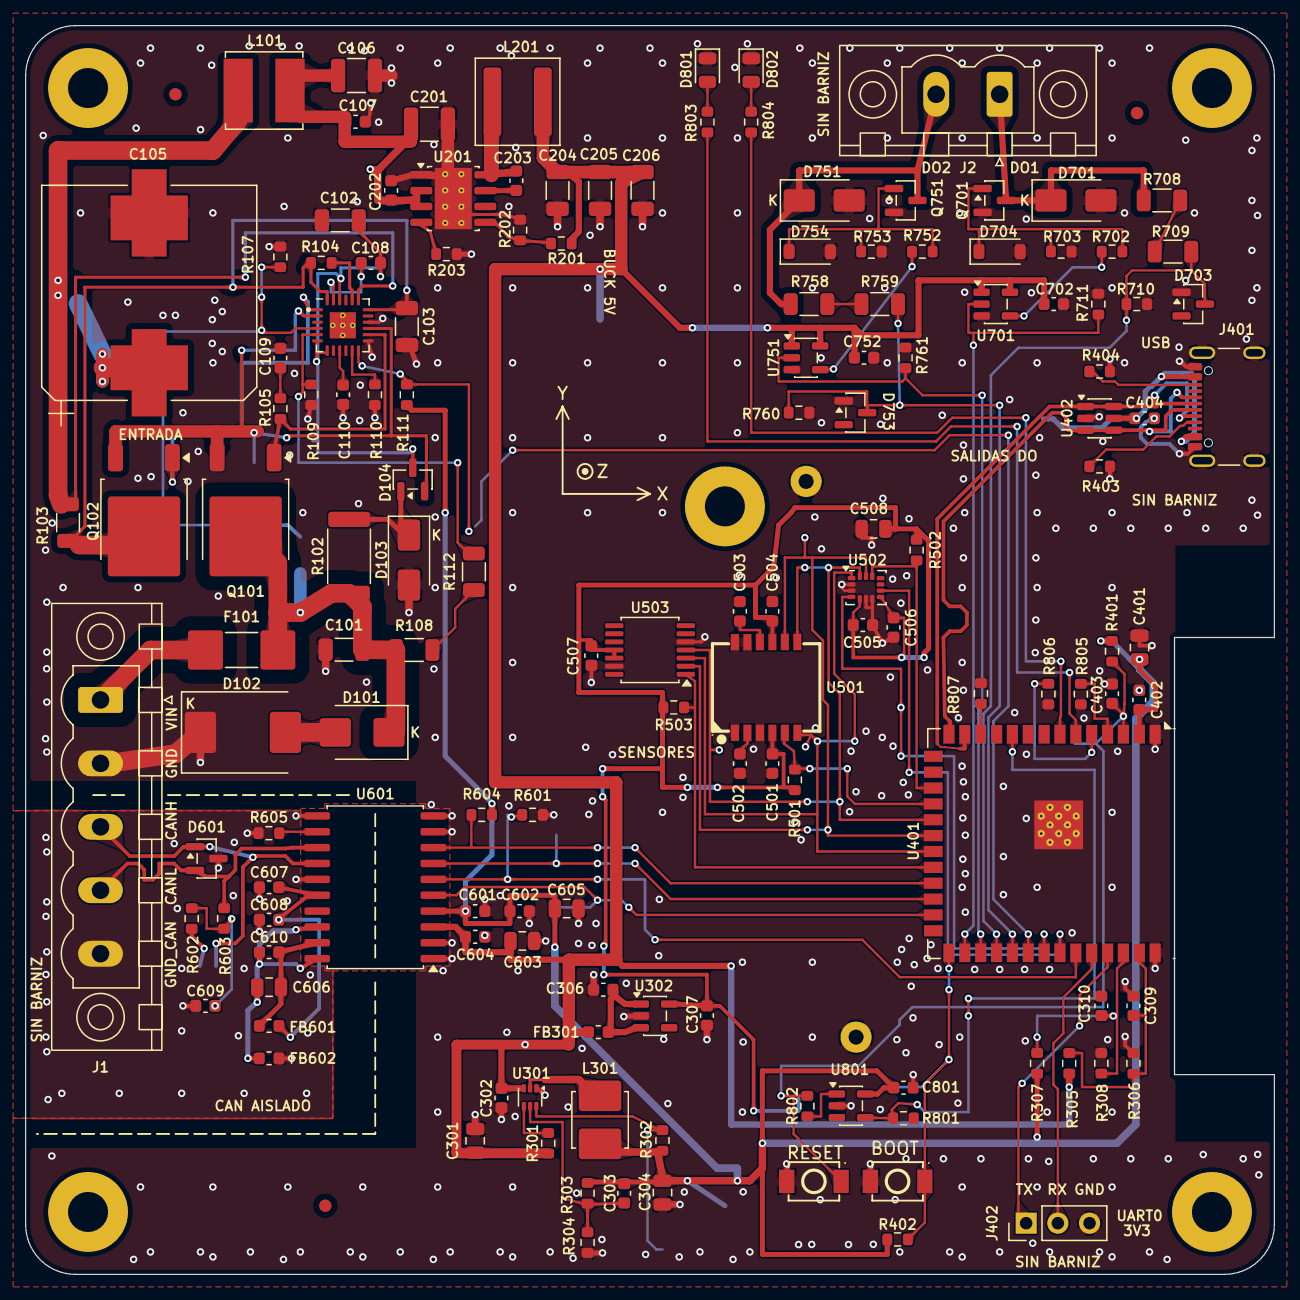
[picture p44: board INCLI-VA.kicad_pcb from above]

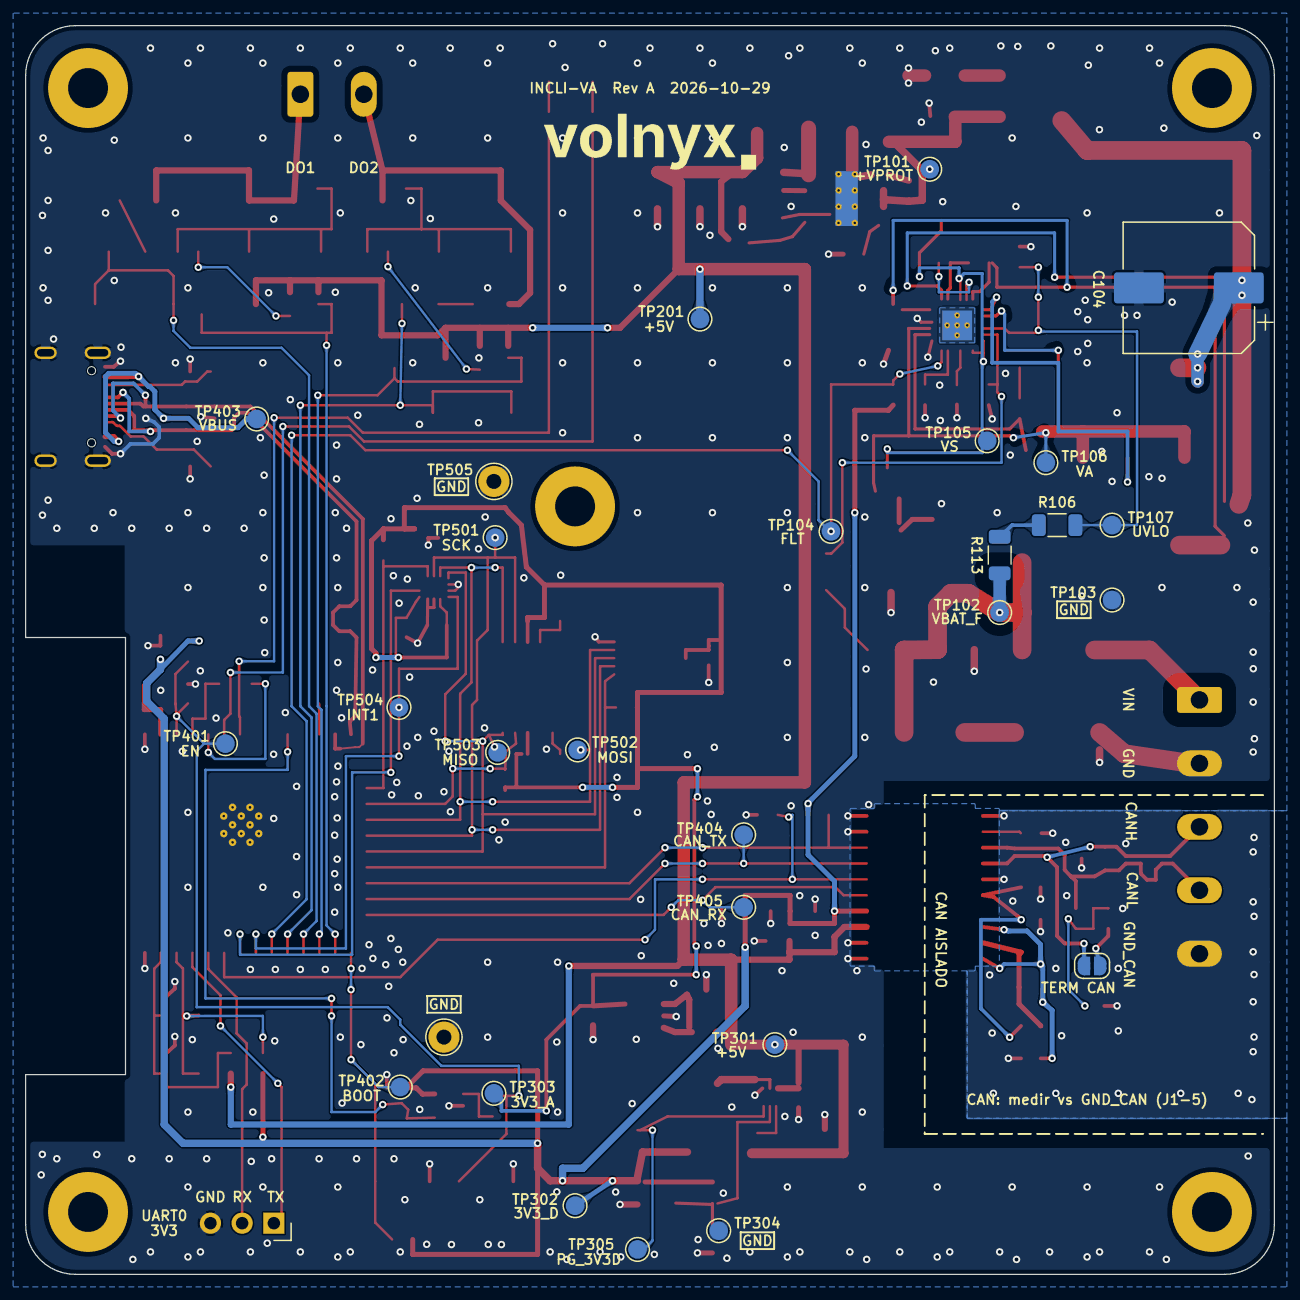
[picture p45: board INCLI-VA.kicad_pcb from below]

Board: 2 copper layers, 100.0 x 100.0 mm, 180 parts (29 on the bottom side), 89 nets.

Other parts of the board:
LOGO1: Logo_Volnyx_Wordmark
