elvisdt/PCB_INCLI_VA/(commit log)

2026-10-27 Corrige la base del esquemático y añade reglas de proyecto
    - Extrae el símbolo ADM3055E a lib/antmicro_adm3055ebriz.kicad_sym y lo
    registra en sym-lib-table con ${KIPRJMOD}.
    - U1: huella Package_SO:SOIC-20W_7.5x12.8mm_P1.27mm (nota: verificar
    land pattern contra el datasheet).
    - 10_power_input: power:GND -> GND_VEH; huellas y MPN de C1, C2 (0805
    X7R 100 V automotriz), C3 (EEE-HA2A470UP, 10x10) y F1 (1812, MPN
    pendiente).
    - Nuevos pines jerárquicos CAN_SILENT (40_mcu -> 60_can, pull-down R1
    10k a GND_ISO) e IMU_INT2 (50_sensors -> 40_mcu).
    - CLAUDE.md con reglas de librerías, campos, conexiones entre hojas,
    verificación por hoja y versión prototipo.
    - Ignora output/ (report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
2026-10-27 70_output: salida low-side con latch y señal PWR_FLT
    - 70_output (DO1/DO2): MOSFET FDD7N25LZ (demo, 250 V) con TVS SMCJ188A
    en el drenador, latch de sobrecorriente a ~0.7 A (R 1 ohm + BC817/BC807,
    rearme con EN=0), apagado del gate por PWR_FLT_N o latch (BAT54A) y
    DIAG por divisor del drenador con zener 5V1. OUT pasa a pasivo.
    - Jerarquía: VEH_PWR_FLT_N de 10_power_input a 70_output y 20_isolation;
    PWR_FLT de 20_isolation a 40_mcu (KW45 y ESP32-S3).
    - 10_power_input: solo interfaz (VEH_DO1/2 pasivos, VEH_PWR_FLT_N);
    el circuito con LM74930 va en un commit aparte.
    - CLAUDE.md: procedimiento para componentes fuera de las librerías.
    - README: 70_output es low-side.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
2026-10-27 10_power_input: protección de entrada con LM74930-Q1 y conectores
    - U101 LM74930-Q1 (ref. TI 8.2, load dump 202 V sin suprimir):
    Q101 STD18NF25 (corte, 250 V) + Q102 IPD30N10S3L-34 (diodo ideal),
    corte por OV a 38.4 V, UVLO ~6.5 V, breaker 1 A (R_SENSE 10 mohm,
    R_ILIM 60.4k), corto 2 A, C_TMR 68 nF, VS con R 10k + SMAJ51A + BAS21.
    FLT -> VEH_PWR_FLT_N. Pad expuesto (RTN) flotante según TI.
    - Entrada: F101 2 A/250 VDC (huella 2410 pendiente), D101 ES2G +
    D102 SMCJ33A, C_IN 450 V. Salida: C104 47 uF, hold-up C105 DNP,
    filtro LC a +VPROT. PWR_FLAG y test points.
    - J1 MSTB 5 pines (V+, GND_VEH, CAN_H, CAN_L, CAN_GND) y J2 MSTB 2
    pines (DO1, DO2). Se elimina el circuito anterior c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
2026-10-27 U101: huella VQFN-24 corregida en INCLI-VA.pretty
    - Nueva huella TI_RGE0024T_..._HandSolder_IsolatedVias a partir del land
    pattern de TI (RGE0024T): paso exacto de 0.5 mm, pads de 0.85 mm (mismo
    borde interior que TI, más largos para soldar a mano), pasta del EP en
    4 x 0.94 mm, 5 vías de 0.2 mm hacia una isla aislada en B.Cu (el EP es
    RTN y debe quedar flotante), courtyard de +-2.7 mm y modelo 3D con
    ${KIPRJMOD}/lib/INCLI-VA.3dshapes.
    - U101 y el símbolo LM74930QRGERQ1 apuntan a la huella nueva.
    - CLAUDE.md: excepción para crear huellas de pasivos de 2 terminales
    desde el datasheet en INCLI-VA.pretty.
2026-10-27 Nota EP/RTN de U101, regla de PCB y verificación del FDD7N25LZ
    - 10_power_input: nota visible junto a U101 "EP/RTN flotante: NO conectar
    a GND (datasheet SNOSDF6, tabla 5-1 y sección 8.3)".
    - CLAUDE.md (PCB): la red del pad 25 de U101 nunca se une a GND ni a otra
    red; regla DRC personalizada al empezar el PCB.
    - 70_output: Notes de Q701 con datos del datasheet: no es AEC-Q101,
    RDS(on) a 5 V (0.57 ohm máx a 25 C, ~0.91 ohm a 85 C), margen de BVDSS
    y SOA con corto a +32 V. El filtro del latch no necesita cambios.
    - docs/datasheets/FDD7N25LZ.pdf.
2026-10-27 Cambios guardados desde KiCad en 10, 50, 60 y 70 (sin revisar)
    Cambios del editor guardados el 2026-10-27 00:09, posteriores al commit
    dcee817 y ajenos a la sesión de Claude: reordenamiento en 50_sensors y
    cambios de cables/propiedades en 10_power_input, 60_can y 70_output_ch.
    Se separan aquí para no mezclarlos con el cambio de alcance siguiente.
2026-10-27 Alcance: solo ESP32-S3, CAN clásico por TWAI, sin MCP2518FD
    - Raíz: el bloque 40_mcu apunta a 40_mcu_esp32s3. 40_mcu_kw45 queda en
    el repo solo como referencia, fuera de la jerarquía.
    - CAN: se eliminan el MCP2518FD, el cristal y los pines CANFD_SCK/MOSI/
    MISO, CS_CAN e INT_CAN en 60_can, 40_mcu_esp32s3 y la raíz (etiquetas,
    cables y pines de hoja). TWAI nativo (J1939) directo al ADM3055E.
    Se quita la variante CANFD.
    - 20_isolation (nota): PS1 >= 5 W y entrada 9-72 V (corte OV 38.4 V);
    U2 = TPS7A1650-Q1 para +5V_VEH.
    - 40_mcu_esp32s3 (nota): desacople 22 uF + 100 nF según Espressif y
    límite de 47 uF en +3V3_D por el TPS62A02-Q1; solo BLE en operación.
    - README: tabla corre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
2026-10-27 ADM3055E: consumo de VCC confirmado con el datasheet Rev. D
    - ICC en dominante con RL = 60 ohm: 180 mA típ / 260 mA máx (tabla 1);
    IIO 3.6 / 5 mA. Anotado en 60_can.
    - +5V_ISO pico: 0.26 A (ADM3055E) + 0.39 A (buck, 521 mA en +3V3_D con
    WiFi TX) + 0.02 A (LDO) = 3.35 W; x1.5 = 5.0 W. PS1 se mantiene en
    >= 5 W (no hace falta 6 W). Nota de 20_isolation actualizada.
    - docs/datasheets/adm3055e-adm3057e.pdf.
2026-10-27 30_regulation: buck TPS62A02-Q1 (+3V3_D), LDO LP5907-Q1 (+3V3_A) y VMON
    - U301 TPS62A02QDRLRQ1 (+5V_ISO -> +3V3_D, 2 A, 2.2 MHz, PSM):
    L301 XAL4020-102MEC 1 uH (Isat 8.7 A); FB R303 453k / R304 100k ->
    3.318 V, C_FF C303 10 pF (TI); C_IN 10 uF 0805 + 100 nF; C_OUT C304
    22 uF 0805 (presupuesto de 47 uF en +3V3_D con el módulo); EN con
    pull-up; PG con pull-up a +3V3_D y test point.
    - U302 LP5907QMFX-3.3Q1 (+5V_ISO -> +3V3_A) detrás de la ferrita FB301,
    C_IN/C_OUT 1 uF, PWR_FLAG en la entrada.
    - VMON_5V (100k/49.9k) y VMON_3V3 (100k/100k) con 100 nF hacia ADC1.
    - Test points en +5V_ISO, +3V3_D, +3V3_A, GND_ISO y PG.
    - Símbolos TPS62A02QDRLRQ1 y TPS7A1650QDGNRQ1 (easyeda2kicad) rees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
2026-10-27 20_isolation: PS201 EC4AW8-48S05, LDO +5V_VEH, ISO7763-Q1; PWR_FLT_N; L301 HandSolder
    - Hoja 20 completa: PS201 Cincon EC4AW8-48S05 (sin Remote On/Off) con
    C201/C202/C203; U201 TPS7A1650-Q1 (+VPROT -> +5V_VEH; DELAY, PG y FB/NC
    abiertos según TI SBVS188E tabla 5-1); U202 ISO7763FQDWRQ1 con pull-downs
    R201-R204; notas de distancias de la barrera 1.
    - Símbolo INCLI-VA:EC4AW8-48S05 creado desde la tabla de pines del datasheet
    Cincon V10 (excepción autorizada); huella oficial TRACO THD 15WIN verificada.
    - Renombre PWR_FLT -> PWR_FLT_N en la raíz, 20 y 40_mcu.
    - Huella INCLI-VA:L_Coilcraft_XAL4020_HandSolder (Coilcraft Doc 806-4,
    rev. 02/25/26) asignada a L301.
    - Datasheets de EC4AW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
2026-10-27 [Claude Code] Reglas compartidas en AGENTS.md y docs/PENDIENTES.md
    - Reglas del proyecto movidas de CLAUDE.md a AGENTS.md (eran idénticas,
    sin contradicciones); CLAUDE.md queda como "@AGENTS.md".
    - Nueva sección "Trabajo entre agentes" (Claude Code y Codex por turnos).
    - docs/PENDIENTES.md: fases terminadas (10, 20, 30, 70), hojas que faltan,
    integración y pendientes de BOM (F101, header de J2, C105 y MPN a verificar).
    - .codex/ en .gitignore (configuración local).
2026-10-27 [Claude Code] 40_mcu_esp32s3: ESP32-S3-WROOM-1-N8R2, USB-C nativo, UART0 (fase 4)
    - U401 ESP32-S3-WROOM-1-N8R2 (símbolo y huella oficiales). Asignación de
    pines aprobada: VMON en ADC1, señales críticas (DO_EN, DIAG, PWR_FLT_N,
    CAN, IMU_INT) en pines sin glitch de encendido, SPI en IO MUX de FSPI,
    strapping/USB/UART0 reservados. Tabla y criterios en la hoja.
    - Desacople 22 uF + 100 nF (presupuesto de 47 uF de +3V3_D).
    - EN: 10k + 1 uF (Espressif) sobre MCU_RST_N; botones RESET y BOOT.
    - USB-C GCT USB4105-GF-A + USBLC6-2SC6 en IO19/20; CC 5.1k; opción de
    banco DNP VBUS -> D401 -> JP401 -> +5V_ISO (~4.6 V, CAN no garantizado).
    - Header UART0 (IO43/44), test points de EN, BOOT, VBUS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
2026-10-27 [Claude Code] 50_sensors: SCL3300-D01, ASM330LHH, AS5147U (ROT) en SPI compartido (fase 5)
    - U501 SCL3300-D01: 4 x 100 nF (VDD, A_EXTC, D_EXTC, DVIO) según Murata
    Doc. 4921 fig. 16 / tabla 48. SPI modo 0, <= 8 MHz.
    - U502 ASM330LHHTR (LGA, aire caliente): 100 nF + 10 uF en VDD y 100 nF en
    VDDIO (ST fig. 14); INT1/INT2 a IMU_INT1/2. SPI modo 3, <= 10 MHz.
    - U503 AS5147U-HTSM: solo variante ROT (DNP en estándar junto con C507 y
    R503, campo Variant = ROT). SPI modo 1, <= 10 MHz.
    - Pull-ups de 10 k a +3V3_A en los tres CS; TP de SCK, MOSI, MISO e INT1.
    - Notas de layout: SCL3300 junto a las fijaciones y lejos del calor, ejes
    en serigrafía, placa centrada sobre el pivote en la variante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
2026-10-27 [Claude Code] PENDIENTES: decisiones del usuario para 60_can, 80_supervision y PCB
    Sección "Decisiones del usuario" con 25 preguntas (terminación y ESD del
    CAN, STBY, watchdog, ID de variante, LED, caja, fijaciones, orientación,
    conectores, stackup, fabricante, montaje, coating y pendientes de BOM).
2026-10-27 move pcb
2026-10-27 order pcb
2026-10-28 [Claude Code] 60_can, 70_output, 10_power_input: criterio prototipo = producción, campo DNP
    - 60_can: ADM3055E según datasheet Rev. D (tabla 10): FB602 separa GNDISO
    de GND2, VISOOUT con 0.22 uF + 10 uF, RS a GND2 por R605 (0 ohm), AUXIN a
    GND1, pull-up de STBY, ESD2CAN24-Q1 DNP; referencias 6xx y campos completos.
    - 70_output: DMN10H220LQ (100 V, SOT-23), SMAJ58A, buffer 74AHCT1G126
    (3.3 -> 5 V), zener de gate; latch y diagnóstico como huellas DNP.
    - 10_power_input: J1/J2 MSTB 2,5 de 5.08 mm GF (J2 = 1776508), F101
    SF-2410FPA200W-2, C105 hold-up DNP; se quita un PWR_FLAG suelto en GND_CAN.
    - Campo DNP (vacío / PROTO / PROD / PROTO,PROD) en todos los símbolos.
    - README y PENDIEN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
2026-10-28 [Claude Code] PENDIENTES: decisiones de la hoja 20 (LMR38010-Q1), C105/C109, limitación de las DO
    - Buck LMR38010SQDDARQ1 con su diseño calculado (TI SNVSC73B), huella oficial
    con vías térmicas comparada con DDA0008B; falta el símbolo (pedido al usuario).
    - R109 queda en 1.62 k; sin TVS de entrada grande.
    - C105 montado en PROD: requiere C109 = 100 nF (con 10 nF el inrush sería ~5.9 A
    y dispararía el breaker de 1 A).
    - Limitación conocida: DO sin protección con load dump sin suprimir.
    - Edición de esquemáticos deshecha: KiCad estaba abierto.
2026-10-28 [Claude Code] PENDIENTES: equivalencia LMR38010SDDAR (proto) / LMR38010SQDDARQ1 (prod), campo MPN_PROTO
    Verificado con las tablas de variantes de TI SNVSC73B y SNVSC72B: S = PFM +
    spread spectrum, F = FPWM. Mismo pinout, encapsulado DDA0008B y parámetros;
    solo cambia la calificación AEC-Q100.
2026-10-28 [Claude Code] 20_buck_5v: opción B (no aislada) con LMR38010; masas unificadas
    - sheets/20_isolation -> sheets/20_buck_5v: se quitan PS201, ISO7763 y
    TPS7A1650; U201 LMR38010SQDDARQ1 (PROTO: LMR38010SDDAR, LCSC C5219310),
    5.02 V / 1 A a 400 kHz según TI SNVSC73B (L201 XAL6060-333, 3 x 22 uF,
    RT 64.9k, FB 100k/24.9k). Huella oficial HSOIC-8 con vías térmicas.
    - Símbolo LMR38010 (easyeda2kicad) en lib/easyeda2kicad/INCLI-VA_easyeda,
    con tipos de pin ajustados; registrado en sym-lib-table.
    - Todas las hojas: GND_ISO -> GND_VEH, +5V_ISO -> +5V_VEH.
    - Raíz: EN/DIAG/FLT directos entre las hojas 40, 70 y 10; la hoja 20 sin pines.
    - 10_power_input: R111 a +3V3_D, C109 = 100 nF (inrush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
2026-10-28 [Claude Code] DRU para JLCPCB, red U101_RTN y limpieza de librerías
    - INCLI-VA.kicad_dru: capacidades de JLCPCB (2 capas, 1 oz, 1.6 mm) con
    margen; separación HV en la entrada (1.25 mm, IPC-2221B B2), DO y
    +VPROT (0.6 mm); barrera del ADM3055E (2.5 mm + sin relleno bajo U601);
    anchos IPC-2152 (entrada 1.0 mm, DO y 5 V 0.5 mm); reglas para el pad 25
    de U101 (aislado y nunca GND, probado en una copia).
    - U101 pin 25 (EP): no_connect -> passive en la librería y la caché;
    etiqueta U101_RTN en 10_power_input. En el PCB, las 7 redes
    unconnected-(U101-EP-Pad25)_N quedan como /10_power_input/U101_RTN
    (sin Update PCB from Schematic).
    - Se borran las huellas y modelos 3D de URB2405 y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
2026-10-28 [Claude Code] PENDIENTES: J1/J2 MSTB 2,5 horizontal GF 5.08 y sus enchufes STF
    Header J1 1776537 (5 polos) + enchufe 1778014; header J2 1776508 (2 polos)
    + enchufe 1777989. El PCB todavía tiene MCV 1,5 de 3.81 mm: se corrige
    con Update PCB from Schematic.
2026-10-28 [Claude Code] 80_supervision: TPS3828-33-Q1, LED y VAR_ID; J1/J2 verticales; contorno con muesca
    - 80_supervision: U801 TPS3828-33QDBVRQ1 (supervisor de +3V3_D + watchdog,
    WDI <- IO17), R802 0 ohm, R801 DNP; LED verde/rojo DNP en PROD (caja
    opaca); VAR_ID0/1 (CAN/OUT) y VAR_ID2 (IO8, CABIN, DNP).
    - WD_EN eliminado (IO18 libre); VAR_ID2 ocupa su pin en las hojas 40/80 y la raíz.
    - 10_power_input: J1/J2 MSTBV 2,5 GF 5.08 verticales (1777109 / 1777073).
    - lib: se borran los símbolos URB2405 y TPS7A1650; U101: vías del EP a Ø 0.45 mm.
    - PCB: contorno único con muesca de 8 x 35 mm para la antena (antes, dos
    rectángulos superpuestos); serigrafía de U401 recortada en la muesca.
    - ERC: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
2026-10-28 PCB: Update PCB from Schematic (hecho por el usuario en KiCad, F8)
    Vinculado por UUID, con reemplazo de huellas y sin actualizar desde la
    librería. Entran las hojas 60/70/80 y el buck de 20; salen PS201, U202 y
    los pasivos de la opción aislada. Efecto colateral: se borraron los
    agujeros de montaje H1-H4, que solo estaban en el PCB.
2026-10-28 [Claude Code] DRC: excepción documentada para J401; J1/J2 MSTBV confirmados en Phoenix
    - INCLI-VA.kicad_dru: regla J401_land_pattern_oficial (hole_clearance
    >= 0.19 mm solo dentro de J401). Land pattern oficial de GCT, 6 um bajo
    el mínimo de JLCPCB; aceptado por el usuario.
    - PENDIENTES: 1777109 / 1777073 confirmados en phoenixcontact.com, enchufes
    1778014 / 1777989; resultado del DRC después de Update PCB from Schematic;
    H1-H4 borrados por la actualización.
2026-10-28 [Claude Code] raíz: agujeros de fijación H1-H4 (M3, sin cobre) en el esquemático
    Mechanical:MountingHole + MountingHole_3.2mm_M3 (NPTH, sin cobre), fuera
    del BOM, para que Update PCB from Schematic no los vuelva a borrar. La
    posición la define el layout.
2026-10-28 [Codex] Integra cierre de Claude y valida sincronizacion previa al layout
2026-10-28 [Codex] Adjunta reglas y librerias del proyecto a la propuesta de layout
2026-10-28 [Codex] Registra retoma y objetivo de PCB de 100x100 mm
2026-10-28 [Codex] Reubica 186 huellas en propuesta PCB de 100x100 mm
2026-10-28 [Codex] Retira H5 del esquematico y cierra revision para layout 100x100
2026-10-28 [Claude Code] Revision: valida cierre de Codex (ERC, sch_visual_qa, DRC y paridad de la propuesta 100x100)
2026-10-28 [Claude Code] 70_output: retira latch de sobrecorriente y R701/R751; borra propuesta 120x80
    - 70_output_ch (DO1/DO2): fuera Q702/Q703, D702, R704-R707, C701 y R701
    (y equivalentes 75x). Fuente de Q701 directo a GND_VEH. PWR_FLT_N deja de
    entrar a la hoja 70 (pin jerarquico y conexiones de la raiz retirados).
    Se conserva el diagnostico (DNP en PROTO).
    - ERC 0 errores / 1 aviso conocido. Paridad con la propuesta 100x100:
    22 diferencias esperadas, pendiente Update PCB from Schematic.
    - docs/layout: se borra la propuesta 120x80 (recuperable de aa0a41b).
2026-10-28 [Claude Code] PCB: adopta la propuesta 100x100 como INCLI-VA.kicad_pcb
    Copia docs/layout/INCLI-VA-100x100.kicad_pcb sobre el PCB principal (sin
    cambios propios desde 17a9676) y borra la copia duplicada de docs/layout.
    DRC: 0 errores, 1 aviso U401, 396 sin rutear. Paridad: 22 diferencias por el
    latch retirado; Update PCB from Schematic pendiente.
2026-10-28 PCB: Update PCB from Schematic tras retirar el latch de DO (hecho por el usuario en KiCad, F8)
    Quita las 18 huellas del latch (Q702/Q703/D702/R704-R707/C701/R701 y 75x) y
    une la fuente de Q701/Q751 a GND_VEH. Paridad con el esquematico: 0.
2026-10-28 [Claude Code] PCB: reacomodo por bloques segun docs/reference, H5 intermedio y barrera CAN
    - Entrada -> proteccion -> bulk -> buck en la esquina superior izquierda;
    pasivos de U101 junto a sus pines; C107/C106 junto a la salida de L101.
    - CAN: U601 sobre la barrera con el lado aislado hacia J1; rule area
    BARRERA_CAN en F.Cu/B.Cu (solo U601 la cruza; FB602 es aislado-aislado).
    DRU: pin 17 de U601 (AUXOUT NC) cuenta como dominio aislado.
    - DO1/DO2 bajo su pin de J2 (antes cruzados). USB-C al borde derecho con
    U402 en linea; SW401 junto al EN; C402/C401 en los pines de 3V3.
    - H5 (M3 NPTH) en esquematico y PCB junto a U501/U502, a 18 mm del eje ROT.
    - DRC 0 errores / 1 aviso U401 / parid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
2026-10-29 update pcb layout
2026-10-29 [Claude Code] PCB: revisa la ubicacion del usuario (1ff3419) y documenta reglas de USB, sensores y serigrafia
2026-10-29 [Claude Code] PCB: C403 al EN, lazos del buck, J401 al borde, courtyards y referencias 0.8 mm
    - C403 a 1.3 mm del pin EN de U401; C202 a 1.06 mm de VIN/GND de U201;
    C204-C206 en columna junto a C203; J401 -0.4 mm (sin errores de borde)
    - Courtyards: solo C403-C402 queda bajo criterio (0.7 mm)
    - Referencias 0.8/0.8/0.15 a 0/90 grados; regla JLC_serigrafia 0.8/0.15
    - DRC 0 errores, paridad 0, sin ruteo
2026-10-29 [Claude Code] PCB: H1-H5 M3 metalizados sin red, apoyo B, barrera CAN, pinout y nombre en serigrafia
    - H1-H4 a MountingHole_3.2mm_M3_Pad y H5 nuevo en (56.0, 38.5); simbolo sin pin,
    anillo flotante. Reglas H_anillo_cobre (0.5 mm) y H_zona_arandela (4 mm del centro).
    - Rule area APOYO_CAJA_B (8 mm en B.Cu, 63.5/49.0): sin pistas/vias/pads, relleno permitido.
    - Serigrafia 0.8/0.15: linea de barrera CAN y "CAN AISLADO" en ambas caras, pinout J1/J2,
    nombre/Rev/fecha abajo, rotulos de zona. Incluye el borrado de CAN_H/CAN_L del usuario.
    - DRC 0 errores, paridad 0; ERC 0 errores; sch_visual_qa raiz PASS. Sin ruteo.
2026-10-29 [Claude Code] PCB: placement-v1 - desacoples de U601, lazo del buck, C105 J16 Panasonic y zonas sin barniz
    - C601 a 1.1 mm del pin VIO (ADI Rev. D: pista <= 2 mm); C604, C607/C608 reordenados.
    - L201 y C203 mas cerca de U201 (SW 2.8 mm, BOOT 1.1 mm).
    - C105: huella INCLI-VA:CP_Elec_Panasonic_J16_VibProof (land antivibracion J16, acepta
    EEE-FK1H102AV y EEE-FK1H102AM); MPN PROD EEE-FK1H102AV.
    - Coating: zonas a enmascarar en User.Comments y rotulo "SIN BARNIZ".
    - PENDIENTES: decisiones del usuario cerradas, requisitos de la caja y plan de ruteo.
    - DRC 0 errores, paridad 0. ERC sin cambios.
2026-10-29 [Claude Code] ruteo etapa 0: net classes, pares, via 0.3/0.6 y teardrops
    - Net classes HV/DO/5V/3V3/CAN/USB con patrones por red (VA y C_ID en HV, BUCK_SW en 5V).
    - .kicad_dru: se quita la clearance sin condicion (anulaba las net classes); piso 0.15 mm en
    Board Setup; pads del mismo encapsulado por el componente; 0.6 mm para VA/C_ID/VOUT/+VPROT
    cuando interviene un pad; llegadas a U101 y U201.
    - Teardrops activados. DRC 0 errores, paridad 0. Reglas probadas con pistas de prueba.
2026-10-29 [Claude Code] ruteo etapa 1: potencia (entrada, FETs, Kelvin R103, buck U201, +5V, U301, U302)
    - Entrada y protección en F.Cu de 1.5 mm; VA entre C105 y los gates; VOUT por el borde oeste.
    - Kelvin de R103 en dos pistas paralelas hasta U101 (CS+, CS-, ISCP) con arcos en B.Cu.
    - U201: SW de 3.7 x 1.2 mm, C202 en VIN, FB alto desde C204, vía a GND en C204-C206.
    - +5V hasta FB301/U302 y U301; U301 con VIN/EN/FB cruzando bajo SW por B.Cu.
    - C104 pasa a B.Cu debajo de C105 (autorizado por el usuario).
    - .kicad_dru: sensado HV (pistas <= 0.3 mm), ZONA_U101 a 0.2 mm, VA-gates (Vgs), C202 en la llegada a U201.
    - DRC 0 errores, paridad 0, 291 sin rutear (358 antes).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
2026-10-29 [Claude Code] ruteo etapa 1 (cierre): net class PROT, lazo de U201 en F.Cu, U301 girado, gates paralelos y traspaso a Codex
    - Net class PROT (VA, C_ID, VOUT, +VPROT) a 0.6 mm; HV solo VIN_VEH/VBAT_F (1.25 mm).
    - ZONA_BUCK_U201 a 0.25 mm: retorno de C202 directo al pin 1 y EP (lazo 6.1 -> 3.9 mm2);
    C201 -> VIN 11.3 -> 8.6 mm.
    - U301 girado 180 grados y C302 junto a VIN: SW al norte en F.Cu, EN/FB/PG al sur sin cruzarlo.
    - TP101 a (127.6, 61.5) conectado a +VPROT.
    - HGATE paralela a OUT/VA; DGATE por B.Cu bajo el retorno de A/VA.
    - C104 sigue en B.Cu; caja con separadores >= 12 mm y adhesivo en C104.
    - docs/RUTEO_TRASPASO.md: estado, reglas, restricciones, plan de etapas 2-6 y trampas.
    - DRC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
2026-10-29 [Codex] ruteo: registra decisiones y criterio de desacoples para etapa 2
2026-10-29 [Codex] ruteo etapa 2: cierra CAN, terminación y verificación de longitudes
2026-10-30 [Codex] traspaso: documenta cómo retomar tras cierre de etapa 3
2026-10-30 [Codex] reglas: protege carpeta y rama de ruteo manual
2026-10-30 [Claude Code] ruteo etapa 4 parcial: U101, RESET, bus bajo el modulo, DO, supervision
    - Perifericos de U101 con los saltos B.Cu reservados; pad 25 RTN intacto.
    - RESET: tramo B.Cu movido de bajo las salidas SPI a un carril bajo el modulo
    (autorizado). SW401 68.92 mm, R802 61.59 mm.
    - DO1/DO2_EN, DO1/DO2_DIAG, PWR_FLT_N y LED por B.Cu bajo el modulo, con un
    unico cruce del par USB (autorizado). Salidas DO, +5V, LED, VAR_ID, WDI, VMON,
    R305/R307 y PG_3V3D.
    - DRC 0 errores, paridad 0, ERC sin cambios, verify_etapa3 OK. Quedan 39
    conexiones de sensores: pendiente reasignar GPIO del SPI (decision del usuario).
2026-10-30 [Claude Code] ruteo etapa 4: sensores (opcion C, U503 girado 180), cierre de etapa
    - SPI/CS, INT1/INT2, +3V3_A y SCL_AEXTC/DEXTC ruteados con GPIO actuales.
    - U503 r180, C501/C502 girados, pasivos y TP501-504 reubicados; referencias de serigrafia.
    - 12 cruces B.Cu perpendiculares con costura GND; cruce 12 (3.6 mm) aceptado.
    - Tres vias GND en el circulo del iman, tapadas en ambas caras.
    - DRC 0 errores, paridad 0, ERC 0 errores, verify_etapa3 OK; 132 pendientes, todas de masa.
    - Traspaso y pendientes: cambios de ubicacion, cifra +5V/U503 corregida a 7.6 mm, ZPOS, islas para etapa 5.
2026-10-30 [Claude Code] ruteo etapa 5: planos GND_VEH/GND_CAN/RTN, costura y cierre de conexiones
    - Zonas E5_*: GND_VEH en B.Cu y F.Cu, GND_CAN en ambas caras del dominio aislado, isla U101_RTN en B.Cu.
    - Alivio termico 0.5/0.3; conexion solida en EP de U101/U201/U401, D102.1 y J1 (regla Planos_conexion_solida).
    - 321 vias de costura: reticula, borde, anillo del ESP32, INT1/INT2, C605 y supervision.
    - C404: rama sur de VBUS reemplazada por enlace B.Cu entre las vias VBUS de J401 (autorizado).
    - DRC 0 errores, 0 sin rutear, paridad 0, ERC sin cambios, verify_etapa3 OK.
    - verify_etapa5.py: islas, cobertura, ranuras y distancia de costura; renders por capa.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
2026-10-30 [Claude Code] pendientes: traspaso para retomar la etapa 6
    - PENDIENTES.md: seccion RETOMAR AQUI con reglas, tareas de etapa 6, pendientes fuera del ruteo,
    lista para replicar en ruteo-manual y comandos de verificacion.
    - RUTEO_TRASPASO.md: enlace a esa seccion desde Como retomar.
2026-10-30 [Claude Code] ruteo etapa 6: teardrops (697) y verificador de islas que los ignora
    DRC 0 errores / 5 avisos conocidos, 0 sin rutear, paridad 0.
    verify_etapa3 OK; verify_etapa5: 1 isla por red, antena 0 mm2.
2026-10-30 [Claude Code] ruteo etapa 6: revisión de retornos, fabricación de prueba y renders
    fab/proto: gerbers, drill, stencil, BOM y CPL JLC del prototipo CAN + DO + ROT
    (133 piezas). Quedan las decisiones sobre tramos sin plano y los 5 avisos, y el push.
2026-10-30 [Claude Code] ruteo etapa 6 cerrada: costura bajo U401, serigrafía Q101/U801, ruteo terminado
    - Ranura del haz B.Cu bajo U401 medida (46.9 mm, 2.3-4.9 mm de ancho) y cosida
    con 13 vías GND (grupo CLAUDE_ETAPA6_COSTURA); pad central a plano de 7099 mm2.
    - silk_overlap Q101/U801 corregidos moviendo solo las referencias.
    - Excepciones aceptadas: 2 silk_edge_clearance y lib_footprint_mismatch de U401;
    tramos sin plano de la etapa 5.
    - fab/proto regenerado; el zip deja de versionarse (fab/**/*.zip).
    DRC 0 errores / 3 avisos aceptados, 0 sin rutear, paridad 0, ERC sin cambios.
2026-10-30 [Claude Code] etapa 6: correcciones de la revisión independiente
    - Stencil y pasta de gerbers sin aperturas en los 12 componentes DNP.
    - Notes de C602 corregido (cadena tras C601, ~6 mm, aceptado).
    - «K» de cátodo en serigrafía junto a D101-D103, D701 y D751.
    - verify_etapa5: teardrops entre filas de U601 (0); regla ISO registrada como verificada.
    - CPL/BOM de JLC (cpl_jlc.csv, bom_jlc.csv) sin THT ni U401, con rotaciones por
    familia (JLCKicadTools) y posición al centro de pads; cpl_proto.csv eliminado.
    - Registrados como aceptados: H5 sin acero, par CAN asimétrico, C104 a 1.6 mm del
    borde y placa sin V-cut. Hallazgos 2 (imán) y 4 (courtyards) esperan aprobación.
    DRC 0 errores /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
2026-10-30 [Claude Code] etapa 6: imán arriba, C401 movido y registro de pasivos pendientes
    - Imán de ROT en F.Cu: portaimán de Ø <= 8.7 mm o cara a >= 3.8 mm de la placa
    (U501 a 4.88 mm del eje, C503 a 7.24 mm); H5 no magnético. En requisitos de la caja.
    - C401 (189.2,100.6) -> (189.2,99.8) con reconexión (etapa6_mover_pasivos.py):
    C401-C402 0.23 -> 1.03 mm. C402 sin mover (pista al pin 3V3 en 1.98 mm, límite 2 mm).
    - C404, C507, R502 y C506 no se movieron: chocan con USB D±, +3V3_A o IMU_INT1/2
    (probado con DRC uno por uno); esperan decisión. 16 pares aceptados como excepción.
    - Zonas, teardrops y fab/proto regenerados.
    DRC 0 errores / 3 avisos aceptados, 0 sin rutear, paridad 0; ERC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
2026-10-30 [Claude Code] PCB cerrado: C508 movido, excepciones de courtyard y portaimán preferido
    - C508 (168.7,90.3) -> (167.9,90.3) en lugar de R502: R502-C508 0.23 -> 1.03 mm.
    - Excepciones aceptadas: C402-U401, C404-U402, C507-U503, C505/C506-U502 y 16
    pares con >= 0.86 mm entre pads. U502-C506: 0.23 mm entre courtyards, 1.17 mm
    entre pads y pasta (sin ajuste de stencil).
    - Caja: portaimán preferido Ø <= 8.7 mm; mayor solo con air gap 2.6-3.0 mm.
    DRC 0 errores / 3 avisos aceptados, 0 sin rutear, paridad 0; ERC sin cambios;
    verify_etapa3/5 OK. Siguiente: BOM con códigos LCSC.
    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
2026-10-30 [Claude Code] pendientes: PCB integrado en main (pcb-v1-rc1)
2026-10-30 [Claude Code] docs: el trabajo continúa en main (pcb-v1-rc1); ruteo-agente integrada
2026-10-30 [Claude Code] pendientes: opciones del pedido a JLCPCB (pcb-v1-rc1)
2026-10-30 [Claude Code] bom: códigos LCSC, sustitutos y costo por placa (consulta 2026-10-30)
    - docs/BOM_SOURCING.md: tabla PROTO completa y diferencias PROD, con estados
    de la skill agentic-sourcing (solo jlc_lookup.py, sin sourcing.py).
    - fab/proto/bom_jlc_lcsc.csv: BOM de JLC (63 líneas; sin L201 ni U503).
    - bom/BOM_PROTO.csv, bom/BOM_PROD.csv, bom/LCSC_CART_PROTO.csv,
    bom/DIGIKEY_MOUSER.csv.
    - Sin cambios en el esquema ni en el PCB. No se hizo ningún pedido.
2026-10-30 [Claude Code] bom: decisiones de sustitutos, listas JLC/a mano y costo recalculado
    - Q101, Q102 y F101: sustitutos rechazados; originales de DigiKey/Mouser,
    soldados a mano. Fuera de bom_jlc_lcsc.csv y de cpl_jlc.csv (junto con
    L201 y U503): 60 líneas, 123 piezas, BOM y CPL coinciden.
    - C101, C201, C104: sustitutos sin AEC-Q200 solo en PROTO; PROD mantiene
    los originales.
    - SCL3300-D01-10 aceptado (Murata Doc. 4921 Rev. 2, §9: carrete de 1000 u).
    - Nuevo bom/A_MANO_PROTO.csv (5 placas + 1, con proveedor).
    - Costo por placa: PROTO 111.48 / 90.88 USD; PROD 107.84 / 89.62 (5 / 100).
    - Sin cambios en el esquema.
2026-10-30 [Claude Code] etapa6_fab: F101, Q101, Q102, L201 y U503 a mano; conserva bom_jlc_lcsc.csv
    - MANO suma F101, Q101 y Q102 (originales de DigiKey/Mouser) y L201 y U503
    (sin stock en JLC): al regenerar quedan fuera de bom_jlc.csv y cpl_jlc.csv.
    - El script borra solo gerbers/ y stencil/, no fab/proto/ entero, para no
    perder bom_jlc_lcsc.csv, que se mantiene a mano.
    - Regenerado y verificado: bom_jlc.csv, bom_jlc_lcsc.csv y cpl_jlc.csv con
    60 líneas, 123 piezas y las mismas designaciones. Gerbers, drill y
    stencil sin cambios de contenido (solo la fecha; se conservan los del
    commit anterior).
2026-10-30 [Claude Code] esquema+PCB: campos LCSC y sustitutos PROTO del BOM (pcb-v1-rc2)
    - Esquema (solo campos, ocultos): LCSC en todos los componentes; MPN_PROTO,
    LCSC_PROTO y Manufacturer_PROTO con los sustitutos aceptados; Notes con
    compra y montaje (Q101, Q102, F101, L201, U503 a mano desde DigiKey/Mouser).
    MPN (PROD), valores, huellas y conexiones sin cambios. LCSC Part -> LCSC.
    - PCB: mismos campos en las 145 huellas, insertados como texto (equivalente
    a F8 solo para campos); nada cambia fuera de las huellas.
    - ERC por hoja igual que antes (0 errores, 5 avisos). DRC 0 errores / 3 avisos
    aceptados, 0 sin rutear, paridad 0 (antes de sincronizar: 145).
    - etapa6_fab.py usa los campos _PRO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
2026-10-30 [Claude Code] bom: LCSC_BOM_COMPLETO_PROTO.csv para Upload a BOM de lcsc.com
    64 líneas, 2629 piezas: PROTO sin DNP ni DigiKey/Mouser; por placa × 6,
    mínimo 20 en pasivos 0402/0603, subido a MOQ y múltiplo de lcsc.com.
    C1634 y C57112 sin stock en lcsc.com (anotado en PENDIENTES).
2026-10-30 [Claude Code] PCB: fiduciales FID1–FID3, relleno/teardrops, máscara roja, fab regenerado (pcb-v1-rc3)
    - FID1–FID3 (Fiducial_1mm_Mask2mm, F.Cu, sin red, fuera de BOM/CPL) en
    esquema raíz y PCB; etapa6_fiduciales.py.
    - Relleno de zonas: vuelven los 5 teardrops perdidos en «update serigrafia»;
    DRC 0 errores / 3 avisos aceptados, paridad 0, ERC 0 / 5 avisos.
    - Máscara roja: puentes ≥ 0.15 mm (U502) contra 0.10 mm de JLC (1 oz).
    - fab/proto regenerado. LCSC: sustitutos C303 y C601/C607 (VERIFY).
    - Logos en B.Silkscreen pendientes para rc4 (faltan los archivos).
2026-10-30 [Claude Code] PCB: logo Volnyx (B.Silk), ejes de la placa (F.Silk), reserva Hunter (pcb-v1-rc4)
    - LOGO1 Logo_Volnyx_Wordmark 17 x 4.48 mm en (160.0, 121.5), solo de placa.
    - Ejes dextrógiros +X derecha, +Y arriba, ⊙Z en (143.0, 87.5).
    Firmware: U502 identidad; U501 X=Y_U501, Y=X_U501, Z=Z_U501;
    validar con la prueba de 6 posiciones (PENDIENTES).
    - Zona de 16 x 6 mm reservada para el logo de Hunter (rc5), en User.Comments.
    - DRC 0 errores / 3 avisos aceptados, paridad 0, ERC 0 / 5; fab/proto regenerado.
2026-10-30 [Claude Code] serigrafía: rótulos TX/RX/GND y UART0/3V3 de J402 en ambas caras
    - Pad 1 TX (U0TXD), pad 2 RX (U0RXD), pad 3 GND, verificado con las redes; 0.8 mm.
    - «UART0 / 3V3» entre J402 y H4; ref. J402 vertical; L de pin 1 también en B.Silk.
    - Revisión de rótulos: falta «USB» en J401 (pendiente de decisión).
    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
2026-10-30 [Claude Code] serigrafía: rótulo «USB» junto a J401
    - F.Silkscreen, 0.8 mm / 0.15 mm, en (190.5, 75.4), fuera de la zona SIN BARNIZ.
    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
2026-10-30 [Claude Code] TP de la cara inferior rotulados, TP406/TP505 GND con agujero, R803/R804 2.2k
    - B.Silk: nombre de señal junto a cada TP (verificado con la red), GND con recuadro,
    nota «CAN: medir vs GND_CAN (J1-5)».
    - TP406 (40_mcu) y TP505 (50_sensors): GND_VEH THT D2.5/1.2 mm, en esquema y PCB,
    fuera de BOM/CPL.
    - LEDs: R803/R804 470 → 2.2k (0603WAF2201T5E C4190 basic; PROD AC0603FR-072K2L);
    ~0.61 / 0.70 mA; brillo por PWM (PENDIENTES, firmware).
    - DRC 0 errores / 3 avisos aceptados, paridad 0, ERC 0 / 5; fab/proto y BOM regenerados.
2026-10-30 [Claude Code] bom: compra principal en LCSC + DigiKey/Mouser; consolidación de pasivos
    - Plan: JLC solo PCB + stencil Top; componentes de LCSC soldados a mano.
    - Consolidación (solo valor/campos): R702/R752 4k7 → 2.2k; 23 × 100 nF a un
    MPN de 100 V X7R; PROTO 1 µF 50 V y 10 µF 25 V X7R. BOM PROTO 70 → 68 líneas.
    - LCSC_BOM_COMPLETO_PROTO.csv: 6 juegos, 62 líneas, USD 552.43 (3 juegos: 286.65).
    - DIGIKEY_MOUSER.csv: L201, U503, Q101, Q102, F101 (0 en LCSC), ≈ USD 99.54.
    - Resumen de costos en BOM_SOURCING.md; archivos de JLC al día como alternativa.
    - DRC 0 errores / 3 avisos aceptados, paridad 0, ERC 0 / 5.
2026-10-31 [Claude Code] bom: 3 juegos; F101 verificado (2 A 250 VDC); L201 alternativa XGL6060
    - LCSC_BOM_COMPLETO_PROTO.csv para 3 juegos: 62 líneas, 2312 piezas, USD 286.65.
    - DIGIKEY_MOUSER.csv: Qty_PROTO_3_juegos; F101 SF-2410FPA200W-2 a ≈ USD 1.48
    (pieza exacta). Total ≈ USD 337.77, ≈ USD 168.89 por placa armada.
    - L201: XGL6060-333MEC como alternativa aprobable (misma huella y land pattern;
    Isat 4.0 A al 30 %, Irms 3.6 A, DCR 69.5 mΩ); muestras a pedir a Coilcraft.
    Esquemático sin cambios.
2026-10-31 [Claude Code] pendientes: pcb-v1-rc5 enviada a fabricación
    RETOMAR AQUÍ con el tag rc5 (7b8a62e), zip y sha256, pedido y pendientes:
    logo de Hunter (rev B), muestras de L201, revisión independiente, bring-up, firmware.
2026-10-31 revision externa y DFM de JLC
2026-10-31 [Claude Code] rc6: grupo A de la revisión externa y JLCDFM (pcb-v1-rc6)
    Esquema (hoja 10), aprobado por el usuario:
    - R-01: UVLO desde VBAT_F (R113 + R106 51k 1206, cara inferior junto a TP102),
    R107 9.53k (corte 6.44 V), U101.3 (SW) con no-connect. TI SNOSDF6 fig. 8-1.
    - R-02: D104 = BAV23C (Diode:BAV70): A2-K es el D1 de VA a VS de TI.
    PROTO Diodes BAV23C-7-F (C150732); PROD Nexperia BAV23C,215.
    - R-26: TP105 VS, TP106 VA, TP107 UVLO (cara inferior).
    - Notes C-1..C-14, R-17, R-29; README, REVISION_CODEX, BOM_SOURCING.
    PCB, sin mover componentes existentes:
    - UVLO por B.Cu (y90 -> x111 -> y74.5) con 10 vías de costura GND_VEH.
    - VA a D104.2 por x = 132.1.
    - J-01 vías a 0.15 mm de lo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
2026-10-31 [Claude Code] rc7: JP601, selector de terminación CAN por puente de soldadura (pcb-v1-rc7)
    - Hoja 60: JP601 (Jumper:SolderJumper_2_Open, abierto) en serie con R602; red nueva
    /60_can/CAN_TERM_H. Abierto = sin terminación; unido con estaño = 120 Ω. Fuera de BOM y CPL.
    - PCB: JP601 en la cara inferior (114.6, 125.3), dentro de la isla GND_CAN, vías V1/V2,
    «TERM CAN» en B.Silkscreen. Sin mover componentes. CAN_TERM_H en ISO_CAN_barrera.
    - ERC 0 errores / 5 avisos conocidos; DRC 0 errores / 3 avisos aceptados; paridad 0;
    716 teardrops; fab/proto regenerado.
