elvisdt/PCB_INCLI_VA/(notices)

Notices in the files:
parts and their libraries:
License: Apache-2.0
